randyrossi/vicii-kawari/boards/README.md

# Toolchain Versions

Xilinx Spartan6 boards : ISE 14.7
Efinix Trion boards : Efinity 2021.2.323.1.8
