randyrossi/vicii-kawari/util/raspi/README.md

# flash.py

A utility to flash Mini/Large Trion VIC-II Kawari boards using a Raspberry Pi. (Spartan6 boards require a Xilinx JTAG programmer.)

## Enable the SPI interface on the Raspberry Pi

    sudo raspi-config
    Select "Interfacing Options"
    Select "P4 SPI"
    Answer "Yes" when asked to enable the SPI interface.
    Reboot the Pi for the change to take effect

## Programming pad arrangements (top side of boards)

There is a 2x3 array of pads (+ 7th solder bridge) on the top of the board.

### For the Mini (rev 1.3 or 1.4 - bottom of board)

    MISO  CS    +3V  RST (left pad of solder bridge)
    GND   MOSI  CLK

### For the Large (rev 1.2 - right side of board)

         RST (bottom pad of solder bridge)
    GND  CS
    MISO MOSI
    CLK  +3V

Note: The solder bridges were meant to be temporarily closed and then re-opened for programming.  But if you plan on programming multiple times, better to solder a wire to the left or bottom pad (depending on mini / large).

## Wiring

    MOSI -> PIN 19
    MISO -> PIN 21
    CLK -> PIN 23
    CS -> PIN 24
    GND -> PIN 20
    RST (from solder bridge) -> Pin 25 (or just temp bridge the solder bridge)

## Power

The board must be powered by a +5V source.  You can use the C64's VIC-II socket as the power source or wire your own directly to pin 20 (GND) and pin 40 (+5V) of the bottom socket.

## Usage

   python3 flash.py read|write filename size

The files must be binary (.bit) files. Use the multi_hex_to_bit utility in the flash directory to convert .hex files to .bit.  The .hex files must be created using Efinity tools where the fallback image appears in slot 0 and the active image appears in slot 2.  The .bit files must match the expected file sizes exactly (as in the examples).

The Kawari will NOT BOOT if you have the RST pin still connected to Pin 25 (GND) of the Pi.  It is best to disconnect all wires from the Pi before booting the Kawari.  The connections will likely interfere with the FPGA loading the bitstream from the flash device. (You can leave the wires soldered, just disconnect from the Pi header)

## Examples

#### Flash to PCB

   python3 flash.py write bitstream.bit

#### Read from Mini PCB

   python3 flash.py read read_back.bit 1318912

#### Read from Large PCB

   python3 flash.py read read_back.bit 1359872
