randyrossi/vicii-kawari/boards/rev_4J/README.md

# POV

Change 4H(Mini) BOM as follows:

   Omit both oscillators
   Omit oscillator capacitors
   Omit oscillator resistors
   Omit eeprom
   Change T20 to T8

   DNP PAL1 (OSC)
   DNP NTSC2 (OSC)
   DNP C35
   DNP C36
   DNP R29
   DNP R30
   DNP R67
   DNP R4
   DNP IC1 (EEPROM)
