randyrossi/vicii-kawari/disks/demo/racer80/README.md

# VIC-II Kawari Version of Racer

This is a VIC-II Kawari version of racer adpated to fit 80 columns.
Use '4' to move left and '6' to move right.

Before running this sample, you must load and run the 80col-51200 wedge
AND load the vmem-49152 utility routines from the utility disk.

Initial submission by Jan Bloomvqvist.
Updated to use vmem-49152 utility by Randy Rossi
