randyrossi/vicii-kawari/disks/util/novaterm/README.md

# Novaterm 9.6c 80 Column Driver for VICII-Kawari

To install this, just rename kawari.ml as 80col.kawari and save it to the Novaterm 9.6c disk.  It will then show up as an option for an 80 column driver.

NOTE: MAX size of kawari.ml is 1791 bytes
