randyrossi/vicii-kawari/disks/util/flash/hex/multi/README.md

These files are created using efinity_pgm.sh tool.
This is manual step.

Point slot 00 to single hex file from single dir.
Point slot 10 to single hex file from single dir.

Create multi.hex file.  Use these naming conventions
so build_efinix.sh will find them.

kawari_1.19_1.19_multi_LG_DVI-27MHZ-S.hex
kawari_1.19_1.19_multi_LG_DVI-29MHZ-U.hex
kawari_1.19_1.19_multi_LG_RGB-32MHZ-U.hex
kawari_1.19_1.19_multi_LH-DOTC-1.2.hex
kawari_1.19_1.19_multi_LH-DOTC-1.5.hex
kawari_1.19_1.19_multi_LH.hex
