randyrossi/vicii-kawari/doc/MODELS.md

Back to [README.md](../README.md)

# Feature / PCB Design Matrix

PCB Design             |Kawari-Large<br>Spartan|Kawari-Large<br>Trion|Kawari-Mini<br>Trion|Kawari-POV<br>Trion|
-----------------------|------------|------|------------|----------|
Luma/Chroma            |Yes         |Yes   |Yes         |Yes       |
Extra RAM              |64K         |64K   |64K         |No        |
Flash updates from C64 |Yes         |Yes   |Yes         |Yes       |
New Video Modes        |Yes         |Yes   |Yes         |No        |
Detect Reset           |Yes         |Yes   |No          |No        |
Analog RGB             |Yes         |Yes   |No          |No        |
NTSC/PAL               |Switch      |Switch|Switch      |Fixed     |
Jumper Config MB Clk   |Yes         |Yes   |Yes         |Yes       |
DVI                    |Yes         |Yes   |No          |No        |
NTSC 50                |Yes         |Yes   |Yes         |No        |
Saveable Config        |Yes         |Yes   |Yes         |No        |
Old chips?             |Yes         |Yes   |Yes         |No        |
Current Draw           |~180ma      |~300ma|~180ma      |TBD       |
Variants               |(null),LD   |LG    |LH          |LJ        |

# Jumpers

Jumper configuration depends on the board version.  See [VARIANTS.md](VARIANTS.md)

# Feature Descriptions

## Luma/Chroma 
PCB is capable of Luma/Chroma based video (i.e. Composite or S-Video through the video out jack)

## Flash from C64
PCB firmware can be updated from the C64 using a flash utility disk

## New Video Modes
PCB can enable new video modes (i.e. 80 column mode)

## Analog RGB
Analog RGB header is present and can drive a VGA or RGB monitor.

## NTSC/PAL
JP Fixed : PCB must be configured as NTSC or PAL but cannot switch between standards. Motherboard clock must be working.

Switch : PCB can be told to boot as either 6567 (NTSC) or 6569 (PAL) (either by hardware switch or software selection). Motherboard clock is optional.

## Jumper Config MB Clk
PCB can be configured via jumper to use the mother board clock for either NTSC or PAL. (Used to avoid out of phase issue with some carts that use pin 6.)

## Old Chips
PCB can be configured to act as older NTSC and PAL models 6567R56A or 6569R1.

## DVI
PCB can output DVI over a HDMI connector (no audio).

## NTSC 50
Switch available to use NTSC color encoding with a PAL video signal. Allows color displays on 1702 or 1084 monitors (use VHOLD to get sync).

## Detect Reset
PCB can optionally connect to RESET line of motherboard.  This will restore colors to default values and turn off hires video modes after a soft reset.

## Saveable Config
PCB can remember changes to palette and other video settings between cold boots.
