randyrossi/vicii-kawari/doc/REPORTING.md

# Testing Firmware?

For those testing firmware (Thank you!), here are some some guidelines to avoid false positives:

1. Many games and demos are made for PAL systems only.  They will either not run at all on NTSC or show graphical glitches.  This is normal and happens on genuine VIC-II's as well. Since the Kawari can operate in either mode, you may lose track of which video standard you are running (especially over DVI where they look similar). If you find a glitch, please confirm the issue does not also occur using a genuine VIC-II in the same mode. If the issue happens using only the Kawari, then please report it.

2. GAL PLA replacement modules that use Lattice 25ns GALs are known to lock up the system on some games even with a real VIC-II (i.e. Ghostbusters, Fix it Felix Jr).  If you are using a PLA replacement, please try a genuine PLA if possible in the same machine to confirm it is not the PLA.  If the issue also happens with a genuine PLA, please report it.

3. A quick way to confirm whether a glitch is expected or not is to simply run the same game/demo on VICE emulator using x64sc.  You can start x64sc with -ntsc or -pal command line flags to match the system the game/demo is expecting.  If you see the same glitch, it is likely normal/expected.

4. Different KERNAL revisions clear the screen differently and this can make some games/demos appear to glitch on one system while run fine on another. An example is Higher Level (1992) by Lower Level. Another example is Galencia with a trainer screen that asks you to answer 4 Y/N questions.  On the earliest KERNAL revision, it appears the game has crashed because you get a black screen.  However, the trainer is just waiting for you to answer questions that are not visible. This is why comparing behavior with/without the Kawari on the same machine can be important.

5. Cartridges that use pin 6 (dot clock) of the cartridge port will often not work unless you use the motherboard clock setting. Keep that in mind when testing with specialty cartridges (i.e. REU)

6. If you are using a KungFuFlash cartridge, make sure you are using a recent firmware build.  Older KFF firmwares did not handle NTSC timing very well and caused many glitches.  If you have been using a PAL system for a long time with a KFF and are now running NTSC mode, you should update the firmware to avoid issues. 

7. KFF has trouble with systems whose clocks are too far off from the ideal NTSC or PAL color clock frequencies (with genuine VICs).  If you chose to use either NTSC or PAL motherboard clock as the source, there is a trimmer on the motherboard that can adjust the clock. Use that in combination with KFF's clock trimmer functionality to get better compatibility.  Using a Kawari on-board oscillator will perform better than motherboard clocks because it is generally of a higher quality.

8. If you use the motherboard's clock source for either NTSC or PAL and are getting a B&W picture, try adjusting the trimmer.

9. 250469 motherboards are not supported.  The Kawari is not a replacement for 8562/8565 chips. There are lots of known incompatibility issues.

# Known Issues (Not Kawari)

Issue|Description|Board|Details
-----|-----------|-----|-------
1 | Ghostbusters loaded from disk hangs on title screen | 250407 | Known to be caused by GAL PLA w/ Lattice 25ns GALs. Interesting though that the Ghostbusters cartridge when loaded by Kung Fu Flash does NOT crash this way.
2 | Fix if Felix Jr hangs after title animation         | 250407 | Same as #1
3 | Ghostbusters opening speech and laugh inaudible at startup. Music plays fast. After pressing RUN/STOP + RESTORE, speech + laugh now audible and speed is normal | 250407 | Happens when loading cartridge using Kung Fu Flash. Doesn't appear to happen when loading from disk.
4 | The kernel revision can change how some games/demos show color. | Any | See #4 above , (Higher Level, Quality - Father Time, Galencia Trainer)
5 | Checkerboard pattern using replacement RF modulator from VGP media.  | Any| Solution was to jumper JPLUM1 on the RF modulator for the Long Boards.
6 | Sparkle bug | Any | Caused by original CHAR ROM 901225-01 from the first week of 1983. The ROM timing must be a bit slower. The -02 revisions fix the issue.
