randyrossi/vicii-kawari/disks/demo/krps/jpg2krps/wednesday.jpg

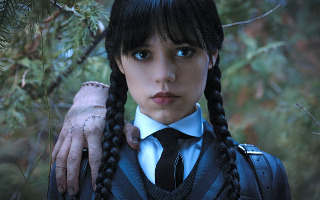
disks/demo/krps/jpg2krps/wednesday.jpg
