randyrossi/vicii-kawari/doc/images/c64-ntsc-full-annotated.png

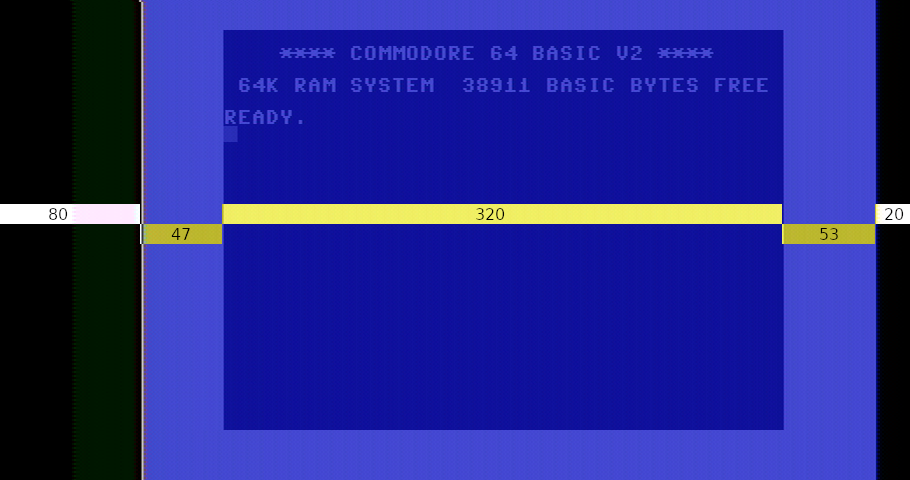
doc/images/c64-ntsc-full-annotated.png
