randyrossi/vicii-kawari/doc/images/c64-pal-full-annotated.png

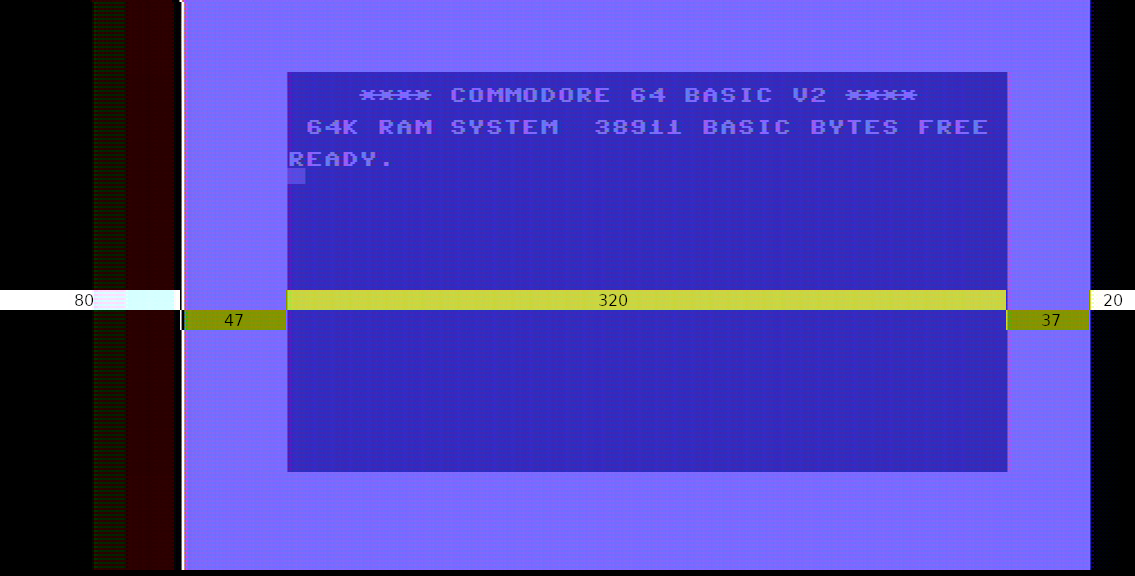
doc/images/c64-pal-full-annotated.png
