randyrossi/vicii-kawari/doc/images/lumacode/IMG_0302.jpg

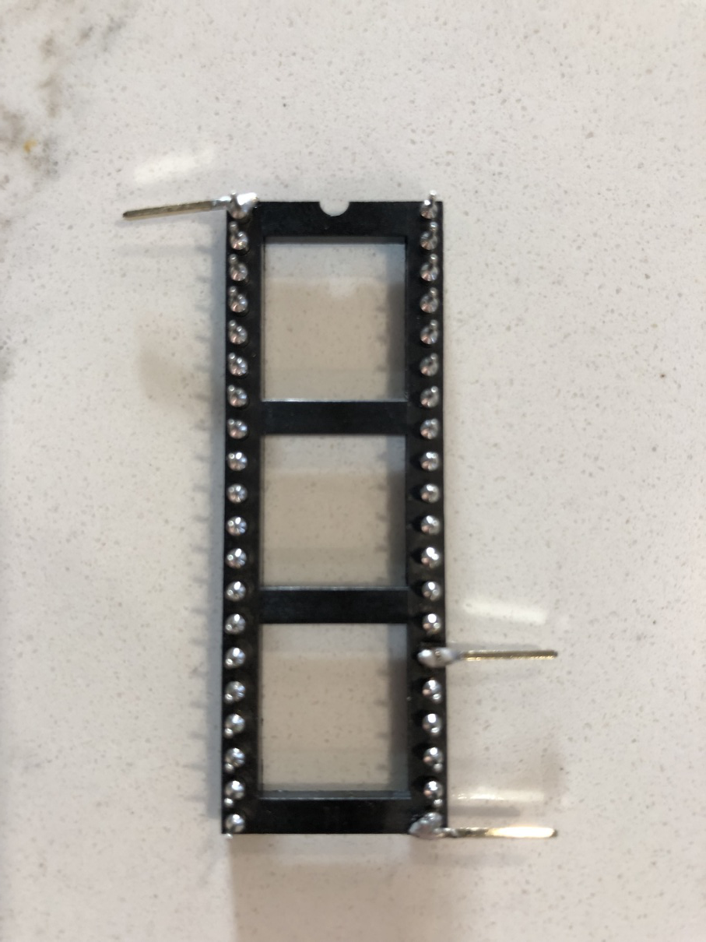
doc/images/lumacode/IMG_0302.jpg
