randyrossi/vicii-kawari/doc/images/lumacode/IMG_0308.jpg

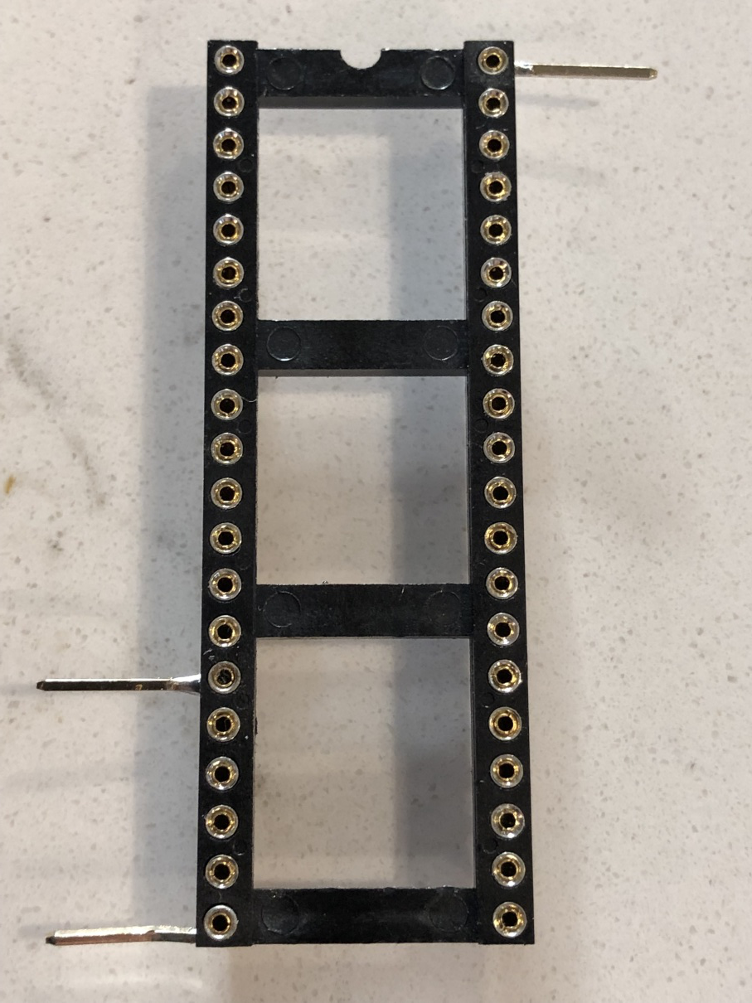
doc/images/lumacode/IMG_0308.jpg
