randyrossi/vicii-kawari/doc/images/lumacode/IMG_0309.jpg

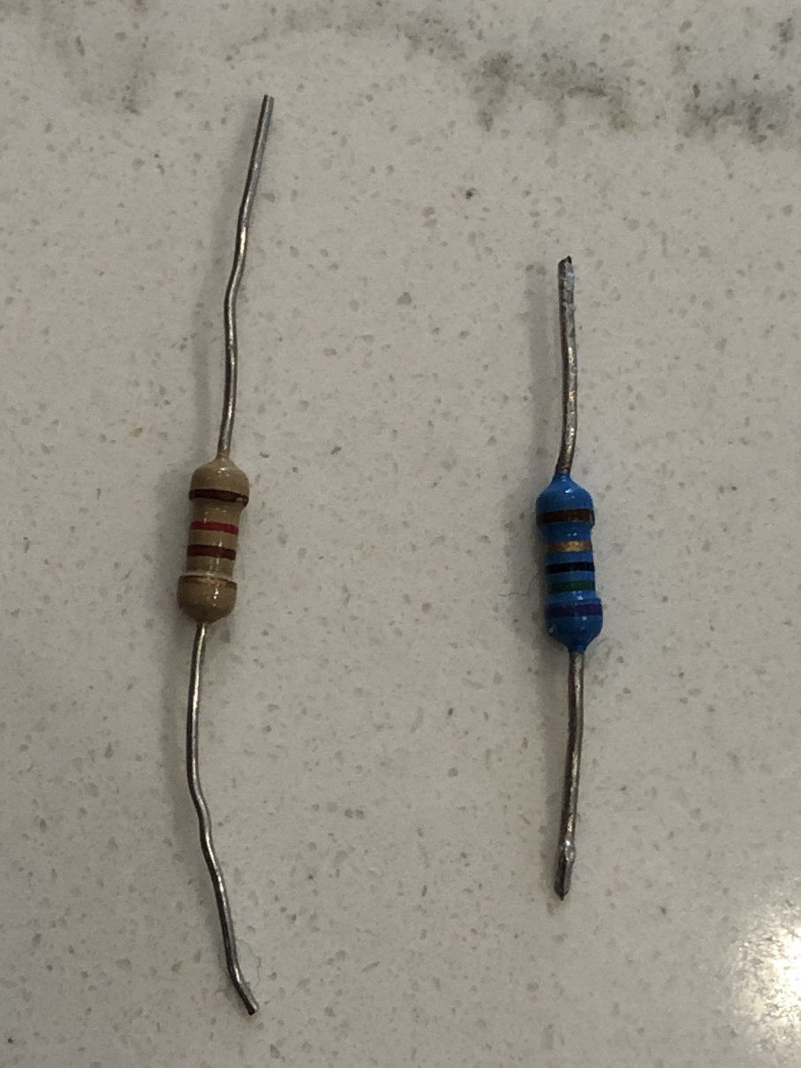
doc/images/lumacode/IMG_0309.jpg
