randyrossi/vicii-kawari/doc/images/lumacode/IMG_0312.jpg

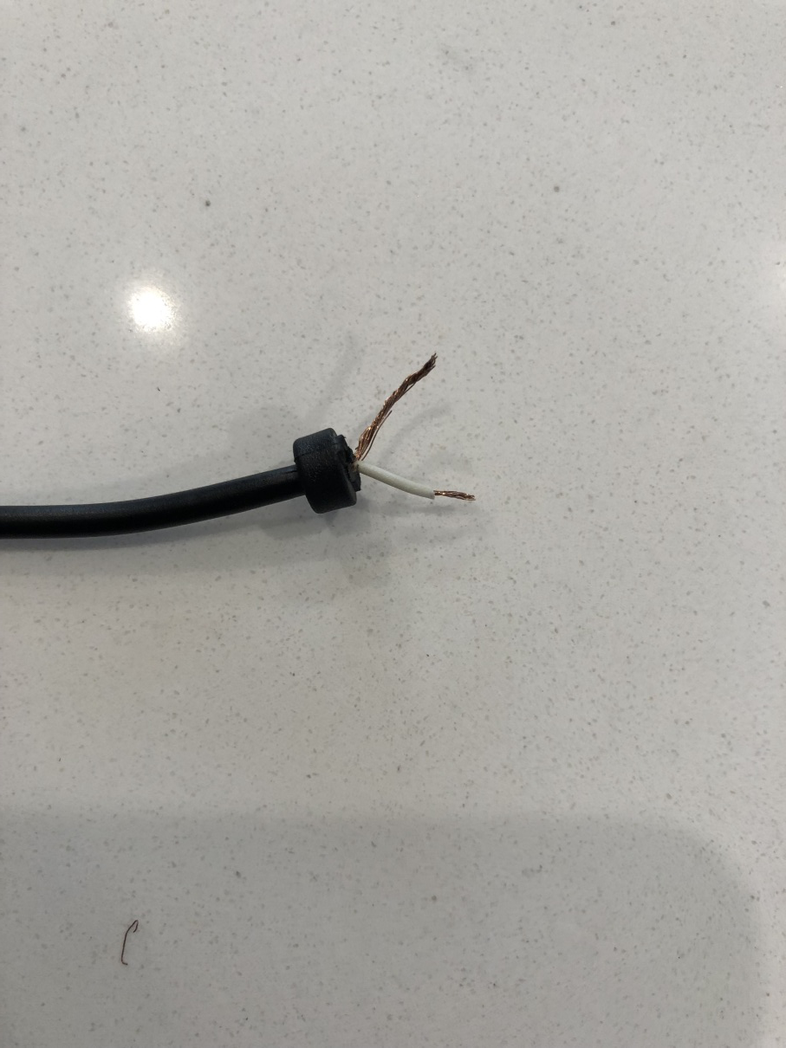
doc/images/lumacode/IMG_0312.jpg
