randyrossi/vicii-kawari/doc/images/lumacode/IMG_0313.jpg

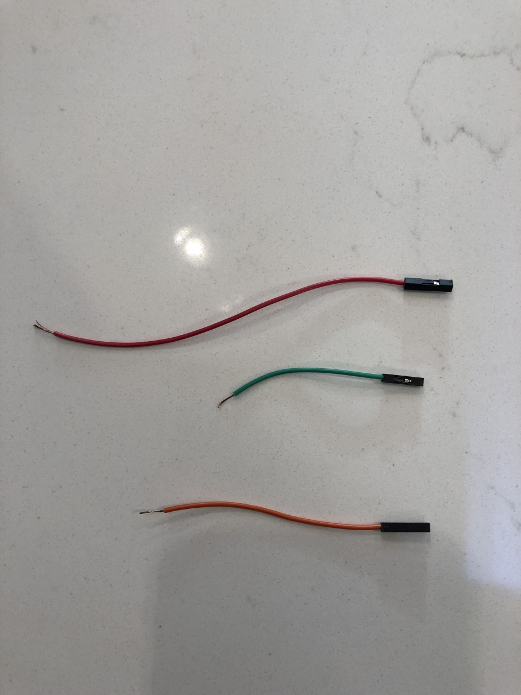
doc/images/lumacode/IMG_0313.jpg
