randyrossi/vicii-kawari/doc/images/lumacode/IMG_0316.jpg

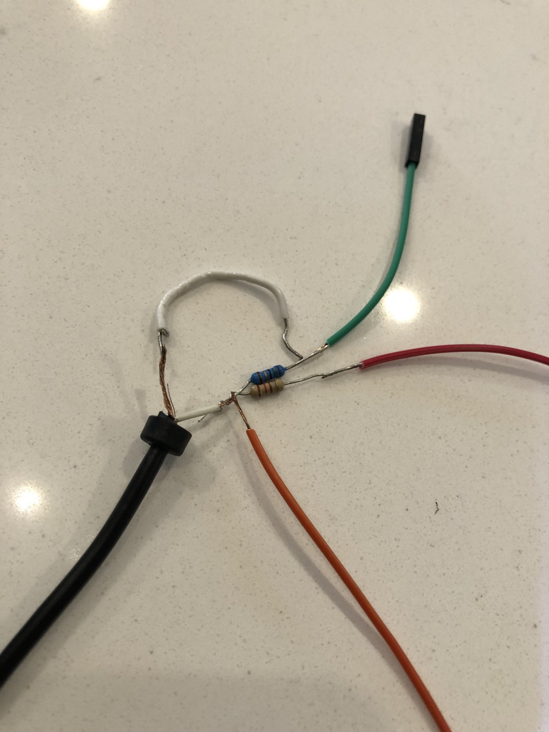
doc/images/lumacode/IMG_0316.jpg
