randyrossi/vicii-kawari/doc/images/lumacode/IMG_0318.jpg

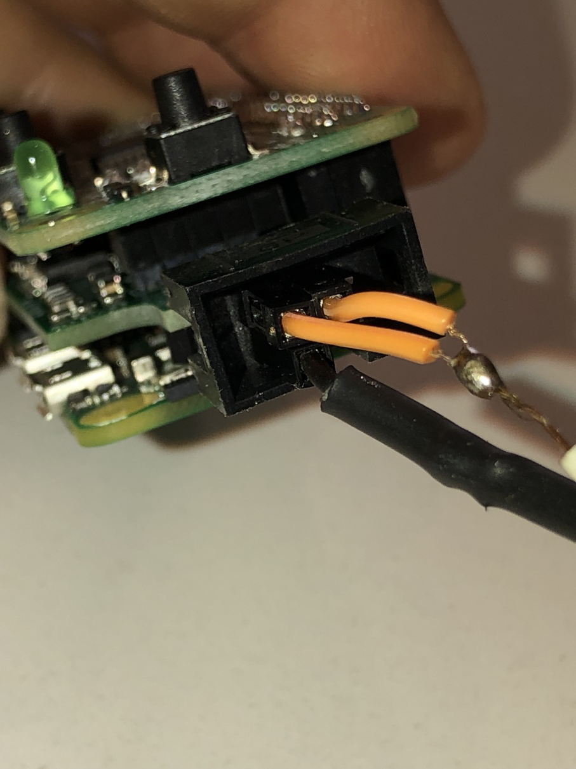
doc/images/lumacode/IMG_0318.jpg
