randyrossi/vicii-kawari/doc/images/lumacode/IMG_0322.jpg

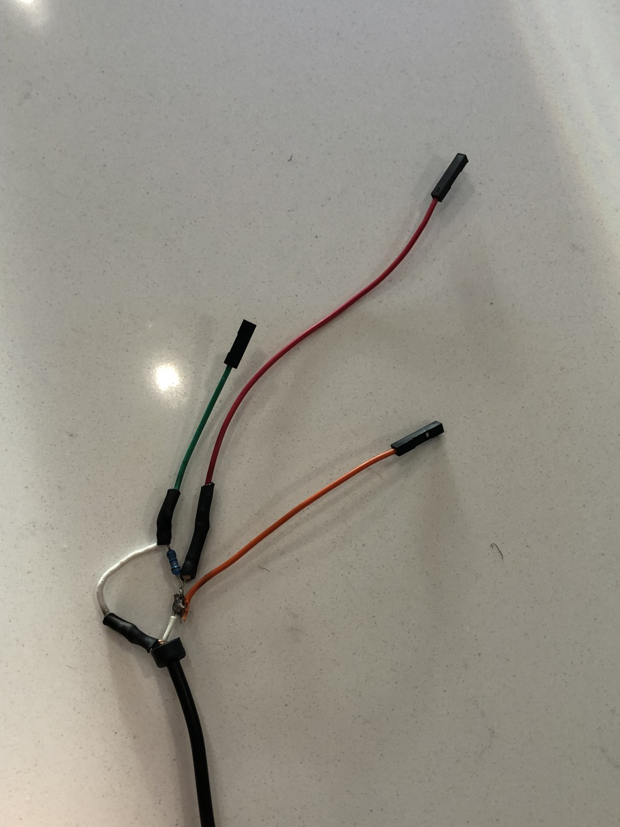
doc/images/lumacode/IMG_0322.jpg
