randyrossi/vicii-kawari/doc/images/lumacode/IMG_0324.jpg

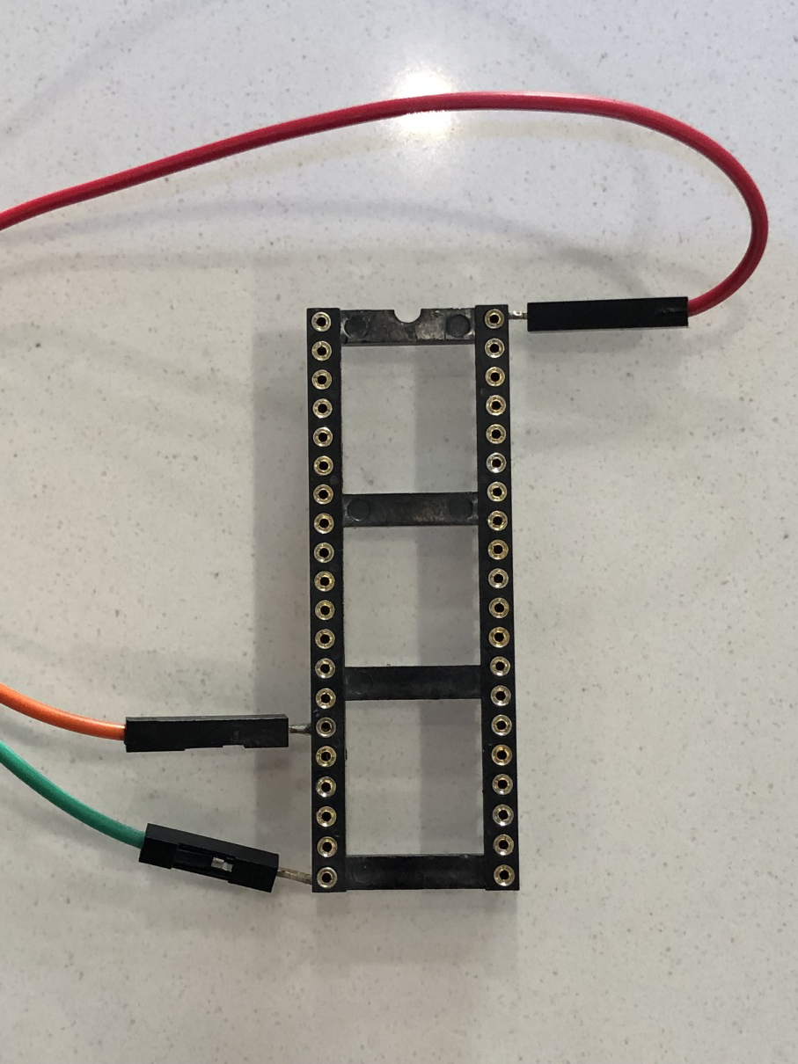
doc/images/lumacode/IMG_0324.jpg
