randyrossi/vicii-kawari/doc/images/lumacode/IMG_0328.jpg

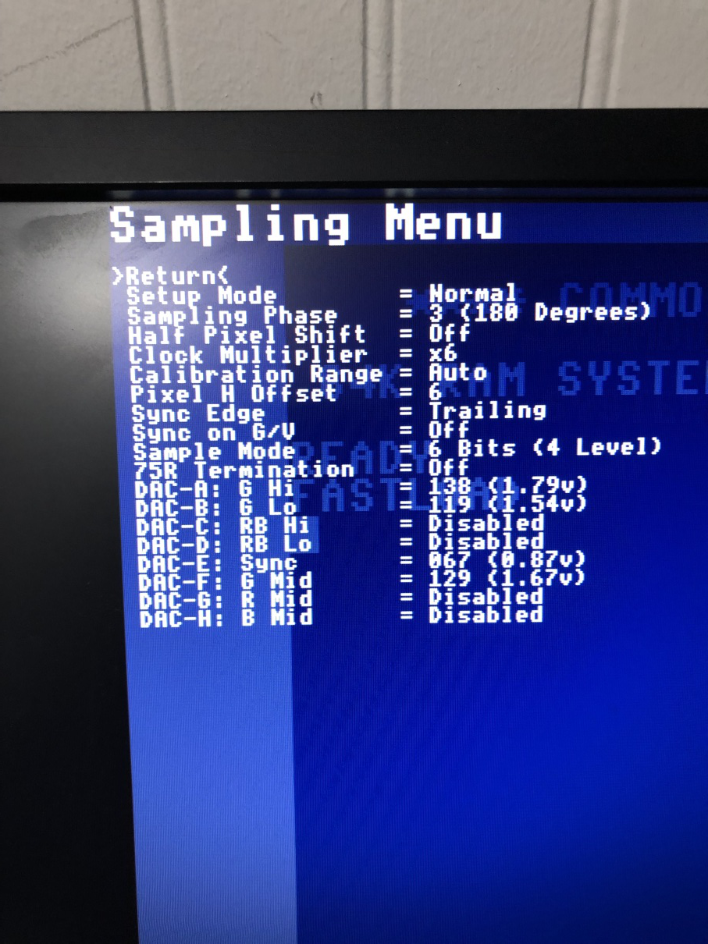
doc/images/lumacode/IMG_0328.jpg
