randyrossi/vicii-kawari/doc/images/lumacode/IMG_0329.jpg

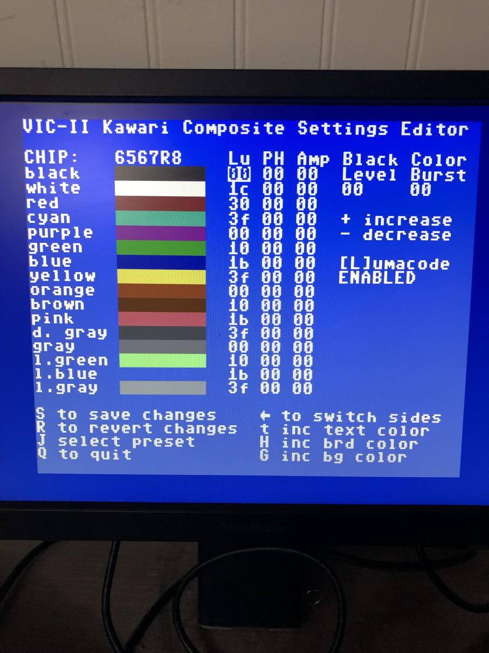
doc/images/lumacode/IMG_0329.jpg
