randyrossi/vicii-kawari/disks/util/tests/lumatest/README.md

Use to test proper resistor values have been
installed on the luma pin.

Set oscilloscope to 1V , 500us horiz timing.
Should see smooth sine wave with occasional break due to black bar
