randyrossi/vicii-kawari/disks/util/tests/rgbtest/README.md

Use to test proper resistor values have been
installed on the analog RGB header.

Set oscilloscope to 1V , 500us horiz timing.
Should see smooth sine wave with occasional break due to black bar

Hold C and V keys to slow it down.

Press SHIFT to move to next color channel.
