randyrossi/vicii-kawari/doc/BOARD_TESTS.md

# Boards

Motherboard Revision | RAM              | PLA      
---------------------|------------------|----------
250407               | DRAM 150ns       | Orig PLA 
250407               | SRAM (DIY Chris) | Orig PLA 
250425               | DRAM 200ns       | Orig PLA 
326298               | DRAM 200ns       | Orig PLA 
250466 (Sixty Clone) | DRAM 100ns       | J-PLA    
250466 (Sixty Clone) | SRAM (Saruman)   | J-PLA    
250469               | DRAM 100ns       | Orig PLA 

# Other (not tested by me)

Motherboard Revision | RAM              | PLA      | Status
---------------------|------------------|----------|-------
EVO                  | SRAM             | EVO PLA  | Reported working
Melius               | SRAM             |          | Reported working
