randyrossi/vicii-kawari/doc/TESTING.md

# Testing Checklists

# Hardware Permutations

Test                   | Complete
-----------------------|---------
Genuine 6510           |
Replacement 6510       |
Genuine DRAM           |
Static DRAM Saruman    |
Static DRAM CBM        |
Genuine PLA            |
Replacement PLA J-PLA  |
Evo64                  |

# VideoStandard Tests

Test               | Complete 
-------------------|---------
PAL Fallback Boot  |
PAL Active Boot    |
NTSC Fallback Boot |
NTSC Active Boot   |

# Hardware Tests

Test                   | LH | LG-DVI-U | LG-DVI-S  | LG RGB
-----------------------|----|----------|-----------|--------
Flash from & boot to   |    |          |           |
15Khz ON/OFF           |    |          |           |
Video Standard Switch  |    |          |           |
Config Reset Detect    |    |          |           |
Flash Lock Detect      |    |          |           |
Extensions Lock Detect |    |          |           |
Save Lock Detect       |    |          |           |

# PAL Software Tests

Test                   | LH | LG-DVI-U | LG-DVI-S  | LG RGB
-----------------------|----|----------|-----------|--------
New Pal                |    |          |           |
DonkeyKongJr           |    |          |           |
Ghostbusters           |    |          |           |
SuperMario             |    |          |           |
Gianna Sis Intro       |    |          |           |
Galancia               |    |          |           |
Edge of Disgrace       |    |          |           |
Errata                 |    |          |           |
Conclusion             |    |          |           |
Lunatico               |    |          |           |
Krestage 2             |    |          |           |
Krestage 3             |    |          |           |
Nine                   |    |          |           |
Next Level             |    |          |           |
Uncensored             |    |          |           |
Comaland               |    |          |           |
Super Zaxxon Crt       |    |          |           |

# NTSC Software Tests

Test                   | LH | LG-DVI-U | LG-DVI-S  | LG RGB
-----------------------|----|----------|-----------|--------
New Ntsc               |    |          |           |
DonkeyKongJr           |    |          |           |
Ghostbusters           |    |          |           |
SuperMario             |    |          |           |
Father Time            |    |          |           |
Pitfall Baloon Jump    |    |          |           |
Super Zaxxon Crt       |    |          |           |
