randyrossi/vicii-kawari/(threads)

Thread 1 (2022-05-23):

Support for external RGBtoHDMI upscaler

c0pperdragon, 2022-05-23:
What do you think about a very reduced variant of the Kawari (nearly POV) that has just one cheap additional output possibility besides the luma/chroma ?
This output signal would be a simple 75 ohm terminated video signal that could encode the 16 C64 colors in the necessary resolution using luma only.  This properitary signal could then be easily interpreted by an external RGBtoHDMI to generate perfect HDMI from it.

Re-purposing the RF out jack, this signal could be brought of the the case without drilling holes and by just cutting a single wire and maybe attaching a clip-lead to the RF jack.

IanSB already modified the RGBtoHDMI software to support such a signal, and I built a proof-of-concept setup and this looks really pretty easy.
Have a look at our discussion here:    https://github.com/hoglet67/RGBtoHDMI/issues/258

randyrossi, 2022-05-23:
Hi.  Yes, that does sound like an interesting (and useful) alternative for
video output.  I like the idea of repurposing the RF jack for a single wire
protocol.  It would only make sense for a POV since the colors are fixed by
the external RGB2HDMI board (my enhanced VIC-IIs can change the colors and
also have hires modes).

Just so I understand things correctly, the RGB2HDMI board needs a .7Vp-p
analog signal operating at 2x the dot clock (4 levels of luma, 2 bits per
pixel resulting in 16 values for each pixel)?  Sync signal would be 0V?

I can reprogram one of the pins on the RGB header on my large board
prototype to do this already.  There is a 6-bit DAC on each pin.  So I
could try this out with my existing hardware I think.  I don't have a
RGB2HDMI board though so I could only look at the signal on an oscilloscope.

On Mon, May 23, 2022 at 7:01 AM c0pperdragon ***@***.***>
wrote:

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

--
Randy Rossi

- "There are only two things that are hard about computer science; Naming
things, Cache Invalidation, and Off-by-one errors."

c0pperdragon, 2022-05-23:
Yes, you got it exactly right. The precise signal levels are not all that important because the RGBtoHDMI can fine-tune all comparator voltages programmatically. It is only imporant that the voltages are consistent so there is no need to recalibrate everything all the time.
In my experiments I just tried to get as close as possible to nominal 300mV sync and 700mV luma levels.  In this way the signal can be directly fed into a composite TV to have a first impresson on what is going on.

Availability of the RGBtoHDMI is a real problem right now. Not only the Raspberry Pi Zero but also the CPLD chip and even the necessary DACs are unavailable. So I could not even build a new device to let you test anything of this. I only have the one I am using myself.

I basically just wanted you to know about this idea to take this into consideration
Also I don't know about your plans to support 80 columns mode. This would be somehow in conflict with how of the luma-code signal now works, as it could not easily go beyond the standard C64 pixel clock speed.

Icelvlan88, 2023-05-01:
@c0pperdragon, did you ever get this going? Would be awesome to have RGB from your board and HDMI swell. Maybe RGB from composite connector areas and then micro hdmi from the small port beside.

randyrossi, 2023-10-11:
I purchased a RGBtoHDMI hat for the pizero and will see if I can get this working with the Kawari.  Looks like the luma signal should go directly from the VIC-II pin to both G and SYNC inputs on the hat.  The Kawari already has a 4x dot clock driving the luma levels so it should be trivial to change the generator to encode the 2 x 4 levels required to encode the 16 index values.  There's probably plenty of room on the Mini to make it software configurable (i.e. enable lumacode flag) in the firmware.  Not sure about the large as there is very little room left in the fabric for more features, but not really essential since it already has direct DVI out anyway.  I'll update this thread on progress once the hat arrives.

randyrossi, 2023-10-28:
@c0pperdragon  Would your RGB board mentioned in Issue #25 be capable of interpreting lumacode?  I just commented on that issue noting that it's not surprising the Kawari does not work with c0pperdragon RGB adapter.  The adapter probably has some expectations on the timing that the Kawari doesn't replicate exactly.  But it seems to me a more straight forward solution would be for the Kawari to encode something like lumacode via the luma pin and perhaps add a feature to this RGB board to be able to interpret it rather than trying to sniff the data/address and control lines to mimic the output.  Any thoughts?

c0pperdragon, 2023-10-28:
Yes. The timing my component video adapter expects is a result of direct measurements of the VIC-II's behaviour as well as some additional tweaks done to increase compatibility with some C64 add-on cartridges that also have their own way of messing with the VIC-II. So it is pretty complicated already and I will surely not touch this fragile construction.

I am not quite sure how you envision the use of the luma pin, but my board has no connection to any of the analog outputs, so it can not interpret this. In any case, the FPGA is so completely full that there is just no space for any new features. It was a nightmare to get all the user-requested features added that arrived over time and I had to restructure the logic serveral times already to squeeze a little bit of additional logic into the part.

Speaking of lumacode: My new and shiny VIC-II-dizer will probably have the same troubles matching your timings. But when the Kawari can produce proper Lumacode on the A/V output port, an external RGBtoHDMI could produce a HDMI signal. I don't know how noisy  such a signal would be, because it would use the original C64's video amplifier. Testing would be necessary.

randyrossi, 2023-10-28:
Yes, I was going to try outputting lumacode directly from the Kawari and
not have the luma signal reach the video amplifier circuit by placing
another socket underneath with a 'tap' to luma.  I should be able to feed
the luma signal directly into the RGBtoHDMI hat green/sync inputs, right?
Or perhaps I need a 75ohm termination to get the 1v p-p?  I am waiting for
a RGB2HDMI hat to arrive to try it out.

On Sat, Oct 28, 2023 at 4:03 PM c0pperdragon ***@***.***>
wrote:

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

--
Randy Rossi

- "There are only two things that are hard about computer science; Naming
things, Cache Invalidation, and Off-by-one errors."

c0pperdragon, 2023-10-29:
Yes, the RGBtoHDMI analog board (6 pin IDC socket) needs the signal on both those pins. It expects 1v p-p when it internally terminates the signal with 75ohm. The exact voltages can be adjusted.

randyrossi, 2023-10-29:
@c0pperdragon  I ordered an RGB2HDMI board from retrohackshack but I didn't realize when I ordered I also need the analog adapter as well.  Or should I have purchased the variant of RGB2HDMI with lumacode built in?  I didn't see that option on their site though.  Would it be possible to get one from you so I can try out my lumacode firmware update to the Kawari?  I see your Tindie site is out of stock though.  Or if you have a Kawari, would you be willing to try it out for me?

c0pperdragon, 2023-10-29:
I need to build more of those RGBtoHDMI with lumacode anyway, so I can reserve one for you. When bypassing Tindie this way, you can have it for $36. Please tell me your shipping details via email:  reinhard.grafl (at) aon.at

randyrossi, 2023-10-30:
Thanks.  I'm not sure I can get the required voltage levels to the analog inputs though.  The resistor values I use for 6 bit DAC on the Kawari are 249, 499, 1k, 2k, 4k, 8k.  I believe the luma line is pulled up to 5V by a 470ohm resistor in the RF modulator circuit.  If you are terminating the input with 75ohm, I don't think I can get the voltage to range between .3v and 1v.  I think it will be more like .45 to .68 which is a more narrow a range.  I don't know what the VICII-dizer does but in my case I'm trying to output lumacode directly from my board's luma pin.  My voltage range to the RF modulator is from approx 1V - 5V with my resistor values (and 0v for sync pulse).   I haven't thought about how to connect the luma signal to the analog input but I figure I would just add a socket with a 'tap' into luma.   I can probably sever the connection into the motherboard and use my own pullup to widen the range of voltages but not sure if it's possible to get between .3 and 1v.  Any thoughts are appreciated.

c0pperdragon, 2023-10-30:
Don't worry about the voltage levels here. The RGBtoHDMI can configure its input threashold freely in a very wide range. You an set the 4 comparators to basically everything between 0 and 3.3V ( or even 5V, I am not sure about the details right now). Of course, your signal is then not a completely standard-conform Lumacode. But as I have invented the standard myself, we have some flexibilty here&nbsp; ;-)

  Reinhard&nbsp;

  ----- Urspr&uuml;ngliche Nachricht -----
  Von: randyrossi ***@***.***>
  Datum: 30.10.2023 14:05
  An: randyrossi/vicii-kawari ***@***.***>
  Kopie: c0pperdragon ***@***.***>, Mention ***@***.***>
  Betreff: Re: [randyrossi/vicii-kawari] [FR] Support for external RGBtoHDMI upscaler (Issue #1)
  &nbsp; >
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

randyrossi, 2023-10-30:
Ok sounds good.  I found an adapter board and since I have a RGB2HDMI board on the way, I'll just wait for those to arrive.  When they do, I might ask for some help in configuring the voltage levels.  Thanks again!

randyrossi, 2023-11-11:
@c0pperdragon
Are the voltage levels configurable for the Commodore 64 Lumacode profile?

I see this in the config file:

sampling=5,5,5,5,5,5,5,1,1,0,6,0,0,0,0,2,0,7,1,0,65,32,256,256,10,48,256,256
geometry=80,33,336,208,416,240,4,5,3,2,16363636,1040,5000,262,4,0,0
palette=C64_Lumacode
palette_control=7
pal_oddlevel=33

Will I be able to modify the levels for the comparator here or will that have to be done in firmware?

c0pperdragon, 2023-11-11:
You can configure everything in the settings menu using the buttons. The threshold voltages specifically in the "Sampling Menu"&nbsp;&nbsp;

  Reinhard

  ----- Urspr&uuml;ngliche Nachricht -----
  Von: randyrossi ***@***.***>
  Datum: 11.11.2023 19:55
  An: randyrossi/vicii-kawari ***@***.***>
  Kopie: c0pperdragon ***@***.***>, Mention ***@***.***>
  Betreff: Re: [randyrossi/vicii-kawari] [FR] Support for external RGBtoHDMI upscaler (Issue #1)
  &nbsp; >
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

randyrossi, 2023-11-16:
@c0pperdragon

My analog board arrived.  I was hoping you could help me figure out how to wire up the luma line from my Kawari.

My 407 board is pulling up the luma line by a 470 ohm resistor (I think) to 5V.  The 6-bit DAC resistors for luma out on the Kawari are 249, 499, 1k, 2k, 4k, 8k.  The line is quite noisy though.  I'm not sure if it's this motherboard but I don't remember the signal being this noisy before.  I'll try switching boards.

I'm also not sure if I should disconnect the line from the motherboard altogether and add my own components rather than letting it reach the RF modulator circuit in the first place.

In any case, I placed a 120ohm resistor to GND on the luma output to get started.

The sync level is around 280mv.   I managed to get a sync lock by setting sync level to .28 in the sampling menu.

Then I wired the same line to green input and managed to fiddle with the levels to get an image but it's quite noisy.  I think the levels are very close together and I have to change both the luma levels for the 4 values and the sampling levels.  I just gave it a quick try this morning but I'll have more time on the weekend to experiment,

Any recommendations on a circuit I should build off the luma line?  I see the comparators can go up to 3.3v but I imagine I don't want large voltage swings between the 4 levels.  Thanks.

randyrossi, 2023-11-17:
I got a noisy image at least.
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

c0pperdragon, 2023-11-17:
So this is at least a proof of concept that it could work in principle. When your Kawari is made of recent parts it should not create much noise at all, so the poblems are very likely introduced by the original amplifier circuit. Maybe it is not even noise but just a low-pass behaviour that prevents the outgoing lumacode signal to switch to the required levels fast enough.
Check with an oscillosope. But do this on the end of the RGBtoHDMI while it is either plugged in, or use an extra 75ohm resistor from the signal to GND as an equivalent  termination.

In case the transitions are indeed looking slow, you could do a small modification to your RF modulator which was shown in one of Adrian Black's videos: https://www.youtube.com/watch?v=vTn36UaUfrk&t=1734s
But of course, I don't know if this is working with your machine

c0pperdragon, 2023-11-17:
The error pixels look a bit like a jailbar effect. I guess this could have the same cause as at the real VIC-II. Which is very likely a ground bounce when the single GND line needs to sink extra large amounds of current. This is first going through a single pin and socket connection and then through a labyrinth of traces to reach some decoupling capactor.
You could try to add some extra grounding here.

randyrossi, 2023-11-18:
I managed to get a stable image by building my own circuit with luma pulled up to 5V via 470ohm, then to GND by 185 ohms and turning off 75 ohm termination on the analog board.  This spread out the max/min voltage levels to .75, .95, 1.11, 1.32 and sync ends up around .3v.

Unfortunately, there is a lot of noise generated by the transceivers on the Kawari each time they switch direction of the address/data buses.  Its noise I was never able to eliminate.  No amount of extra grounding made a difference.  The magnitude is enough to prevent the 4 levels from being too close together.  Even though I get a stable image this way, I see some transitions cause color bleeding.  Maybe the problem is it takes too long for the level to drop/rise and the first half pixel level is registering as the wrong value. But then I don't understand why other colors that are encoded with the highest and lowest voltage level end up rendering properly.  It's only the first pixel in a the transition that does not get the right color.  I checked my encoding and it looks right in the simulator.

For example, WHITE to BLACK shows a green stripe in between.

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

c0pperdragon, 2023-11-19:
When the signal is indeed going through a significant low-pass, this could be explained this way:
A solid color X that toggles both samples between highest and lowes levels will probably just reach the threashold for high and low but not more.
When some color Y comes before that ends with the same level as the start of X, the voltage is drawn further to the extreme and the second sample of the first X pixel may not reach the threashold after that.

In any case, this whole low-pass behaviour can not be solved by any amount of adjustements. I am pretty sure this can be theoretically computed using https://en.wikipedia.org/wiki/Nyquist%E2%80%93Shannon_sampling_theorem, but
I do not have much more then my intuition here.

randyrossi, 2023-11-20:
@c0pperdragon  Yeah, I don't quite understand what causes some transitions to register the wrong color.  Here is the output from a small program I wrote that pairs every color with every other one (except itself).   When I have time I will look at the pixel encoding levels for the ones that work/don't work and see if I can come up with an explanation.

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

c0pperdragon, 2023-11-21:
On this picture nearly all transitions are wrong. This looks too consistent. Maybe the sampling offset in the RGBtoHDMI is set incorrectly so that not the samples belongin to one pixel are paired together, but always the second sample from one pixel and the first of the next.
If for some reason you have also mixed up the sample generation on the Kawari, solid colors would look correct, but it gives one wrong pixel on each transition.

randyrossi, 2023-11-21:
Yep, this was indeed a problem with my encoding.  I have a 4x dot clock and
I am using a 2 bit register to keep track of first / second pixel
transitions.  My initial value was off by 1 so all the transitions were
mis-aligned by 1/4th a pixel.  Once I 'straightened' out the alignment I
started to get clean transitions for most colors now.  There is still some
noise I have to deal with but I think I should be able to get this working
soon.  At least much better than before.  Thanks for your help!

On Tue, Nov 21, 2023 at 8:43 AM c0pperdragon ***@***.***>
wrote:

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

--
Randy Rossi

- "There are only two things that are hard about computer science; Naming
things, Cache Invalidation, and Off-by-one errors."

laubzega, 2023-11-21:
Please make sure to check cache invalidation next. ;)

IanSB, 2023-12-17:
@randyrossi
>There is still some noise I have to deal with but I think I should be able to get this working soon.
>Will I be able to modify the levels for the comparator here or will that have to be done in firmware?

As mentioned above you can customise the voltage thresholds for the different levels to anything up to 3.3v in the sampling menu (the actual video can be up to 5v) so if the signal is too noisy to match the standard lumacode thresholds I could include a custom Kawari profile in future RGBtoHDMI releases with different settings (which would probably be a good idea anyway to indicate Kawari support)

Also don't forget to re-run the auto calibration after changing anything with the analog signal.

If you get this working, some of the additional Kawari features could also be supported using additional signalling.
e.g. to support custom palettes you could dump the palette registers to a video line in blanking (rather like a teletext signal)
This has already been implemented for the BBC micro profile so that the 8 standard colours can be reprogrammed to be any RGB values so it is already known to be technically possible.

>My analog board arrived. I was hoping you could help me figure out how to wire up the luma line from my Kawari.

Which analog board are you using?
i.e. The dedicated lumacode/mono board or a standard CPLD board with the plug-in analog board (if so which issue?)

The later boards have very high bandwidth so can cope with up to about 60Mhz pixel clocks.

dabonetn, 2023-12-17:
I've got a dedicated lumacode board, a analog 4A-T with u7 installed, and 2 4A-T-GS8743 boards here.
Which should I be testing with?

Thread 2 (2022-08-17):

Random no starts in 250466 Motherboard.

dabonetn, 2022-08-17:
I've got a Kawari-Large board, and the first machine I tried was a 250466 board.
The board only boots randomly, but is rock solid with it's original vic II.

NTSC model, 8701 clock chip, using internal or external clock made no difference.
When it does boot, it works fine, failure mode is just a blank screen on power up.

Working fine on a 250407 and 250425 boards.

dabonetn, 2022-08-28:
I tracked the no starts to having both the HDMI and analog video cable connected.

My setup is a ASUS 24" hdmi/dvi/vga monitor, with the analog signal going thru a Extron 75C scaler to the vga input of the monitor.

Removing the analog cable lets the system boot everytime.

randyrossi, 2022-08-28:
When you get a black screen, can you try resetting the 6502 by grounding
the RESET pin temporarily?

If you then get a blue screen of life, try this: At the top-left of the
board there is a hole for a single pin labeled RST.  If possible, can you
try to connect that to the RESET pin of the 6502 and see if the blank
screen persists?  Use a pin grabber for the 6502 (if you have one) and you
can either solder or just hold the end of the wire to the RST hole. This
will hold the 6502 in reset until Kawari is ready.  I'm curious if that
makes a difference.

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

--
Randy Rossi

- "There are only two things that are hard about computer science; Naming
things, Cache Invalidation, and Off-by-one errors."

dabonetn, 2022-08-28:
Resetting the machine after power on makes no difference.

I did also try hooking the reset line up to the kawari, and that made no difference either.

I have a logic probe, a 1054z scope, and a cheap usb 8 channel logic analyzer for tools.

randyrossi, 2022-08-28:
I've asked another user with a 250466 to see if he can reproduce your
problem.  Waiting to hear back.

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

--
Randy Rossi

- "There are only two things that are hard about computer science; Naming
things, Cache Invalidation, and Off-by-one errors."

dabonetn, 2022-08-28:
Ended up being the cable.. See here.

https://github.com/randyrossi/vicii-kawari/issues/5

Closed 2022-08-28.

Thread 3 (2022-08-28):

HDMI noise/glitches when analog cable isn't connected.

dabonetn, 2022-08-28:
Kawari large board, on 250425 MB.

There are random sparkles on the hdmi output, when HDMI is the only output connected.
When both analog and HDMI connected, the HDMI is clean.

To test, power on and set background color to black.
Removing the svideo plug from the switcher brings back the glitches, inserting it makes the glitches go away.

laubzega, 2022-08-28:
Are you able to only connect GND coming from the analog cable?

dabonetn, 2022-08-28:
Ground the video cable, and adding a termination resistor to the composite signal made no difference.

I just put the kawari into a different motherboard, and it's working without glitches. (250466 )

randyrossi, 2022-08-28:
The HDMI is plugged into a switcher?

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

--
Randy Rossi

- "There are only two things that are hard about computer science; Naming
things, Cache Invalidation, and Off-by-one errors."

dabonetn, 2022-08-28:
HDMI is straight to the monitor.

My setup is a ASUS 24" hdmi/dvi/vga monitor, with the analog signal going thru a Extron 75C scaler to the vga input of the monitor.

randyrossi, 2022-08-28:
Can you reproduce the sparkles and touch a jumper wire from the
shielding on the micro hdmi connector to one of the GND holes on the analog
RGB header? Any difference?

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

--
Randy Rossi

- "There are only two things that are hard about computer science; Naming
things, Cache Invalidation, and Off-by-one errors."

dabonetn, 2022-08-28:
I can confirm, adding a gnd between the hdmi shield and gnd on the header eliminates the issue.

dabonetn, 2022-08-29:
Also if the gnd to shield is present on power on, the system doesn't boot. unplugging the hdmi allows boot.

Thread 4 (2022-08-28):

Update compatibility list - REU needs dot clock.

dabonetn, 2022-08-28:
The REU (1750,1764/1700 and clones use the dot clock signal for dram control signals.

https://rr.pokefinder.org/rrwiki/images/9/90/1750_1764_Service_Schematics.pdf

See page 4.

So needs the motherboard derived clock to work.
Good thing to add under the Hardware Compatibility matrix.

dabonetn, 2022-08-28:
Also, looking at the schematics, would it be possible the kawari to output a new correct dot clock for ntsc/pal ? Then you could remove the 8701 from the board to enable pin 22 as an output with the new dot clock.

randyrossi, 2022-08-28:
Thanks.  I'll update the README.

I reserved a pin on the large board that can output a dot clock.  But I
disabled it in the firmware.  I wasn't confident in outputting a clock
signal back into the motherboard via pin 22. I suppose it could work.

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

--
Randy Rossi

- "There are only two things that are hard about computer science; Naming
things, Cache Invalidation, and Off-by-one errors."

Closed 2022-08-28.

Thread 5 (2022-08-28):

HDMI cable causing phantom power back to Kawari (large)

dabonetn, 2022-08-28:
As you can tell by the reports, I finally had a chance to sit down and test some.

I've got 2 micro hdmi to hdmi cables (6' generic) that I bought at different times for pi4 and another project.

One works fine with the kawari, the other does the following.

After the first boot, when I turn off the 64, LED1 on the kawari is faintly lit.
Turn on the 64 after this doesn't boot, until I either unplug and then plug the hdmi cable back in, or power cycle the monitor.

This causes the led to completely go out, and then the 64 boots normally.
The led doesn't light up until after the first boot,  so monitor seems to wait until after it has a valid signal to provide voltage back down the hdmi cable.

randyrossi, 2022-08-29:
It sounds to me like your monitor is sourcing current which is not supposed to be the case for HDMI sinks.  The spec says only display sources are supposed to provide current.  There is a load switch on the board that prevents back-feeding.  This case would have powered the 64 on the previous version of the board which is no something you want.  But even though I added the load switch, it could be the board is not playing nice with your monitor for some reason.

Is your monitor's HDMI port MHL compatible by any chance?  It could be that your monitor does not detect the 5V on pin 18 and starts providing its own current to power the attached device.  Can you share the model # of the monitor?  I'm not sure why swapping out the cable would make a difference though.

dabonetn, 2022-08-29:
Asus VE248H, only lists HDMI 1.3 as the port, no extras. It's a standard computer monitor.

Here's a link to the manual.

https://dlcdnets.asus.com/pub/ASUS/LCD%20Monitors/VE247VE248VE249/VE247-VE249_English_V1.pdf

I've put things away for the night/weekend, but I'll think on if I have a way to pinout the cables later.

dabonetn, 2022-08-29:
I've ordered hdmi breakout boards and will be able to find out the different cabling.

dabonetn, 2022-08-30:
I did a little more testing tonight with a small micro hdmi male to standard hdmi female adapter, along with the 2 full cables.

Link to the adapters.
[https://www.amazon.com/gp/product/B00JDRHQ58/ref=ppx_yo_dt_b_search_asin_title?ie=UTF8&psc=1](url)

All 3 of the following monitors show the phantom power.

Asus VE248H, Westinghouse L2410NM, Samsung LS27E310HSG/ZA.

Voltage across the led when fully powered is 1.8v
When phantom powered it's 1.5v which is also present on the 3.3 regulator output.

Phantom power persists even when the kawari is removed from the motherboard.

So 2 out of 3 cables are showing phantom power. What cables are you using?

dabonetn, 2022-08-30:
Also, is this something that may be involved?

[https://support.xilinx.com/s/question/0D52E00006hphYzSAI/unintentional-backpower-spartan6-through-io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](url)

randyrossi, 2022-08-30:
Yeah, that sounds identical to this issue.  I am using 4 pairs of TMDS
lines to drive my DVI signals directly from the FPGA.  I have an AP2331W
load switch connected to the 5V line which prevents sourcing current into
the board from pin 18 but from this article it sounds like this can still
occur due to the pull ups.   The pullups are on the sink side (monitor) as
per the HDMI spec. I just don't understand why I'm never seeing the issue
myself.  I don't use an adapter.  I have a single cable with micro-HDMI on
one end and HDMI on the other. You said one of your cables works okay?
Which one was that?

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

--
Randy Rossi

- "There are only two things that are hard about computer science; Naming
things, Cache Invalidation, and Off-by-one errors."

dabonetn, 2022-08-30:
The one cable I have that doesn't feed back is a generic one I've had for awhile. Can't remember where I got it.
I work for a computer shop, and we have gotten all kinds of hdmi cables over the years.

randyrossi, 2022-08-30:
Would you be able to check the HDMI connector for solder bridges?  I'm wondering if there might be a solder bridge on the back pins of the connector somewhere.  It's hard to tell sometimes.  But perhaps there is a short on the receptacle end and older cables don't matter because that pin may not be connected.  But newer cables might have a connection to the monitor port which may explain this.  Just a thought.

In the meantime, I will try to reproduce it here.

dabonetn, 2022-08-30:
Just looked under the microscope, and didn't see anything. But it's a very hard thing to see on that connector.
My breakout boards will be in on friday, maybe they will be able to show me a short.

dabonetn, 2022-09-03:
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

First 2 columns provide phantom power, the 3rd does not.

The numbers are what is on the breakout boards, I'm not sure if they actually mean the hdmi pins. (Cheapest breakouts I could find on Amazon.)

randyrossi, 2022-09-03:
Can you describe the setup? You have two breakout boards and are testing
the cable connections between micro end and the full end through the
full-micro adapter?  The numbers don't really make sense to me.  I think
the numbers on the board are supposed to match the pin numbers.

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

--
Randy Rossi

- "There are only two things that are hard about computer science; Naming
things, Cache Invalidation, and Off-by-one errors."

dabonetn, 2022-09-03:
Ok, getting out a needle and figuring out the actual hdmi pinout for the break out boards, the cable that doesn't feed phantom power has the following pins NOT connected.

2, 5, 8, 11, 14, These are the grounds for TMDS 1,2,3 clock, and then HEAC -.

dabonetn, 2022-09-03:
And just for sanity check, using a one to one cable, I see that 2,5,8,11,15 & 19 are connected together on the Kawari board, correct?

dabonetn, 2022-09-03:
Also, if the VGA connector is also connected to the monitor along with the HDMI, the cable that works HDMI only still provides phantom power.

randyrossi, 2022-09-03:
It makes sense that the cable that 'works' doesn't have those pins
connected.  Because without those pins there is no return path.  So if you
provide one (like VGA cable to the monitor for example), then the return
path is present. But it doesn't make sense for those pins to not be
connected (cheap cable?).

So I think the issue is that if the monitor is pulling up the TMDS lines,
it will power the core as mentioned in the Xilinx article.  With my
monitor, I can reproduce the phantom power issue but only before the
monitor gives up on finding a signal.  Once it gives up, the voltage is
gone and I can boot again.  If you wait a while, does the dimmed LED
eventually turn off?

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

--
Randy Rossi

- "There are only two things that are hard about computer science; Naming
things, Cache Invalidation, and Off-by-one errors."

dabonetn, 2022-09-03:
Asus monitor goes into standby mode, but never kills the pull ups.
Westinghouse has no standby (Ancient, but has Composite, Svideo, Component, VGA and HDMI.

dabonetn, 2022-09-04:
I went and grabbed a Acer V227bmix and a Asus VE228 from my stock to try.
The Acer does power off the pull ups after it goes into suspend, but the Asus doesn't just like it's 24" brother.

But for using the monitors, none I have tried allows for scaling the HDMI input, but all allow for the scaling of the VGA input, so vga is looking like the winner for a proper display.

randyrossi, 2022-09-05:
It looks like whether this happens is going to be at the mercy of the monitor.  If the monitor times out and drops the power, you can boot by just waiting a few seconds.  Another work around is to use an HDMI switch.  My switch does not power the core even when it is the display selected by the switch.  So it looks like the work arounds are:

1> Wait for monitor to give up its scan for a signal
2> If 1 is not an option, turn off the monitor before powering the C64
3> If 2 is not an option, use an HDMI switch that does not power the core
4> If 3 is not an option, use an HDMI switch and temporarily switch to a different input

Unfortunately, the proper way to deal with this is to add an HDMI buffer IC which will add more space/cost and potentially trigger license issues.  I"ve read that even if you use an IC that is licensed for HDMI, your device still requires an HDMI license.  (Kawari uses only DVI protocol and no HDMI).  But I wanted to stay clear of even a hint of any HDMI license issues.

Do you think these workaround are acceptable?  If not, I might just drop the HDMI connector entirely from my design as it is proving to be quite a pain.

dabonetn, 2022-09-06:
IMO, I would drop the DVI support, since you don't have a easy way to force 4:3, and maybe just concentrate on RGB/VGA and maybe optional component output instead of the DVI.

Or different firmware to pick between RGB and component.

There are so many devices like the RetroTink, etc, getting the highest quality out of the 64 we can while keeping the correct aspect ratio seems to be the way to go in my book.

The 15K RGB out looks great on my Sony PVM.

randyrossi, 2022-09-07:
I opened a poll on the discord channel.  So far people like the idea of easy HDMI connection even with the boot issue and sometimes lack of perfect 4:3.

BTW:  Did you have any issues closing up the 250466 machine with the kawari installed?  Someone is asking on the discord and I don't have one to try.

dabonetn, 2022-09-08:
I have a few loose boards that I've throw in a breadbin case to test.
I haven't tried any slim cases at all.

Thread 6 (2022-08-30):

Kawari-Large VGA Output - NTSC Colors are way off.

dabonetn, 2022-08-30:
Wired up a RGB header to VGA connector today, and PAL looks great, but NTSC has no blue.

Here's images of color bars, same cable used for both, just changing to either a pal or ntsc vic mode.

https://imgur.com/a/yyPkJ2I

randyrossi, 2022-08-30:
Can you run RGBED for the ntsc mode and post a pic of what that looks
like?  Try the option to reset to defaults and see if you get color.

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

--
Randy Rossi

- "There are only two things that are hard about computer science; Naming
things, Cache Invalidation, and Off-by-one errors."

dabonetn, 2022-08-30:
RGBED picture posted is the same link above.

I have tried just hitting D in the config program with no results, and I tried all the presets in rgbed and none had blue.

randyrossi, 2022-08-30:
Let me try to reproduce on my board.  Will get back to you.

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

--
Randy Rossi

- "There are only two things that are hard about computer science; Naming
things, Cache Invalidation, and Off-by-one errors."

randyrossi, 2022-08-30:
I can see activity on all channels on my oscilloscope.  Can you unplug from
the monitor and attach a scope to the blue channel in NTSC mode?

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

--
Randy Rossi

- "There are only two things that are hard about computer science; Naming
things, Cache Invalidation, and Off-by-one errors."

dabonetn, 2022-08-31:
Pictures are on the link now.
NTSC Blue and Green
PAL Blue and Green
At the boot screen.

dabonetn, 2022-08-31:
VGA and power supply are the only cables attached to the machine currently.
Monitor and c64 are running off the same power strip.

randyrossi, 2022-08-31:
Very odd!  The only real difference between the two modes is the timing/resolution.   Your monitor must not like the values I have set.  But it's very strange for only blue channel to be ignored like that.

I can give you a flash update with registers that let you POKE different timing values while you are using the machine.  Maybe we can adjust them to get a proper image?  In the meantime, can you try a different monitor?  Is the blue channel also missing for the 6567R56A mode?

The values we can change are front porch, sync interval and back porch values for horizontal and vertical.  The resolution is (obviously) fixed.  I've tested these parameters on the only VGA monitor I have as well as an up-scaler.  So not an exhaustive list of devices.  But these timing values are not standard at all and I'm not surprised if they don't work on all monitors.

dabonetn, 2022-08-31:
Tried on the Westinghouse and a Samsung Monitor.
Same results with both.

I don't have a straight VGA crt monitor anymore to test with.

randyrossi, 2022-08-31:
Ah, I didn't realize this was not a CRT.  These are LCD monitors with VGA
inputs?  Let me see if I can reproduce the issue here first and then I can
tweak the timing myself.

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

--
Randy Rossi

- "There are only two things that are hard about computer science; Naming
things, Cache Invalidation, and Off-by-one errors."

dabonetn, 2022-08-31:
I've hooked up a Sony PVM-01351Q for 15k RGB using Csync on the Hsync pin.

Pictures have been added to the imgur post, and the PAL rgb is much brighter than the ntsc on a analog monitor also.
Turning the brightness control to maximum gives a passable, but still very dark ntsc picture.

randyrossi, 2022-08-31:
You should be able to get the same brightness from the NTSC display using
RGBED.  If you find more suitable defaults, I can make them the defaults in
the bitstream.  I think the values chosen come from VICE's color palettes
and they are muted for NTSC.

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

--
Randy Rossi

- "There are only two things that are hard about computer science; Naming
things, Cache Invalidation, and Off-by-one errors."

dabonetn, 2022-08-31:
The camera doesn't really do it justice, on the default output, it's looks black and white on the boot screen.
Instead of manually adjusting every color, is there an overall brightness setting?

Like white is muted, very muted, but it seems to have a max value of 3f, correct?

randyrossi, 2022-08-31:
No, there is no brightness control but it could be added to that editor.
But it feels like something else is going on with NTSC.  I'm looking at
those values in the pic and they should be close to what you are seeing
with PAL in terms of brightness.  Probably related to the B/W issue on the
LCD monitors.   I tried my own LCD monitor's VGA and I got color on both
PAL and NTSC modes.  It was darker in NTSC but still color.   But like I
said, the only difference between those modes is the timing parameters.
I'm going to try increasing the drive strength on the RGB channels to see
if that makes a difference.  I have two other monitors to try so hopefully
I can repro this better here.

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

--
Randy Rossi

- "There are only two things that are hard about computer science; Naming
things, Cache Invalidation, and Off-by-one errors."

randyrossi, 2022-08-31:
I have a monitor that exhibits the 'no/low blue' color information
problem.  What happens when you POKE 53280,0 to make the border black?  Do
the colors for text then show up properly?

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

--
Randy Rossi

- "There are only two things that are hard about computer science; Naming
things, Cache Invalidation, and Off-by-one errors."

dabonetn, 2022-09-01:
Yes it does.

randyrossi, 2022-09-01:
Okay, it looks like color 0 is influencing the other colors.  Probably
because I'm doing something silly during the blanking intervals.  Instead
of actually setting the level to 0 as it should be, I'm probably using the
border color.  So that's probably why it starts working when you set the
border color to black.  I'll look into it.

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

--
Randy Rossi

- "There are only two things that are hard about computer science; Naming
things, Cache Invalidation, and Off-by-one errors."

dabonetn, 2022-09-01:
Sorry to keep opening issues. Any other feed back on the other 6 units?

randyrossi, 2022-09-01:
No problem. Keep 'em coming! Thanks for reporting these issues.

No, I haven't heard from the other 6 owners yet.

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

--
Randy Rossi

- "There are only two things that are hard about computer science; Naming
things, Cache Invalidation, and Off-by-one errors."

randyrossi, 2022-09-01:
I have a fix for this.  The horizonal sync pulse was a bit too short.  Increasing it fixed the dark no/low blue issue.  I will test with more monitors and if they all look good I will have a firmware update for you soon.

randyrossi, 2022-09-01:
Can you try this firmware update and let me know if it fixes your NTSC/VGA
color issues?

This worked for me on two of my monitors.  You will have to remove the
flash jumper to allow flashing the device before powering it on.  Just
LOAD"*",8,1 and follow the instructions.  You can use either the individual
.d64 disks or a single d81 if you have that option (it will still prompt to
swap disks bit just hit enter).  The fast loader will not work on SD2IEC.
So use either a Pi1541 or real 1541.  Otherwise, it will be slower.

https://accentual.com/vicii-kawari/downloads/flash/LD/kawari_flash_1.8_LD_multiboot.zip

It's a good idea to verify but is not necessary.
Your firmware should report 1.8 after this is done.

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

--
Randy Rossi

- "There are only two things that are hard about computer science; Naming
things, Cache Invalidation, and Off-by-one errors."

dabonetn, 2022-09-01:
I'll try in a few, but have you thought about releasing non fast loading software so sd2iec users can use it?

I have a 1541 Ultimate, but I tend to use my sd2iec units much more often. That would also make them available to backbit and kungfu flash people.

randyrossi, 2022-09-01:
I think you can still use SD2IEC but you have to disable (or not choose)
the fastloader when it asks you.

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

--
Randy Rossi

- "There are only two things that are hard about computer science; Naming
things, Cache Invalidation, and Off-by-one errors."

dabonetn, 2022-09-02:
Colors look good!. As for the fastloader, I meant in general, having to use a specific device to run Kawari inside is just a little annoying. Given any more thought for dot clock from the kawaris? Great use case is using a NTSC for pal games like sonic the hedgehog. You can only get full speed on a PAL output. Sam's Journey requires a REU for NTSC users also.

Closed 2022-09-02.

Thread 10 (2022-11-14):

C64 Reloaded MK2

dougwj, 2022-11-14:
Tried the small board with my MK2 and it boots but the screen has text characters jumping all over. Is there a specific jumper setting or some update to the MK2 I need to make? I can include pics of the screen and my MK2 if needed.

Thank you,
Doug.

dougwj, 2022-11-14:
I went back and read your email from Sept 6th 2022 and you mention that you might need someone to test with an MK2. If you do not have anyone yet I volunteer. Not sure what you program them with but I have a TL 866II+, breadbin boards, short boards and MK2 boards. I was thinking you mentioned someplace (youtube maybe?) that you had been able to test with an MK2 that was lent to you for a while.

Thank you,
Doug.

randyrossi, 2022-11-14:
You can try this firmware for the MKII:

https://accentual.com/vicii-kawari/downloads/flash/LH/kawari_flash_1.8_MKIILH_multiboot.zip

You will need to program it from a working C64 though.  You can either use
one .d81 image (and hit return when promted) or swap the .d64 images (when
prompted).  If you use a Pi1541, you need the 1581 ROM image installed.
Otherwise, mount all 5 disks in the queue and swap.  SD2IEC will work but
you won't be able to use the fast loader so it would be slow.  A real 1541
would also be slow but possible.

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

--
Randy Rossi

- "There are only two things that are hard about computer science; Naming
things, Cache Invalidation, and Off-by-one errors."

dougwj, 2022-11-14:
The firmware update works perfectly. I used an ASSY NO 250466 Breadbin MB with a 1541 Ultimate 2+ to update the firmware. I have a a Sony Bravia XBR  with an S-Video cable for use with the MK2 and the 250466 and both have excellent video output quality.

If you ever need short board 64C testing I have 1 PAL and several NTSC motherboards that I can test with.

Thank you so much for providing the firmware update as I prefer to use the MK2 board in hopes that it will help keep these old chips running.
Doug.

slime1982, 2022-11-29:
Hi, I have just received a mini board from VGP and am intending to use it with a Reloaded MK2. Unfortunately I don't have a working long board I can use to update the firmware. I do have a working 'C64E' board with an 8565. Would it be ok to install the mini in this temporarily to do the firmware update?

Failing that, is it possible to re-flash the board directly? If so, what equipment would I need to do it?

Many thanks,

Simon.

randyrossi, 2022-11-29:
Yes, you can use the short board to flash the Kawari.  If the board doesn't
boot the first time in your short board, just power down and try again.
Some short boards don't start right away.   Let me know how it goes.

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

--
Randy Rossi

- "There are only two things that are hard about computer science; Naming
things, Cache Invalidation, and Off-by-one errors."

slime1982, 2022-11-29:
That's great, thank you!

I won't be able to get to it until the weekend, but I'll let you know how it goes :)

Many thanks,

Simon.

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

slime1982, 2022-12-04:
Hi,

today I temporarily installed the mini in my short board to update it to the firmware you linked above, using the .d81 and a Pi1541. The process ran fine and verified ok. It worked pretty well in the short board and physically it was fine, the board is mounted in a Pixelwizard case with keyboard mounts I 3D printed from Thingiverse. I could have easily closed the case as there was a gap between the mini and the keyboard.

Transferring it to the Reloaded board was no issue, though I had to remove the extra socket, otherwise the keyboard rested on the mini.

While the boot screen appears fine, as soon as I load anything the characters start to randomly change colour, and random characters ocassionally appear on the screen. This seems to happen more when the SD2IEC is being accessed.

I get the same effect in PAL or NTSC. I tried switching to the motherboard clock source but this made it worse, with the video signal going out of sync in time with the flickering characters.

I ran the config utility and verified that it was updated to firmware 1.8. (it came with 1.5).

I have an ARM2SID, 2x 6526 CIAs and a 6510 CPU installed in the board.

Happy to be a tester for future firmware updates and I can provide video captures of the issue if you want.

Many thanks,

Simon.

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

randyrossi, 2022-12-05:
This is an MKII board?  I haven't had any reports of that kind of behavior
with the firmware change but I never used SD2IEC when I had an MKII board
here.  Does it happen with Pi1541 or a 1541?  What firmware version is your
reloaded board?

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

--
Randy Rossi

- "There are only two things that are hard about computer science; Naming
things, Cache Invalidation, and Off-by-one errors."

randyrossi, 2022-12-05:
I may have had the wrong image at the download link. Can you try this one instead?

https://accentual.com/vicii-kawari/downloads/flash/LH/kawari_flash_1.6_MKIILH_multiboot.zip

Version should be 1.6 now

slime1982, 2022-12-17:
Hi, sorry for the late reply, was busy with work then managed to catch covid.

Is it ok to update to the v1.6 firmware using the MK2, or should I swap it back into my short board first?

Using my Pi1541 doesn't seem to make a difference, I have the same issue when loading anything from the Pi1541.

Simon.

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

randyrossi, 2022-12-17:
I would put it in the short board first to be safe.  Can you tell me what
firmware your MKII is at currently?

If you still see an issue, this could be a problem not yet seen before.
This firmware is reported to be working with MKII.  So we'll have to do
some digging.

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

--
Randy Rossi

- "There are only two things that are hard about computer science; Naming
things, Cache Invalidation, and Off-by-one errors."

slime1982, 2022-12-23:
Hi, MK2 firmware version is V20180227, which appears to be the latest version. The board detects the kawari as a 6569. I will swap it back into my short board and flash the v1.6 firmware.

Could it potentially be power related? The PSU I used with it initially caused noise on the screen with a real 6569. I swapped to the PSU that came with my Ultimate 64 and that fixed the problem.

Also I note that just sitting at the boot screen the text will ocassionally flicker without any input.

The only MOS ICs in this board now are the CPU and 2x CIAs. I suppose it's possible one could be marginal.

Cheers,

Simon.

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

randyrossi, 2023-01-23:
I've discovered a technical issue that will prevent Kawari from reliably working with the MK-II.   The two projects are fundamentally incompatible with each other.  So I won't be able to support the MK-II board.  Apologies if this represents a problem.  You can contact me via email if you need to return the board.  Thanks.

dougwj, 2023-01-23:
I am happy with using the Kawari  on my MK2. The only thing I have noticed
is if the MK2 is shut off for a few days, on first boot the MK2 blinks with
an error and no video is displayed. Power off/on and it is good to go.

Thank you.
Doug.

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

randyrossi, 2023-01-23:
The MK-II ignores CAS/RAS signals completely and instead expects the
address bus to be valid at specific times in the cycle.  But in order to do
that, it uses its own counter running off the mother board's dot clock
which the Kawari does not use (because it generates its own to be able to
switch video standards).  I might be able to get it to work by using the
motherboard clock jumper setting, then the counter would be in sync.  So it
would be like any other special hardware that requires the dot clock.  But
the 2nd issue is that I don't have one and don't want to keep borrowing one
to troubleshoot issues.

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

--
Randy Rossi

- "There are only two things that are hard about computer science; Naming
things, Cache Invalidation, and Off-by-one errors."

dougwj, 2023-01-23:
I have a second new unused MK2 that you can have permanently if you want or
I can have one purchased and sent to you.(I think that can be done.) Either
way it is up to you.

I would consider it to be just helping with supporting the project.

Doug.

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

slime1982, 2023-01-23:
OK. I am happy to test it on your behalf if you did want to try the motherboard clock option. I have more free time now than I have had recently so am happy to help to try and get it working.

my Mini seems to work fine in my short board so I can use that to do firmware updates.

Cheers,

Simon.

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

Closed 2023-01-23.

Thread 16 (2023-01-10):

Timing issues on 250466 board

Braincell1973, 2023-01-10:
Using a kung fu flash and the oneload 64 v4 collection, the games ghostbustets and fix it felix freeze completely before going in game in pal and ntsc mode on a 250466 board......

The same cartridge and game file work fine when the same kawari mini is inserted into a 250407 stock board.

The freezing efdect can be seen in...... https://youtu.be/RnM1jLROvhc

Lee

randyrossi, 2023-01-14:
I'm pretty sure this is due to the PLA replacement module you are using, not the kawari.  I posted to the trouble shooting section on discord as well but I will repeat the info here:

The crashes seen with Fix it Felix Jr and Ghostbusters (and others) in the "EP20 PAL VS NTSC ON KAWARI" video posted earlier I believe are actually due to the PLA replacement module.  The problem happens with Lattice 25ns GALs (GAL20V8B). I contacted Daniël Mantione last year to report this issue.  He was able to reproduce it with the Lattice 25ns GALs but when he replaced them with Lattice 15ns or National Semiconductor 25ns GALs or Atmel 15ns GALs, it works.  I can reproduce the same hangs with Fix it Felix Jr and Ghostbusters using Lattice 25ns GALs even with a genuine VIC-II chip.  Please try your 250466 board either with a Genuine PLA + Kawari and confirm the issues go away OR use your replacement PLA + Genuine VIC-II and confirm the issues remain.

I've done that here with my own 250407 board and can confirm it's the PLA replacement, not the VIC-2 (real or Kawari).

randyrossi, 2023-01-23:
Closing this as the PLA was the culprit.

Closed 2023-01-23.

Thread 20 (2023-02-23):

Is the PCB project also available in a/the repo?

mwedmark, 2023-02-23:
I can't seem to find it. Would be cool to try and build and install this. I'm in for making some 3d-demo (using the new MUL) and maybe a slideshow with some nice pictures. I already developed a nice route to convert pictures to the virtual platform Chip-16 which would suit perfectly using this new 16 color 320x200 mode. Is there a VICE build that has a Kawari option in it? That would be very useful.

db8fs, 2023-03-31:
Would be interested too in the PCB schematics/board files, at least for the mini.

DFL1973, 2023-07-04:
No schematics at least?

randyrossi, 2023-07-04:
Not yet.  I'm on the fence.  I have a fear of getting inundated with
requests to help make them.  (Like picking alternative parts, layout
changes, fabrication specs, etc).  It's not a trivial task.

On Tue, Jul 4, 2023 at 10:45 AM Dario Felix ***@***.***>
wrote:

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

--
Randy Rossi

- "There are only two things that are hard about computer science; Naming
things, Cache Invalidation, and Off-by-one errors."

DFL1973, 2023-07-04:
> Not yet. I'm on the fence. I have a fear of getting inundated with requests to help make them. (Like picking alternative parts, layout changes, fabrication specs, etc). It's not a trivial task.

Well, my two cents: if someone is smart enough to make a new PCB from the schematics alone, he will be smart enough to figure out the manufacturing process, I guess.

My main interest is to see how the T8 FPGA is connected and configured on the schematic. Yes, I know it´s just a matter to look and study the datasheet, but is a lot easier just follow someone´s path. ;)

Congrats and thanks for this project! It´s really great to see those hard/impossible to find ICs recreated.

db8fs, 2023-07-07:
Agree to DFL1973, it would make things quite easier to adapt the board for the own needs. For instance to modify component/connectors or placement or even add more grounding plane for the more analog-like signal traces - stuff like that.

Nevertheless, also from me congrats to this awesome project! Received my Kawari Large Board today and the DVI output is absolutely stunning - never saw that precise coloring on a C64 before. :) Thx a lot for your efforts to make this possible!

rchyla, 2023-07-16:
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

What about some disclaimer that people build it on their own responsibility and you don't have time to help individuals who didn't bought a unit that was sold as working (maybe give them some forum for brain storming).

Is there a way to obtain gerbers personally (or buy PCBs alone from you) to play around and experience difficulties?

Help to make would rather be mandatory for people you would allow to cooperate in production in early stage if there are any snags like critical propagation of some parts, although your boards doesn't look that hard to assemble (this is my design http://wiki.archi-tech.com.pl/pl/30T_cdtv that have propably the most components on board i ever designed and is hand soldered).

randyrossi, 2023-07-16:
Everything will be put out as open hardware before the end of the year.
Yes, there will be a disclaimer.  I just have one more batch of the large
to take care of pre-orders.  So maybe check back around Sep/Oct time frame?

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

--
Randy Rossi

- "There are only two things that are hard about computer science; Naming
things, Cache Invalidation, and Off-by-one errors."

rchyla, 2023-07-16:
Do you mean a full open source release or PCBs availability? In any case i'll try any form you're going to allow to build own unit. If i'll succeed in building working unit, i'll ask my friend if he would manufacture some for his retro-shop and then eventually share some revenues with you.

Thread 21 (2023-04-30):

Sam's Journey (NTSC) experiencing many graphics issues

macjohnmcc, 2023-04-30:
While I have not played it with the original chip I started playing Sam's Journey on my C64 with the Kawari (1.5 version) and it has enough graphics issues as to be unplayable.

Does anybody else have this experience or is it just me?

randyrossi, 2023-04-30:
NTSC Sam's Journey requires an REU, right?  Are you using an REU?

On Sun, Apr 30, 2023 at 12:00 PM macjohnmcc ***@***.***>
wrote:

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

--
Randy Rossi

- "There are only two things that are hard about computer science; Naming
things, Cache Invalidation, and Off-by-one errors."

macjohnmcc, 2023-04-30:
I have an Ultimate 1541 II+L with REU enabled. 

On 4/30/2023 12:35:50 PM, randyrossi ***@***.***> wrote:
NTSC Sam's Journey requires an REU, right? Are you using an REU?

On Sun, Apr 30, 2023 at 12:00 PM macjohnmcc ***@***.***>
wrote:

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

--
Randy Rossi

- "There are only two things that are hard about computer science; Naming
things, Cache Invalidation, and Off-by-one errors."

—
Reply to this email directly, view it on GitHub [https://github.com/randyrossi/vicii-kawari/issues/21#issuecomment-1529089314], or unsubscribe [https://github.com/notifications/unsubscribe-auth/AEG3HX36M7HHA6MXCSMAWKLXD2PHNANCNFSM6AAAAAAXRAFYJQ].
You are receiving this because you authored the thread.Message ID: ***@***.***>

randyrossi, 2023-04-30:
Is it a native NTSC machine?  I think the REU needs the dot clock signal to
be in phase with the system clock.  So if it is an NTSC machine, try
changing the clock jumper to the mother board setting for NTSC .

https://github.com/randyrossi/vicii-kawari/blob/main/doc/VARIANTS.md#mini-trion-board-rev-13--rev-14

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

--
Randy Rossi

- "There are only two things that are hard about computer science; Naming
things, Cache Invalidation, and Off-by-one errors."

macjohnmcc, 2023-04-30:
The machine is NTSC from birth but I will check that setting.
On 4/30/2023 3:09:19 PM, randyrossi ***@***.***> wrote:
Is it a native NTSC machine? I think the REU needs the dot clock signal to
be in phase with the system clock. So if it is an NTSC machine, try
changing the clock jumper to the mother board setting for NTSC .

https://github.com/randyrossi/vicii-kawari/blob/main/doc/VARIANTS.md#mini-trion-board-rev-13--rev-14

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

--
Randy Rossi

- "There are only two things that are hard about computer science; Naming
things, Cache Invalidation, and Off-by-one errors."

—
Reply to this email directly, view it on GitHub [https://github.com/randyrossi/vicii-kawari/issues/21#issuecomment-1529128921], or unsubscribe [https://github.com/notifications/unsubscribe-auth/AEG3HX5NLJKP4DBMW2X3JOLXD3BG7ANCNFSM6AAAAAAXRAFYJQ].
You are receiving this because you authored the thread.Message ID: ***@***.***>

randyrossi, 2023-04-30:
Also, are you using static RAM or DRAM?

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

--
Randy Rossi

- "There are only two things that are hard about computer science; Naming
things, Cache Invalidation, and Off-by-one errors."

macjohnmcc, 2023-04-30:
I don't know how the Ultimate II+ handles RAM if Dynamic or Static but the 64 itself has original dynamic RAM chips.
On 4/30/2023 3:34:03 PM, randyrossi ***@***.***> wrote:
Also, are you using static RAM or DRAM?

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

--
Randy Rossi

- "There are only two things that are hard about computer science; Naming
things, Cache Invalidation, and Off-by-one errors."

—
Reply to this email directly, view it on GitHub [https://github.com/randyrossi/vicii-kawari/issues/21#issuecomment-1529133371], or unsubscribe [https://github.com/notifications/unsubscribe-auth/AEG3HX2XRGRMHT5CIUS2GTLXD3EDXANCNFSM6AAAAAAXRAFYJQ].
You are receiving this because you authored the thread.Message ID: ***@***.***>

randyrossi, 2023-05-02:
Did you get a chance to try using the motherboard clock?

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

--
Randy Rossi

- "There are only two things that are hard about computer science; Naming
things, Cache Invalidation, and Off-by-one errors."

Thread 22 (2023-09-02):

Trion T20 BGA256 Query

RetroHQ, 2023-09-02:
Hi! I have a query on the Trion BGA if you don’t mind. As you are driving the DVI signals directly, what kind of maximum dot clock have you been able to achieve like this? And are you going through something like the PTN3366 to convert from ac coupled LVDS to CML? And have you also tried using the 5:1 gearing on the LVDS serialiser to give you just 2x dot clock in terms of actual output clocking?

I’m about to try this with the T20 for a small single board computer project and am just curious as to your experience! I’ve driven DVI directly with just ac coupled LVDS successfully before, so the implementation side of things I already have proven, I’m curious more on the specifics of the T20. I’m a big fan of Trion chips, but they are certainly not ideal for trying to drive DVI.

randyrossi, 2023-09-05:
29Mhz is my max.  I'm using SN65CML's to convert LVDS to CML.  I also had to add a load switch to deal with 5V backfeeding from the HDMI connector that can power the FPGA.  I'm not using the LVDS serializer.  The serialization is driven by a 10x dot clock.  I did try but I can't remember the reason the LVDS serializers didn't work for me.  I think with ac coupled LVDS, you might be able to get around 16mhz.  So you can probably do 640x480.   The Tiron chips are definitely not ideal for DVI.  I'm amazed it works, really.

RetroHQ, 2023-09-06:
Fantastic, thank-you for the response! The PTN3366 takes care of the backfeeding of current and also level shifting on the I2C lines for querying modes, too, it looks like quite a useful (and cheap) part. The LVDS side of the T20 can, apparently, be clocked up to 800Mhz, but I guess ac coupling factor is limiting. :(

RetroHQ, 2023-12-19:
Just as a FYI, I've finally built up a test board and I can output 720P via a PTN3366 using 5x serialisation just fine.

Thread 23 (2023-09-06):

Temperature and video signal dropping out

DusteDdk, 2023-09-06:
It's warm these days, and for the first time I had a longer session on my machine (assembled for once), maybe an hour into the session, the TV started dropping the signal, it'd catch the signal for a frame or two, then drop it, it'd repeat like that, like something drifting..
I pulled the case apart and took off the keyboard, and gently pressed on the kawari, it was hot, not VIC2-leaves-permanent-burn-scars hot, but hot, blinking stopped immediately hereafter and didn't return.

What are the acceptable package temperature for the kawari ? I wonder if that's what caused the issue. ? Have you done any thermal testing ?

randyrossi, 2023-09-07:
The FPGA is rated up to 85 C but I did not see temperatures go that high in
my testing.  High temps can definitely cause that kind of issue in FPGAs
though.  The tools only guarantee timing constraints can be met across the
operating temperature range.  You can try throwing on a small thermal pad
on top of the FPGA to see if it helps.

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

--
Randy Rossi

- "There are only two things that are hard about computer science; Naming
things, Cache Invalidation, and Off-by-one errors."

DusteDdk, 2023-09-07:
Thank you for your reply, the FPGA was nowhere near that temp. But the 7805 was pretty toasty, maybe it does thermal cutoff, but I'd not think the kawari needs as much juice as the VIC2, maybe more sensitive? Then again I'd not expect the kawari to come online with a usable picture if it lost power during operation (I'd expect some registers to be messed up or something like that).

If you have any additional remarks, I'm very interested.
In any case, I believe this can be closed as there's nothing in particular pointing to the kawari being at fault (except that the machine continued operation while only the video signal started dropping out).

Thread 25 (2023-10-27):

VIC-II KAWARI on c0pperdragon's RGB Vid Mod: does not work

distantvoices, 2023-10-27:
Hello,

Recently I've managed to get my hands on a few of c0pperdragon's RGB Vid Mods. C0pperdragon's RGB vid mod sniffs the signals off of the VIC-II-Pins, in short, and renders the received data to an image - which is quite snazzy if I may be so bold to say. The one and only caveat is, that VIC-II KAWARI and the RGB Vid Mod aren't compatible enough for the RGB Vid Mod to read workable Data.

So, with an off-the-shelf-VIC-II, the RGB Vid Mod works quite nice and seamless. With a KAWARI, I get the blue border and over large parts of the screen blocky, flickering colors. On the sixtyclone based on assy 250466 as well as the one based on assy 250469 rev B it displayed the boxy, blocky distortion. In addition, it displayed parts of the basic boot up text (and the blinking cursor) in all the wrong colors with flickering and dancing colors.

Test performed with small Kawari as well as large Kawari with the latest DVI Firmware. (1.17 IIRC). On sixtyclone 250466 I've installed the vanilla PLA from 1986 to eliminate possible timing issues probably inherent to modern PLA solutions.

Image below shows the working config with a vanilla VIC-II. Works as expected.
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

This image shows the config resulting in a display weird and flickering.
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

Below please check out the board I've performed this test on. The thing works - buildt it with my own hands and performed both dead test and diagnosis with harness.
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

What - apart from simply not configuring a c64 this way - can we do? I do own both a stash of KAWARIs and a few C64 boards equipped with c0pperdragon's RGB vid mod. I can read VHDL well enough but I'm not experienced enough with it to troubleshoot that problem. Would be quite fine if KAWARI and c0pperdragon's solution could work together so I can build C64 with multiple connectivity options.

Thanks a bunch for even reading this lengthy post.

ikrananka, 2023-10-27:
I would like to add a +1 to this request.  I have a C64 modded with c0pperdragon's RGB Vid Mod but the PAL VIC-II I have in that machine is failing.  So, I bought a VIC-II KAWARI with the intention of installing it in the RGB modded C64 to replace the failing VIC-II.  So, I'm very disappointed to hear that this currently doesn't work and would also love to see a solution be developed if it can.

randyrossi, 2023-10-28:
It doesn't surprise me this doesn't work.  I imagine C0pperdragon's board
was finely tuned to the original VIC's address/data bus timing and other
control signals.  The Kawari doesn't match timing down to that level.  I
think it would be easier for the c0pperdragon board to adjust to Kawari's
timing rather than trying to get Kawari to play with the existing
expectations.  But I would not ask the creator to go through the trouble.
I am working on a luma code encoding that the rgb2hdmi hat supports,
however.  Do you know if that video module supports lumacode?  It seems to
me to be a much easier solution to have video output through that board.
From what I understand, that board is essentially emulating a VIC-II in
sync with what it thinks a real VIC-II chip is doing.  So now you have an
emulated VIC-II trying to match another emulated VIC-II.  It would be much
easier just to have the Kawari output lumacode encoding over the luma pin
and have the board interpret that and then output the new video signal.
Issue #1 was opened by c0pperdragon for lumacode and I am working on it
now.  I will ask if this is a feature that can be added to that board.

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

--
Randy Rossi

- "There are only two things that are hard about computer science; Naming
things, Cache Invalidation, and Off-by-one errors."

Thread 26 (2023-11-16):

Orignal & clone REU fail testing even with NTSC motherboard clock.

gillham, 2023-11-16:
First let me say this is a great project/product and it definitely looks amazing on my (formerly) 6567R56A machine. Thanks!

I have a VICII-KAWARI Trion Mini in a 250407.  It has firmware 1.16.  I set it for motherboard clock on NTSC.  A 1541 Ultimate 2+L acting as an REU seems to work fine. Neither an original REU nor a clone using an original REC work.  They both appear to pass testing for the first bank and then immediately fail on the 2nd bank.

These REU units test good in other C64 / C64C machines.  And I believe I have used them both in this same machine prior to adding the Kawari.  I can certainly confirm that at some point by swapping back.

Anyway, I see the REU is listed as "untested" but thought to work with motherboard clock.  It appears to almost work but isn't.
Is there anything diagnostics wise that I can collect or timing adjustments etc that I can make that might help?

randyrossi, 2023-11-16:
I also thought it was working as some people reported it to work with the
motherboard clock.  But I think the problem with the 407 clock circuit is
that it generates the wrong frequency for dot clock (12mhz instead of ~8)
when a real VIC-II isn't plugged in.  The 466 doesn't appear to have this
problem.  It's something strange with that clock circuit I never figured
out.  There is a way to get the Kawari to output a dot clock which  you can
feed back into the motherboard though.  It's been done by some users and
requires running a line from the kawari into the motherboard + firmware
update.  I will have to dig up the instructions though.  What revision Mini
do you have?

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

--
Randy Rossi

- "There are only two things that are hard about computer science; Naming
things, Cache Invalidation, and Off-by-one errors."

gillham, 2023-11-16:
It says rev1.5 2023.

randyrossi, 2023-11-18:
Okay, that makes things easier.  Before I describe the mod, I should
mention that I don't know for sure if the dot clock is responsible for your
REU issue.  You might want to first reach out to the discord channel to see
if there are others who have an REU working with the Kawari without the
mod.  I don't have one myself and I never tested one.  It does make sense
that it's not entirely stable due to the dot clock though.  In any case, if
you do go through with the mod, you will get a machine that will have a
working dot clock reaching pin 6 of the cartridge port for both NTSC and
PAL.  And it can always be un-done fairly easily.

On the Mini, there is a pad at the top labeled CLK.  You can flash the
special build for the dot clock mod (v1.5 link) available here to activate
it:

https://github.com/randyrossi/vicii-kawari/blob/main/doc/FIRMWARE.md#specialty-builds

Then take a look at this video : https://www.youtube.com/watch?v=ONgFPn0k2sc

This describes where to wire that CLK pad to.  In your case, since you have
a more recent board rev, you don't have to take the signal off the 74LS06D
like in the video.  There is a dedicated pad that already has the 33ohm
resistor so you don't have to add one like the video.  So all you should
have to do is add a wire from the CLK pad down to pin 21 of the kawari like
he does in the video and remove FB17 (or lift one leg up).

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

--
Randy Rossi

- "There are only two things that are hard about computer science; Naming
things, Cache Invalidation, and Off-by-one errors."

gillham, 2023-11-21:
Thanks Randy!  After a little struggling I got this working well. Basically the first time I flashed it, even though it said copy/verify/ok for each, it wouldn't boot. A few metal tools later I had a screwdriver that actually shorted JP2 for the fallback boot. I don't know if it was the SD2IEC or that I had it set for motherboard clock still when I first powered it up after flashing.

Anyway I flashed it again and ran the verify and then it booted. My clone & original REU both appear to work fine. The 1764 demos work and the test passes. C64 OS v1.05 worked great with the Fast App Switching (via the REU) as well. I tested it for 30-45 minutes. I need to test some games that use the REU like Sam's Journey or Sonic and leave it running in demo or similar for a number of hours.

Oh and it is pin 22 per the video and schematic. He says "sorry I kept saying pin 21 in my last video." 😀

Thanks for the help! I'll close this issue for now.

Closed 2023-11-21.

Thread 28 (2024-02-02):

Trion based Kawari mini not working with SaRuMan 64K static DRAM

eightbit0675, 2024-02-02:
I very recently purchased the Kawari mini (latest Trion model) and I have it installed into a SixtyClone board assy 250466. I saw a video posted around a year ago where Jan Beta could not get his SaRuMan 64K static DRAM replacement to work in the board with the Kawari installed. It would just freeze at the BASIC screen with some random characters.

I had asked him if this had been resolved since the video had been posted and he said yes, the latest firmware now supports the SaRuMan. But, unfortunately that is not true at least for the Trion based Kawari Mini.

I received the SaRuMan 64K from Eslapion today and installed it and it does the exact same thing as in Jan Beta's video from a year ago. I am running the latest 1.16 firmware for the mini board.

Is there something I am missing or somethings special needed to get this to work? I reinstalled the ordinary RAM and the machine works perfectly, so it is definitely some sort of compatibility issue with the Kawari and the SaRuMan memory replacement.

I hope this can get resolved!

randyrossi, 2024-02-03:
I just tried my Saruman on my own Sixty clone (466) and it appears to be working correctly for me with the same firmware version.

What revision of Saruman do you have?  I have 2020 V1.4 with these chip markings:
Lyonte LY62W1024RL-55SL 2010 I220111A08W1S
HCT573 6090005 YXD029G

Are there any other non-original chips installed on the board?  Have you been able to verify the SaRuMan works properly with an original VIC?

eightbit0675, 2024-02-03:
The SaRuMan does work properly with the original VIC. I should have mentioned that I had tried that before submitting the issue in order to confirm it was working.

Mine is also 2020 v1.4, but the chips are completely different:

ISSI
IS61C1024AL-12HLI
DSK493X1 2239

HCT573
4890001
YXD136G

And, boy was that difficult to read for an old man ;)

randyrossi, 2024-02-04:
I may have to purchase the same board to investigate here.  Is there a URL link you can share or is this a direct purchase from eslapion off melon64.com?

eightbit0675, 2024-02-04:
I had purchased it from him on Amibay:

https://www.amibay.com/threads/saruman-64k-static-ram-for-dram-replacement-board.109657/page-4

You can see my post for the purchase on the last page of the thread.

Thanks for looking into this Randy!

eightbit0675, 2024-02-04:
I asked François about this and this was his response:

Hi,
I originally ordered the Lyontek SRAM chip to be installed at the fab on my PCBs but some genius replaced it with a 3.3V chip thinking it would "be better and save money". Apparently in his alternate reality 5V doesn't exist anymore.
I was forced to desolder and replace the SRAMs one by one manually with what I could grab at a decent price from Mouser. The Lyontek SRAMs are very difficult to source when you buy them in small quantities and not for assembly.

This being said, people who have problems with Saruman-64 (fast or slow SRAM) usually have replaced the genuine 74LS257 multiplexers with fake Chinese substitutes which are really rebranded 74HC257. These have a slower reaction speed and a slightly higher logic voltage threshold. AFAIK DigiKey still sells TI SN74LS257 chips in DIP package.

This is the only batch which will ever have faster chips but they did pass all tests on my genuine board 250466 with 6567R9.

Hope this helps.
- François

randyrossi, 2024-02-05:
Thanks for the info.  I posted a message to the thread.  I'll have to wait for his response as I don't appear to have PM permissions with a new account.

eightbit0675, 2024-02-05:
Much appreciated Randy for looking into this. I'll be interested to see what you find!

Thank you once again.

eightbit0675, 2024-02-12:
Hi Randy. Just checking in to see if you received that SaRuMan? If so were you able to confirm what I am seeing?

randyrossi, 2024-02-12:
It hasn't arrived yet but it's on its way.  He was kind enough to send me
one for free.  I'll update the issue after I've had a chance to give it a
try.

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

--
Randy Rossi

- "There are only two things that are hard about computer science; Naming
things, Cache Invalidation, and Off-by-one errors."

randyrossi, 2024-02-12:
I spoke too soon.  I just received the SRAM.  I installed it just now and I am getting a garbled screen.  I'll have a look later this week.

randyrossi, 2024-02-17:
FYI: I was able to get the new Saruman working on my SixtyClone with a minor modification to the CAS rise time.  I suspect the Kawari was transitioning CAS from LOW to HI too early and the new SRAM chip was quicker to react and disable the output before  the Kawari could read the data.  That's my guess but I'm not 100% sure.  Adjusting it slightly seems to have cleared up the issue for me.

I need to be careful and do a lot more testing before I make this a final change.   I don't want to break the EVO or other static ram chips.  Although perhaps this is why the Mellius board has issues.  I will do some more testing with the old Saruman + DRAM and update the thread.

eightbit0675, 2024-02-17:
Thanks Randy for the update! Once again I really do appreciate you looking into this. Great to see you got it working!

randyrossi, 2024-02-19:
Would you be able to try this firmware to see if the issue with the new Saruman is fixed?  You will probably have to flash it using DRAM or another working C64.

[Mini 1.18 Flash Disk](https://accentual.com/vicii-kawari/downloads/flash/tmp/kawari_flash_1.18_MAINLH_multiboot.zip)

eightbit0675, 2024-02-19:
Yes, let me try it and I will report back shortly.

eightbit0675, 2024-02-19:
This absolutely worked. You nailed it Randy!

randyrossi, 2024-02-19:
Okay, please continue testing and let me know if you have any issues.  I will do the same here and release this if everything looks okay.  Thanks for letting me know.

eightbit0675, 2024-02-19:
I am testing the heck out of it now. So far so good. I will let you know if I encounter any issue and report back in a few days. Again I really appreciate you looking into this so quickly!

eightbit0675, 2024-02-22:
Hi Randy,

I would just like to follow up that after days of testing I am not finding anything out of place. The machine has been functioning perfectly stable and I have tested various diagnostics, games, demos. Using it has been quite an enjoyable experience :)

Unless you have found something on your end I can say with confidence that this update did not harm anything and everything works great.

Once again I want to thank you for your help with this. If you don't mind I would ask that you reach out to François on Amibay and provide him with an update that this has been resolved if you have not done so already as I know he was waiting to hear the outcome as well.

Thanks Randy for a superb product and excellent support!

-Bruce

randyrossi, 2024-03-11:
@eightbit0675  Hi again.  Would you be able to try this firmware and let me know if your Saruman board still works?  I found a regression in the build that I sent you earlier in this thread.  Super Zaxxon cartridge failed.  However, this new firmware works for me for all static ram I've tested so far and I want to make sure it solves your issue before releasing.

[Mini 1.18b Flash Disk](https://accentual.com/vicii-kawari/downloads/flash/tmp/kawari_flash_1.18b_MAINLH_multiboot.zip)

Thanks

eightbit0675, 2024-03-11:
I am sorry to say that it is broken again. I am experiencing the same problem that I did initially with this new update.

eightbit0675, 2024-03-11:
I only have one cartridge (C64 Ultimate II+L) and that worked with the update, but obviously I couldn't load anything from BASIC. I had to reinstall the original memory and for now reflashed with the previous update you provided and am back up and running. I will mention that Super Zaxxon works fine for me (.crt image running in the UII+) with the previous update as well.

randyrossi, 2024-03-11:
Ah, good to know.  Thanks.  I wonder if my Super Zaxxon cart would also
fail on your machine though.  I've been through a number of permutations on
timing and this one worked across all my SRAM/DRAM combos.  But alas it
still fails for you :(

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

--
Randy Rossi

- "There are only two things that are hard about computer science; Naming
things, Cache Invalidation, and Off-by-one errors."

eightbit0675, 2024-03-11:
Are you using the Kawari in PAL or NTSC mode? I don't know if that makes any difference at in this situation but I am using it in NTSC mode only because I have to. I am on a NTSC only Sony Wega Trinitron with no 50hz mode.

randyrossi, 2024-03-11:
I tried both NTSC and PAL and they both failed (Super Zaxxon) with my first
update for you.  But they both work using this latest one.  THere is some
weird bus contention going on and I can't seem to isolate the cause.

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

--
Randy Rossi

- "There are only two things that are hard about computer science; Naming
things, Cache Invalidation, and Off-by-one errors."

eightbit0675, 2024-03-11:
Thanks Randy. I guess for now I'll just stick with the update you had provided previously. There has been no issues at all with this machine since that update. Of course I'll be willing to test further should you wish to continue to investigate!

eightbit0675, 2024-03-12:
Also, when you said your Super Zaxxon cart "failed" with the prior update, what exactly did it do? Lock up or not launch at all, or something else? I can try to source a Super Zaxxon cartridge and test it with the prior update. I am curious now :)

eightbit0675, 2024-03-12:
I guess I haven't kept up on prices/rarity of C64 cartridges, but looking around an original non-replica of Super Zaxxon is way out of my price range :)

Are you using a real cart or the replica? And, are you testing with a stock PLA or a replacement?

I am testing with a replacement PLA, also from Eslapion. The replacement is the PLAnkton EV (latest).

randyrossi, 2024-03-12:
It's a replica cartridge.  Tried with both stock and replacement PLA.  1.16
appears to work fine in both cases.  But the update broke something.

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

--
Randy Rossi

- "There are only two things that are hard about computer science; Naming
things, Cache Invalidation, and Off-by-one errors."

eightbit0675, 2024-03-14:
Just thinking about this today, maybe there is something wrong with how the replica cart is interacting. Do you have another device (Ultimate II or some other) that has the ability to run .crt images? Can you try the Super Zaxxon cart image instead with the earlier firmware you had provided to me and see if the game failing is consistent?

randyrossi, 2024-03-14:
I have a TeensyROM but I find it is unreliable.  The cartridge doesn't
start sometimes at all (even with a real VIC-II).  I used to have a KungFu
flash but it broke recently.  I'll have to get another one.  I'll try the
TeensyROM to see if it also fails.

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

--
Randy Rossi

- "There are only two things that are hard about computer science; Naming
things, Cache Invalidation, and Off-by-one errors."

randyrossi, 2024-03-14:
@SensoriumEmbedded

I have TeensyROM.0.5.0.hex on the sdcard.

I just tried it in 4 different machines and it just boots to BASIC prompt on all of them.  Previously, it would intermittently work but now it consistently does not go to the menu.  I purchased it from a vendor at the World of Commodore in December.  So it's possible it's just a bad build.  Is there a serial port I can tap into to see what the board is doing at boot?  I can try spraying the sdcard port with a contact cleaner. But it seems it's not even recognized as a cartridge.

SensoriumEmbedded, 2024-03-15:
Thank you much for the response and information Randy, much appreciated.  Yes, there is definitely something wrong with that unit.  Although it wasn't built by me, I would like to make it right by sending you a replacement unit free of charge. If you can send me your address, I'll send out a replacement out tomorrow.  My e-mail is travis@sensoriumembedded.com          It's important to me that you (and others) have a good/unhindered experience with the TeensyROM.   Hoping you can also send the faulty one to me for detailed diagnosis, but that's up to you.

Regarding your question, yes, there is some text output from the USB-B micro port on boot that should be readable with terminal SW.  It's not necessarily diagnostic in nature, but would indicate that the FW is loaded.  However, I assume it is since it was working intermittently.
Normally, nothing needs to be plugged in to SD/USB in to boot correctly. There's a large number of programs/games/utils built in to the FW so it can operate somewhat autonomously.

My guess is that there is a solder issue of some kind that has gotten worse with time.  Guessing it's not a short since the computers do boot, but probably an open on an SMT device.  Hope you'll take me up on my offer.  :)
Thank you again!

eightbit0675, 2024-03-15:
That's nice of you Travis. Thank you for helping Randy...which ultimately will help me to see if the firmware fixed previously is truly affected by the Super Zaxxon incompatibility.

A wise man once said "I love it when a plan comes together" ;)

randyrossi, 2024-03-15:
@SensoriumEmbedded Thanks for the offer.  Very kind of you.  Yes, I can send you the one I have.  I will PM you in discord with my address and maybe we can troubleshoot a bit more first with serial to see if we can get anything useful out of that.  Thanks again.

eightbit0675, 2024-06-23:
HI Randy,

Well fast forward over three months later and still using the firmware v1.18 (not B) that you supplied back on Feb 19th and the machine is rock solid. No issues whatsoever with the new Saruman and no issues at all with any game, demo, anything I have thrown at this. It is actually the most reliable experience I think I have ever had with a C64 :)

That said, I think I am just going to remain on this firmware and call it a day. I would definitely recommend leaving it available to people as I can't be the only one that will run into this issue as long as the Saruman is being sold with the faster SRAM.

Unless you have discovered anything different regarding your Super Zaxxon tests with the replacement TeensyROM?

randyrossi, 2024-07-12:
Thanks for letting me know.  I haven't done much additional testing since
but need to get back to it before I can release this.

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

--
Randy Rossi

- "There are only two things that are hard about computer science; Naming
things, Cache Invalidation, and Off-by-one errors."

eightbit0675, 2024-10-08:
Hi Randy. I ended up having some strange timing issues on the C64 with this Saruman installed along with the Kawari mini. The machine seemed to work mostly fine, but really wigged out when turning off S/LUM burst. I ended up removing the Saruman and putting some good old TMS4464 DRAM and moved back to the 1.16 firmware. Everything is solid now.

I think we are good to close this. I won't be trying to get the newer Saruman functioning with this any longer. Way too much time spent :)

Thanks for the help all the way through though Randy. It is much appreciated.

Thread 32 (2025-05-14):

PSA: Don't use the "fast loader" when updating the Kawari if using an Ultimate II cartridge

eightbit0675, 2025-05-14:
Just a heads up that I ran into an issue that almost gave me a small heart attack upgrading to the latest v1.19 firmware on my Kawari Large today.

I am using an Ultimate II cartridge (not the plus version, the first release) and as this older model cannot read .d81 files I had to use the five disk .d64 version.

I launched disk one, chose "yes" for using the fast loader (it is default to "Y" anyway) and disk 1 started the flash. When prompted for disk 2, I push the middle button on the Ultimate II as usual and mount disk 2.

At this point one would expect to be brought back to the install screen, push any key and the flash would continue. But no! As soon as I had mounted the second disk, it returned to a frozen blue screen with ready prompt!

Thankfully I didn't shut the machine off as I know better. I went back to the Ultimate menu, back to disk 1 and chose "mount and run" which soft reset the C64 and started the first install disk again. I had a sneaking hunch that the fast load caused this, so I started the flash again but this time chose NO for fast loading.

It took forever of course, but I was able to seamlessly move from disk to disk without that crash happening and am now on v1.19.

I figured I would throw this out there for anyone that this will help. If you are using a newer UII+ or a Kung Fu Flash or something that accepts .d81 files you will not have this issue.
