randyrossi/vicii-kawari/hdl/rev_4G/top.v

// This file is part of the vicii-kawari distribution
// (https://github.com/randyrossi/vicii-kawari)
// Copyright (c) 2022 Randy Rossi.
// 
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
`timescale 1ns/1ps

`include "../common.vh"

module top(
       input clk_col4x_ntsc, // from pin
       input clk_col4x_pal, // from pin

       input clk_col16x_ntsc, // from pll
       input clk_dot4x_ntsc, // from pll
`ifdef WITH_DVI
       input clk_dvi_ntsc, // from pll
       input clk_dvi10x_ntsc, // from pll
`endif
       input clk_col16x_pal, // from pll
       input clk_dot4x_pal, // from pll
`ifdef WITH_DVI
       input clk_dvi_pal, // from pll
       input clk_dvi10x_pal, // from pll
`endif

       // If we are generating luma/chroma, add outputs
`ifdef GEN_LUMA_CHROMA
           output luma_sink,     // luma current sink
           output [5:0] luma,    // luma out
           output [5:0] chroma,  // chroma out
`endif

`ifdef WITH_EXTENSIONS
           input cfg1,
           input cfg2,
           input cfg3,
`ifdef HAVE_FLASH
           output flash_s,
`endif
`ifdef WITH_SPI
           output spi_d,
           input  spi_q,
           output spi_c,
`endif
`ifdef HAVE_EEPROM
           input cfg_reset,
           output eeprom_s,
`endif
`endif // WITH_EXTENSIONS

           output cpu_reset,    // for pulling 6510 reset LOW
`ifdef HIRES_RESET
           input cpu_reset_i,   // for listening to 6510 reset
`endif
           input standard_sw,   // video standard toggle switch
           output clk_phi,      // output phi clock for CPU
           output clk_dot_ext,  // pixel clock
`ifdef GEN_RGB
           output hsync,        // hsync signal for VGA/DVI
           output vsync,        // vsync signal for VGA/DVI
           output [5:0] red,    // red out for VGA/DVI or Composite Encoder
           output [5:0] green,  // green out for VGA/DVI or Composite Encoder
           output [5:0] blue,   // blue out for VGA/DVI or Composite Encoder
`endif

           input [5:0] adl_IN, // address (lower 6 bits input)
           output [5:0] adl_OUT, // address (lower 6 bits output)
           output [5:0] adl_OE, // address enable (lower 6 bits)

           output [5:0] adh,     // address (high 6 bits)

           input [7:0] dbl_IN, // data bus lines in (ram/rom)
           output [7:0] dbl_OUT, // data bus ines out (ram/rom)
           output [7:0] dbl_OE,  // data bus enable

           input [3:0] dbh,     // data bus lines (color)

           input ce,            // chip enable (LOW=enable, HIGH=disabled)
           input rw,            // read/write (LOW=write, HIGH=read)
           output rw_ctl,
           output irq,          // irq
           input lp,            // light pen
           output aec,          // aec
           output ba,           // ba
           output cas,          // column address strobe
           output ras,          // row address strobe
           output ls245_addr_dir,  // DIR for addr bus transceivers
           output ls245_data_dir,  // DIR for data bus transceiver
           output ls245_addr_oe,   // OE for addr bus transceivers
           output ls245_data_oe    // OE for data bus transceiver
`ifdef WITH_DVI
           ,
           output tmds_data_r,
           output tmds_data_g,
           output tmds_data_b,
           output tmds_clock
`endif
);


wire rst;
assign cpu_reset = rst;

`ifdef WITH_DVI
reg rst_dvi_1;
reg rst_dvi;
always @ (posedge clk_dvi) rst_dvi_1 <= rst;
always @ (posedge clk_dvi) rst_dvi <= rst_dvi_1;
`endif

`ifdef OUTPUT_DOT_CLOCK
// NOTE: This hack will only work breadbins that use
// 8701 clock ICs and that IC MUST be removed.
// i.e. 250425 250466
// This will NOT currently work on short board motherboards
// The unit with this hack should NEVER be plugged into a
// motherboard without the clock circuit being disabled.
reg[3:0] dot_clock_shift = 4'b1100;
always @(posedge clk_dot4x) dot_clock_shift <= {dot_clock_shift[2:0], dot_clock_shift[3]};
assign clk_dot_ext = dot_clock_shift[3];
`else
assign clk_dot_ext = 1'b0;
`endif

wire clk_dot4x;
EFX_GBUFCE mux1(
    .CE(1'b1),
    .I(chip[0] ? clk_dot4x_pal : clk_dot4x_ntsc),
    .O(clk_dot4x)
    );

wire clk_col16x;
`ifdef GEN_LUMA_CHROMA
wire color_sel = chip[0] ? (~ntsc_50) : 1'b0; // was (pal_60);
`else
wire color_sel = chip[0];
`endif

EFX_GBUFCE mux2(
    .CE(1'b1),
    .I(color_sel ? clk_col16x_pal : clk_col16x_ntsc),
    .O(clk_col16x)
    );

wire clk_col16x_4tm;
EFX_GBUFCE mux2b(
    .CE(1'b1),
    .I(chip[0] ? clk_col16x_pal : clk_col16x_ntsc),
    .O(clk_col16x_4tm)
    );

`ifdef WITH_DVI
wire clk_dvi;
EFX_GBUFCE mux3(
    .CE(1'b1),
    .I(chip[0] ? clk_dvi_pal : clk_dvi_ntsc),
    .O(clk_dvi)
    );

wire clk_dvi_x10;
EFX_GBUFCE mux4(
    .CE(1'b1),
    .I(chip[0] ? clk_dvi10x_pal : clk_dvi10x_ntsc),
    .O(clk_dvi_x10)
    );
`endif

(* syn_preserve = "true" *) reg ntsc_dot_2;// throw away signal for mux hack
(* syn_preserve = "true" *) reg ntsc_dvi_5; // throw away signal for mux hack
(* syn_preserve = "true" *) reg dvi_ntsc_dot; // throw away signal for mux hack
(* syn_preserve = "true" *) reg pal_dot_2; // throw away signal for mux hack
(* syn_preserve = "true" *) reg pal_dvi_5; // throw away signal for mux hack
(* syn_preserve = "true" *) reg dvi_pal_dot; // throw away signal for mux hack
(* syn_preserve = "true" *) reg ntsc_col; // throw away signal for mux hack
(* syn_preserve = "true" *) reg pal_col; // throw away signal for mux hack

// This is a bit of a hack.  The Efinity toolchain does
// not like us using  our generated clocks only in the
// bit of combinatorial logic above (mux). It wants
// to drive at least one flipflop. So, we will burn
// 6 pins, one for each of our generated clocks. Is
// there a better way?
always @(posedge clk_dot4x_ntsc)
begin
    ntsc_dot_2 <= ~ntsc_dot_2;
end

always @(posedge clk_dot4x_pal)
begin
    pal_dot_2 <= ~pal_dot_2;
end

`ifdef WITH_DVI
always @(posedge clk_dvi_ntsc)
begin
    dvi_ntsc_dot <= ~dvi_ntsc_dot;
end

always @(posedge clk_dvi10x_ntsc)
begin
    ntsc_dvi_5 <= ~ntsc_dvi_5;
end

always @(posedge clk_dvi_pal)
begin
    dvi_pal_dot <= ~dvi_pal_dot;
end

always @(posedge clk_dvi10x_pal)
begin
    pal_dvi_5 <= ~pal_dvi_5;
end
`endif

always @(posedge clk_col16x_ntsc)
begin
    ntsc_col <= ~ntsc_col;
end

always @(posedge clk_col16x_pal)
begin
    pal_col <= ~pal_col;
end

wire [7:0] dbo;
wire [11:0] ado;

wire vic_write_ab;
wire vic_write_db;

wire [1:0] chip;
`ifdef GEN_LUMA_CHROMA
wire ntsc_50;
//wire pal_60;
`endif

`ifndef GEN_RGB
wire [5:0] red;
wire [5:0] green;
wire [5:0] blue;
`endif

// Instantiate the vicii with our clocks and pins.
vicii vic_inst(
          .rst(rst),
`ifdef WITH_DVI
          .rst_dvi(rst_dvi),
`endif
          .chip(chip),
          .rw_ctl(rw_ctl),
`ifdef HIRES_RESET
          .cpu_reset_i(cpu_reset_i),
`endif
          .standard_sw(standard_sw),
`ifdef WITH_EXTENSIONS
          .spi_lock(cfg1),
          .extensions_lock(cfg2),
          .persistence_lock(cfg3),
`ifdef HAVE_FLASH
          .flash_s(flash_s),
`endif
`ifdef HAVE_EEPROM
          .cfg_reset(cfg_reset),
          .eeprom_s(eeprom_s),
`endif
`ifdef WITH_SPI
          .spi_d(spi_d),
          .spi_q(spi_q),
          .spi_c(spi_c),
`endif
`endif // WITH_EXTENSIONS
          .clk_dot4x(clk_dot4x),
`ifdef WITH_DVI
          .clk_dvi(clk_dvi),
`endif
          .clk_phi(clk_phi),
`ifdef NEED_RGB
          .active(active),
          .hsync(hsync),
          .vsync(vsync),
          .red(red),
          .green(green),
          .blue(blue),
`endif
          .clk_col16x(clk_col16x),
          .clk_col16x_4tm(clk_col16x_4tm),
`ifdef GEN_LUMA_CHROMA
          .luma_sink(luma_sink),
          .luma(luma),
          .chroma(chroma),
          .ntsc_50(ntsc_50),
          //.pal_60(pal_60),
`endif
          .adi(adl_IN),
          .ado(ado),
          .dbi({dbh,dbl_IN}),
          .dbo(dbo),
          .ce(ce),
          .rw(rw),
          .aec(aec),
          .irq(irq),
          .lp(lp),
          .ba_d2(ba),
          .cas(cas),
          .ras(ras),
          .ls245_data_dir(ls245_data_dir),
          .ls245_addr_dir(ls245_addr_dir),
          //.ls245_data_oe(ls245_data_oe),
          //.ls245_addr_oe(ls245_addr_oe),
          .vic_write_db(vic_write_db),
          .vic_write_ab(vic_write_ab)
      );

// Write to bus condition, else tri state.
assign dbl_OUT[7:0] = dbo; // CPU reading
assign dbl_OE = {vic_write_db,vic_write_db,vic_write_db,vic_write_db,vic_write_db,vic_write_db,vic_write_db,vic_write_db};

assign adl_OUT = ado[5:0]; // vic or stollen cycle
assign adl_OE = {vic_write_ab,vic_write_ab,vic_write_ab,vic_write_ab,vic_write_ab,vic_write_ab};
assign adh = ado[11:6];

// Set LOW unless we need otherwise.
assign ls245_addr_oe = 1'b0;
assign ls245_data_oe = 1'b0;

`ifdef WITH_DVI

dvi dvi_tx0 (
   .clk_pixel    (clk_dvi),
   .clk_pixel_x10(clk_dvi_x10),
   .reset        (rst_dvi),
   .rgb          ({red, 2'b0, green, 2'b0, blue, 2'b0}),
   .hsync        (hsync),
   .vsync        (vsync),
   .de           (active),
   .tmds         ({tmds_data_r, tmds_data_g, tmds_data_b}),
   .tmds_clock   (tmds_clock));

`endif

endmodule
