randyrossi/vicii-kawari/hdl/xilinx_spartan6/dvi/dvi_encoder_top.v

//////////////////////////////////////////////////////////////////////////////
//
//  Xilinx, Inc. 2009                 www.xilinx.com
//
//  XAPP xyz
//
//////////////////////////////////////////////////////////////////////////////
//
//  File name :       dvi_encoder.v
//
//  Description :     dvi_encoder 
//
//  Date - revision : April 2009 - 1.0.0
//
//  Author :          Bob Feng
//
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
//              LIMITATION OF LIABILITY. In no event will Xilinx or its
//              licensors be liable for any loss of data, lost profits,cost
//              or procurement of substitute goods or services, or forany
//              special, incidental, consequential, or indirect damages
//              arising from the use or operation of the designs or
//              accompanying documentation, however caused and on anytheory
//              of liability. This limitation will apply even if Xilinx
//              has been advised of the possibility of such damage. This
//              limitation shall apply not-withstanding the failure ofthe
//              essential purpose of any limited remedies herein.
//
//  Copyright © 2009 Xilinx, Inc.
//  All rights reserved
//
//////////////////////////////////////////////////////////////////////////////
`timescale 1 ns / 1ps

module dvi_encoder_top (
  input  wire       pclk,           // pixel clock
  input  wire       pclkx2,         // pixel clock x2
  input  wire       pclkx10,        // pixel clock x2
  input  wire       serdesstrobe,   // OSERDES2 serdesstrobe
  input  wire       rstin,          // reset
  input  wire [7:0] blue_din,       // Blue data in
  input  wire [7:0] green_din,      // Green data in
  input  wire [7:0] red_din,        // Red data in
  input  wire       hsync,          // hsync data
  input  wire       vsync,          // vsync data
  input  wire       de,             // data enable
  output wire [3:0] TMDS,
  output wire [3:0] TMDSB);
    
  wire 	[9:0]	red ;
  wire 	[9:0]	green ;
  wire 	[9:0]	blue ;

  wire [4:0] tmds_data0, tmds_data1, tmds_data2;
  wire [2:0] tmdsint;

  //
  // Forward TMDS Clock Using OSERDES2 block
  //
  reg [4:0] tmdsclkint = 5'b00000;
  reg toggle = 1'b0;

  always @ (posedge pclkx2 or posedge rstin) begin
    if (rstin)
      toggle <= 1'b0;
    else
      toggle <= ~toggle;
  end

  always @ (posedge pclkx2) begin
    if (toggle)
      tmdsclkint <= 5'b11111;
    else
      tmdsclkint <= 5'b00000;
  end

  wire tmdsclk;

  serdes_n_to_1 #(
    .SF           (5))
  clkout (
    .iob_data_out (tmdsclk),
    .ioclk        (pclkx10),
    .serdesstrobe (serdesstrobe),
    .gclk         (pclkx2),
    .reset        (rstin),
    .datain       (tmdsclkint));

  OBUFDS TMDS3 (.I(tmdsclk), .O(TMDS[3]), .OB(TMDSB[3])) ;// clock

  //
  // Forward TMDS Data: 3 channels
  //
  serdes_n_to_1 #(.SF(5)) oserdes0 (
             .ioclk(pclkx10),
             .serdesstrobe(serdesstrobe),
             .reset(rstin),
             .gclk(pclkx2),
             .datain(tmds_data0),
             .iob_data_out(tmdsint[0])) ;

  serdes_n_to_1 #(.SF(5)) oserdes1 (
             .ioclk(pclkx10),
             .serdesstrobe(serdesstrobe),
             .reset(rstin),
             .gclk(pclkx2),
             .datain(tmds_data1),
             .iob_data_out(tmdsint[1])) ;

  serdes_n_to_1 #(.SF(5)) oserdes2 (
             .ioclk(pclkx10),
             .serdesstrobe(serdesstrobe),
             .reset(rstin),
             .gclk(pclkx2),
             .datain(tmds_data2),
             .iob_data_out(tmdsint[2])) ;

  OBUFDS TMDS0 (.I(tmdsint[0]), .O(TMDS[0]), .OB(TMDSB[0])) ;
  OBUFDS TMDS1 (.I(tmdsint[1]), .O(TMDS[1]), .OB(TMDSB[1])) ;
  OBUFDS TMDS2 (.I(tmdsint[2]), .O(TMDS[2]), .OB(TMDSB[2])) ;

  encode encb (
    .clkin	(pclk),
    .rstin	(rstin),
    .din		(blue_din),
    .c0			(hsync),
    .c1			(vsync),
    .de			(de),
    .dout		(blue)) ;

  encode encg (
    .clkin	(pclk),
    .rstin	(rstin),
    .din		(green_din),
    .c0			(1'b0),
    .c1			(1'b0),
    .de			(de),
    .dout		(green)) ;
    
  encode encr (
    .clkin	(pclk),
    .rstin	(rstin),
    .din		(red_din),
    .c0			(1'b0),
    .c1			(1'b0),
    .de			(de),
    .dout		(red)) ;

  wire [29:0] s_data = {red[9:5], green[9:5], blue[9:5],
                        red[4:0], green[4:0], blue[4:0]};

  convert_30to15_fifo pixel2x (
    .rst     (rstin),
    .clk     (pclk),
    .clkx2   (pclkx2),
    .datain  (s_data),
    .dataout ({tmds_data2, tmds_data1, tmds_data0}));

endmodule
