randyrossi/vicii-kawari/hdl/vicii.v

// This file is part of the vicii-kawari distribution
// (https://github.com/randyrossi/vicii-kawari)
// Copyright (c) 2022 Randy Rossi.
// 
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
`timescale 1ns / 1ps

`include "common.vh"

// We initialize raster_x,raster_y = (0,0) and let the fist tick
// bring us to raster_x=1 because that initial state is common to all
// chip types. So for reset conditions, remember we are starting things
// off with PHI LOW but already 1/4 the way through its phase and with
// DOT high but already on the second pixel. (This really only matters
// for the simulator since things would eventually fall into line anyway).

// Notes on RST : The reset signal has to reach every flip flop we
// end up resetting.  Try to keep this list to essential resets only.
// i.e, those that are necessary for a sane start state. If the toolchain
// complains about placing dbl into IOB that is connected to flip flops
// with multiple set/reset signals, it'slikely a reset signal (or signals)
// causing it.
//
// clk_dot4x;     32.727272 Mhz NTSC, 31.527955 Mhz PAL
// clk_col4x;     14.318181 Mhz NTSC, 17.734475 Mhz PAL
// clk_dot;       8.18181 Mhz NTSC, 7.8819888 Mhz PAL
// clk_col        3.579545 Mhz NTSC, 4.43361875 Mhz PAL
// clk_col16x     57.272720 Mhz NTSC, 70.9379 Mhz PAL
// clk_phi        1.02272 Mhz NTSC, .985248 Mhz PAL

module vicii
           #(
           parameter ram_width = `VIDEO_RAM_WIDTH
           )
           (
`ifdef HIRES_RESET
           input cpu_reset_i,
`endif
`ifdef SIMULATOR_BOARD
           input[1:0] sim_chip,
`endif
           input standard_sw,
           output rst,
           input clk_dot4x,
`ifdef EFINIX
`ifdef WITH_DVI
           input clk_dvi,
           input rst_dvi,
`endif
`endif
           output clk_phi,
           input clk_col16x,
`ifdef EFINIX
           input clk_col16x_4tm,
`endif
`ifdef GEN_LUMA_CHROMA
`ifndef REV_3_BOARD
           output luma_sink,
`endif
           output [5:0] luma,
           output [5:0] chroma,
           output ntsc_50,
           //output pal_60,
`endif

`ifdef NEED_RGB
           output active,
           output hsync,
           output vsync,
           output [5:0] red,
           output [5:0] green,
           output [5:0] blue,
`endif
           output [11:0] ado,
           input [5:0] adi,
           output [7:0] dbo,
           input [11:0] dbi,
           input ce,
           input rw,
           output irq,
           input lp,
           output reg aec,
           output reg ba_d2, // output a delayed ba signal to match genuine
           output ras,
           output cas,
           output ls245_data_dir,
           output ls245_addr_dir,
           output vic_write_db,
           output vic_write_ab,
           //output ls245_addr_oe,
           //output ls245_data_oe,
`ifdef WITH_EXTENSIONS
`ifdef HAVE_FLASH
           output flash_s,
`endif
`ifdef HAVE_EEPROM
           input cfg_reset,
           output eeprom_s,
`endif
           input spi_lock,
           input extensions_lock,
           input persistence_lock,
`ifdef WITH_SPI
           output spi_d,
           input  spi_q,
           output spi_c,
`endif
`endif // WITH_EXTENSIONS
           output rw_ctl,
           output [1:0] chip               // exported from registers
       );

wire [9:0] xpos;
wire [9:0] raster_x;
wire [8:0] raster_line;
reg [3:0] pixel_color3;

// BA must go low 3 cycles before any dma access on a PHI
// HIGH phase.

// AEC is LOW for PHI LOW phase (vic) and HIGH for PHI
// HIGH phase (cpu) but kept LOW in PHI HIGH phase if vic
// 'stole' a cpu cycle.

// Limits for different chips
reg [9:0] raster_x_max;
reg [8:0] raster_y_max;
reg [9:0] max_xpos;
reg [6:0] sprite_dmachk1;
reg [6:0] sprite_dmachk2;
reg [6:0] sprite_yexp_chk;
reg [6:0] sprite_disp_chk;
reg [9:0] chars_ba_start;
reg [9:0] chars_ba_end;

// These xpos's cover the sprite dma period and 3 cycles
// before the first dma access is required. They are used
// in ba low calcs.
wire [9:0] sprite_ba_start [`NUM_SPRITES-1:0];
wire [9:0] sprite_ba_end [`NUM_SPRITES-1:0];

// sprite_raster_x is raster_x but offset such that the BA fall for the
// first sprite is position 0. This is so we can use a simple interval
// comparison for ba high/low and avoid wrap around conditions.
wire [9:0] sprite_raster_x;

// Set limits for chips
`ifdef SIMULATOR_BOARD
// Ugly hack for simulator. Verilator is not letting us
// change chip from driver. So perform this at every
// clock edge.
always @(posedge clk_dot4x)
`else
always @(chip)
`endif
case(chip)
    `CHIP6567R8:
    begin
        raster_x_max = 10'd519;    // 520 pixels
        raster_y_max = 9'd262;     // 263 lines
        max_xpos = 10'h1ff;
        sprite_dmachk1 = 7'd55;    // low phase
        sprite_dmachk2 = 7'd56;    // low phase
        sprite_yexp_chk = 7'd56;   // high phase
        sprite_disp_chk = 7'd58;
        chars_ba_start = 'h1f4;
        chars_ba_end = 'h14c;
    end
    `CHIP6567R56A:
    begin
        raster_x_max = 10'd511;    // 512 pixels
        raster_y_max = 9'd261;     // 262 lines
        max_xpos = 10'h1ff;
        sprite_dmachk1 = 7'd55;    // low phase
        sprite_dmachk2 = 7'd56;    // low phase
        sprite_yexp_chk = 7'd56;   // high phase
        sprite_disp_chk = 7'd57;
        chars_ba_start = 'h1f4;
        chars_ba_end = 'h14c;
    end
    `CHIP6569R1, `CHIP6569R3:
    begin
        raster_x_max = 10'd503;     // 504 pixels
        raster_y_max = 9'd311;      // 312
        max_xpos = 10'h1f7;
        sprite_dmachk1 = 7'd54;     // low phase
        sprite_dmachk2 = 7'd55;     // low phase
        sprite_yexp_chk = 7'd55;    // high phase
        sprite_disp_chk = 7'd57;
        chars_ba_start = 'h1ec;
        chars_ba_end = 'h14c;
    end
endcase

// Used to generate phi and dot clocks
reg [31:0] phi_gen;

// Used to detect rising edge of dot clock inside a dot4x always block
// Sequence goes 1 2 3 0:
//    [1] is first tick inside a single (standard fat 320x200) pixel
//    [0] is last tick inside a single (standard fat 320x200) pixel
reg [3:0] dot_rising;

// Delayed raster line for irq comparison
wire [8:0] raster_line_d;

`ifdef SIMULATOR_BOARD
reg [7:0] reg11_delayed;
`endif

reg bmm_delayed;
reg mcm_delayed;
reg ecm_delayed;

// xpos is the x coordinate relative to raster irq. It is not simply
// raster_x with an offset. It does not increment on certain cycles for
// 6567R8 chips and wraps at the high phase of cycle 12.

// What cycle we are on. Only valid on PPS[2] (or greater) within a
// half-phase.
wire [3:0] cycle_type;

// Current sprite number for dma cycles
wire [2:0] sprite_cnt;

// Video matrix and character banks.
wire [3:0] vm;
wire [2:0] cb;

// cycleNum : Each cycle is 8 pixels.
// 6567R56A : 0-63
// 6567R8   : 0-64
// 6569RX   : 0-62
// NOTE: cycle_num is not valid until PPS[1] within low phase of PHI
wire [6:0] cycle_num;

// ec : border (edge) color
wire [3:0] ec;
// b#c : background color registers
wire [3:0] b0c,b1c,b2c,b3c;

// Lets us detect our progress through a half cycle inside a dot4x block.
// Range is 0-15. PPS[15] == 1 means PHI will transition next tick.
reg [15:0] phi_phase_start;

// Tracks whether the condition for triggering these
// types of interrupts happened, but may not be
// reported via irq unless enabled
reg irst;
wire ilp;
wire immc;
wire imbc;
wire idma;

// Interrupt latches for $d019, these are set HIGH when an interrupt of that
// type occurs. They are not automatically cleared by the VIC.
wire irst_clr;
wire imbc_clr;
wire immc_clr;
wire ilp_clr;
wire idma_clr;

// Interrupt enable registers for $d01a, these determine if these types of
// interrupts will make irq low.
wire erst;
wire embc;
wire emmc;
wire elp;
wire edma;

// If enabled, what raster line do we trigger irq for irst?
wire [8:0] raster_irq_compare;

// Keeps track of whether raster irq was raised on a line
reg raster_irq_triggered;

wire [9:0] vc; // video counter
wire [2:0] rc; // row counter

`ifdef WITH_EXTENSIONS

`ifdef HIRES_MODES
wire [ram_width-1:0] video_ram_addr_b;
wire [7:0] video_ram_data_out_b;
wire [10:0] hires_vc; // hires video counter
wire [14:0] hires_fvc; // hires video counter (for 16k or 32k bitmap modes)
wire [2:0] hires_rc; // hires row counter
wire [2:0] hires_char_pixel_base;
wire [3:0] hires_matrix_base;
wire [3:0] hires_color_base;
wire [2:0] hires_mode;
wire [7:0] hires_pixel_data;
wire [7:0] hires_color_data;
wire [7:0] hires_cursor_hi;
wire [7:0] hires_cursor_lo;
wire hires_enabled;
wire hires_allow_bad;
wire [10:0] hires_raster_x;
reg hires_badline;
`endif
`endif // WITH_EXTENSIONS

wire idle;

wire den; // display enable
wire bmm; // bitmap mode
wire ecm; // extended color mode

wire [2:0] xscroll;
wire [2:0] yscroll;

wire rsel; // border row select
wire csel; // border column select
wire mcm; // multi color mode

wire is_background_pixel0;
`ifdef HIRES_MODES
wire hires_is_background_pixel;
`endif

// mostly used for iterating over sprites
integer n;

// char read off the bus, eventually transfered to char_read
wire [11:0] char_next;

// pixels read off the data bus and char read from the bus (char_next on
// badline) or char_buf (not badline)
wire [11:0] char_read;
wire [7:0] pixels_read;

// badline condition
reg badline;

// determines when ba should drop due to chars and sprites
reg ba_chars;
reg [7:0] ba_sprite;

// NOTE: The sprite_*_o regs/wires are 'flattened' 2D arrays that we
// pack and slice between modules.  Verilog does not support passing
// 2D arrays to modules as params so we have to do this for our
// sprite arrays.  The module that owns the register declares a
// 'flattened' _o output wire that we hook up here.  Any module that
// receives the _o flattened wire via an input will slice it apart
// back into a usable 2D array.
wire [71:0] sprite_x_o; // 9 bits * 8 sprites
wire [63:0] sprite_y_o; // 8 bits * 8 sprites
wire [31:0] sprite_col_o; // 4 bits * 8 sprites
wire [63:0] sprite_ptr_o; // 8 bits * 8 sprites
wire [47:0] sprite_mc_o; // 6 bits * 8 sprites
wire [15:0] sprite_cur_pixel_o; // 2 bits * 8 sprites

// Some sprite stuff
wire [7:0] sprite_pri;
wire [3:0] sprite_mc0;
wire [3:0] sprite_mc1;
wire [7:0] sprite_en;
wire [7:0] sprite_xe;
wire [7:0] sprite_ye;
wire [7:0] sprite_mmc;
wire [`NUM_SPRITES - 1:0] sprite_dma;

// Setup sprite ba start/end ranges.  These are compared against
// sprite_raster_x which is makes sprite #0 drop point = 0
// TODO: Should these end values be +4 to rise back up with
// AEC/PHI? Find out on the scope.
assign sprite_ba_start[0] = 10'd0 + 10'd16 * 0;
assign sprite_ba_end[0] = 10'd40 + 10'd16 * 0;
assign sprite_ba_start[1] = 10'd0 + 10'd16 * 1;
assign sprite_ba_end[1] = 10'd40 + 10'd16 * 1;
assign sprite_ba_start[2] = 10'd0 + 10'd16 * 2;
assign sprite_ba_end[2] = 10'd40 + 10'd16 * 2;
assign sprite_ba_start[3] = 10'd0 + 10'd16 * 3;
assign sprite_ba_end[3] = 10'd40 + 10'd16 * 3;
assign sprite_ba_start[4] = 10'd0 + 10'd16 * 4;
assign sprite_ba_end[4] = 10'd40 + 10'd16 * 4;
assign sprite_ba_start[5] = 10'd0 + 10'd16 * 5;
assign sprite_ba_end[5] = 10'd40 + 10'd16 * 5;
assign sprite_ba_start[6] = 10'd0 + 10'd16 * 6;
assign sprite_ba_end[6] = 10'd40 + 10'd16 * 6;
assign sprite_ba_start[7] = 10'd0 + 10'd16 * 7;
assign sprite_ba_end[7] = 10'd40 + 10'd16 * 7;

// When we pass xpos to the sprite module, we subtract 6 pixels to make
// shifting start at the right time.  The output pixels are shifted another
// 6 before reaching the pixel sequencer.
wire [9:0] xpos_sprite;
assign xpos_sprite = xpos >= 10'd6 ? xpos - 10'd6 : max_xpos - 10'd5 + xpos;

// Shift dot_rising register.
always @(posedge clk_dot4x)
    if (rst)
        dot_rising <= 4'b1000;
    else
        dot_rising <= {dot_rising[2:0], dot_rising[3]};

// This is our PHI clock signal generator. Misaligned at reset
// due to where we start our x pos.
always @(posedge clk_dot4x)
    if (rst) begin
        phi_gen <= 32'b00000000000011111111111111110000;
    end else begin
        phi_gen <= {phi_gen[30:0], phi_gen[31]};
    end

assign clk_phi = phi_gen[0];

// PHI phase start shifter. Misaligned at reset due to where we
// start our x pos.
always @(posedge clk_dot4x)
    if (rst) begin
        phi_phase_start <= 16'b0000000000001000;
    end else
        phi_phase_start <= {phi_phase_start[14:0], phi_phase_start[15]};

// This is simply raster_x divided by 8.
assign cycle_num = raster_x[9:3];

// allow_bad_lines goes high on line 48
// if den is high at any point on line 48
// allow_bad_lines falls on line 248
// den only takes effect on line 48 (including very last cycle)
reg allow_bad_lines;
always @(posedge clk_dot4x)
begin
    //if (rst)
    //    allow_bad_lines = `FALSE;
    //else
    if (~clk_phi && phi_phase_start[1]) begin
        // Use raster_line_d here on [1] before it transitions
        // to the next line in the low cycle so we can catch
        // den on the last cycle of line 48.  den01-49-1.prg
        // sets den on the last cycle of line 48 (PAL cycle 62) so
        // our check has to be made before raster line changes.
        // For cycle 0, use raster_line to catch den at the
        // beginning of 48.
        if (den && ((raster_line == 48 && cycle_num == 0) ||
                    raster_line_d == 48))
            allow_bad_lines = `TRUE;

        if (raster_line == 248)
            allow_bad_lines = `FALSE;

        badline = `FALSE;
        if (raster_line[2:0] == yscroll &&
`ifdef HIRES_MODES
            // Effectively disables badlines when hires is enabled
            (allow_bad_lines == `TRUE && (!hires_enabled | hires_allow_bad))
`else
            allow_bad_lines == `TRUE
`endif
               && raster_line >= 48 && raster_line < 248)
            badline = `TRUE;

`ifdef HIRES_MODES
        hires_badline = `FALSE;
        if (raster_line[2:0] == yscroll && raster_line >= 48 && raster_line < 248)
            hires_badline = `TRUE;
`endif
    end
end

// Raise raster irq once per raster line
reg [8:0] raster_irq_compare_d;
always @(posedge clk_dot4x) begin
    //if (rst) begin
    //    irst <= `FALSE;
    //    raster_irq_triggered <= `FALSE;
    //end else
    begin
        if (clk_phi)
            raster_irq_compare_d <= raster_irq_compare;
        // To pass rasterirq_hold.prg, we have to make sure raster_irq_compare
        // is set along with the time raster_line_d changes.  This test
        // program 'chases' the raster line comparison test so that the VICII
        // comparison always results in a match (after line 18). So
        // raster_irq_triggered remains true and only lines 16,17,18 should
        // trigger irq (for this particular test program).
        if (raster_line_d == raster_irq_compare_d) begin
            if (clk_phi && phi_phase_start[1] && !raster_irq_triggered) begin
                raster_irq_triggered <= `TRUE;
                irst <= `TRUE;
            end
        end else begin
            raster_irq_triggered <= `FALSE;
        end

        if (irst_clr)
            irst <= `FALSE;
    end
end

// NOTE: Things like raster irq conditions happen even if the enable bit is off.
// That means as soon as erst is enabled, for example, if the condition was
// met, it will trigger irq immediately.  This seems consistent with how the
// C64 works.  Even if you set raster_irq_compare to 11, when you first enable
// erst, your ISR will get called immediately on the next line. Then, only afer
// you clear the interrupt will you actually get the ISR on the desired line.
assign irq = (ilp & elp) | (immc & emmc) | (imbc & embc) | (irst & erst)
`ifdef WITH_RAM
   | (idma & edma)
`endif
;

// Handle border
wire main_border;
wire top_bot_border;

// Border values are delayed by 6 pixels before entering the pixel
// sequencer  but we use the non delayed values for VICE comparison.
reg main_border_d1;
reg main_border_d2;
reg main_border_d3;
reg main_border_d4;
reg main_border_d5;
reg top_bot_border_d1;
reg top_bot_border_d2;
reg top_bot_border_d3;
reg top_bot_border_d4;
reg top_bot_border_d5;

border vic_border(
           .clk_dot4x(clk_dot4x),
           .clk_phi(clk_phi),
           .cycle_num(cycle_num),
           .xpos(xpos),
           .raster_line(raster_line),
           .rsel(rsel),
           .csel(csel),
           .den(den),
           .dot_rising(dot_rising[1]),
           .vborder(top_bot_border),
           .main_border(main_border)
       );

always @(posedge clk_dot4x)
begin
    if (dot_rising[0]) begin
        main_border_d1 <= main_border;
        main_border_d2 <= main_border_d1;
        main_border_d3 <= main_border_d2;
        main_border_d4 <= main_border_d3;
        main_border_d5 <= main_border_d4;
        top_bot_border_d1 <= top_bot_border;
        top_bot_border_d2 <= top_bot_border_d1;
        top_bot_border_d3 <= top_bot_border_d2;
        top_bot_border_d4 <= top_bot_border_d3;
        top_bot_border_d5 <= top_bot_border_d4;
    end
end

wire [7:0] lpx;
wire [7:0] lpy;
lightpen vic_lightpen(
             .clk_dot4x(clk_dot4x),
             .clk_phi(clk_phi),
             .phi_phase_start_sof(phi_phase_start[8]),
             .chip(chip),
             .ilp_clr(ilp_clr),
             .raster_line(raster_line),
             .raster_line_d(raster_line_d),
             .raster_y_max(raster_y_max),
             .cycle_num(cycle_num),
             .lp(lp),
             .xpos_div_2(xpos[8:1]),
             .lpx(lpx),
             .lpy(lpy),
             .ilp(ilp)
         );

wire[5:0] blink_ctr;
raster vic_raster(
           .clk_phi(clk_phi),
           .clk_dot4x(clk_dot4x),
           .rst(rst),
           .phi_phase_start_sof(phi_phase_start[0]),
           .dot_rising_0(dot_rising[0]),
           .chip(chip),
           .cycle_num(cycle_num),
           .raster_x_max(raster_x_max),
           .raster_y_max(raster_y_max),
           .xpos(xpos),
           .raster_x(raster_x),
`ifdef HIRES_MODES
           .blink_ctr(blink_ctr),
           .dot_rising_2(dot_rising[2]),
           .hires_raster_x(hires_raster_x),
`endif
           .sprite_raster_x(sprite_raster_x),
           .raster_line(raster_line),
           .raster_line_d(raster_line_d)
       );

matrix vic_matrix(
           .rst(rst),
           .clk_phi(clk_phi),
           .clk_dot4x(clk_dot4x),
           .phi_phase_start_1(phi_phase_start[1]),
           .phi_phase_start_14(phi_phase_start[14]),
           .cycle_num(cycle_num),
           .raster_line(raster_line),
           .badline(badline),
           .idle(idle),
           .vc(vc),
           .rc(rc)
       );

`ifdef HIRES_MODES
hires_matrix vic_hires_matrix(
                 .rst(rst),
                 .clk_phi(clk_phi),
                 .clk_dot4x(clk_dot4x),
                 .phi_phase_start_1(phi_phase_start[1]),
                 .phi_phase_start_14(phi_phase_start[14]),
                 .cycle_num(cycle_num),
                 .raster_line(raster_line),
                 .hires_badline(hires_badline),
                 .hires_vc(hires_vc),
                 .hires_fvc(hires_fvc),
                 .hires_rc(hires_rc)
             );
`endif

// Handle when ba should go low due to c-access. We can use xpos
// here since there are no repeats within this range.
always @(*)
    //if (rst)
    //    ba_chars = 1'b0;
    //else
    begin
        if ((xpos >= chars_ba_start || xpos < chars_ba_end) && badline)
            ba_chars = 1'b0;
        else
            ba_chars = 1'b1;
    end

// Handle when ba should go low due to s-access. These ranges are
// compared against sprite_raster_x which is just raster_x with an
// offset that brings sprite 0 to the start.
always @(*) begin
    for (n = 0; n < `NUM_SPRITES; n = n + 1) begin
        if (sprite_dma[n] && sprite_raster_x >= sprite_ba_start[n] &&
                sprite_raster_x < sprite_ba_end[n])
            ba_sprite[n] = 1;
        else
            ba_sprite[n] = 0;
    end
end

// Used internally. For external ba, use ba_d2.
reg ba;
// Drop BA if either chars or sprites need it.
always @(posedge clk_dot4x)
    ba <= ba_chars & (ba_sprite == 0);

// Produce a delayed version of ba for output. 2 ticks to match genuine.
reg ba_d1;
always @(posedge clk_dot4x)
begin
    ba_d1 <= ba;
    ba_d2 <= ba_d1;
end

// Cascade ba through three cycles, making sure
// aec is lowered 3 cycles after ba went low
reg ba1,ba2,ba3;
always @(posedge clk_dot4x)
    if (clk_phi == `TRUE && phi_phase_start[15]) begin
        ba1 <= ba;
        ba2 <= ba1 | ba;
        ba3 <= ba2 | ba;
    end

// Cycle state machine
cycles vic_cycles(
           .rst(rst),
           .clk_dot4x(clk_dot4x),
           .clk_phi(clk_phi),
           .chip(chip),
           .phi_phase_start_1(phi_phase_start[1]),
           .sprite_dma(sprite_dma),
           .badline(badline),
           .cycle_num(cycle_num),
           .cycle_type(cycle_type),
           .sprite_cnt(sprite_cnt)
       );

// sprite logic
wire handle_sprite_crunch;
wire m2m_clr;
wire m2d_clr;
wire [7:0] sprite_m2m;
wire [7:0] sprite_m2d;

wire [7:0] sprite_mmc_d;
wire [7:0] sprite_pri_d;
wire [3:0] active_sprite_d;

// We use the same last_bus trick VICE uses because
// it's easier to remember dbi or dbo depending on
// whether the VIC was written to or read from. Also
// we can't read the databus when AEC is high because
// the tranceivers are set to output. So we init
// this to 0xff at the start of every cycle and if
// the VIC was read from/written to, we set the value
// to be ready for sprite dma to use in sprites.v
wire [7:0] last_bus;

sprites vic_sprites(
            .rst(rst),
            .clk_dot4x(clk_dot4x),
            .clk_phi(clk_phi),
            .cycle_type(cycle_type),
            .dbi8(dbi[7:0]),
            .last_bus(last_bus),
            .dot_rising_1(dot_rising[1]),
            .dot_rising_2(dot_rising[2]),
            .phi_phase_start_m2clr(phi_phase_start[`M2CLR_CHECK]),
            .phi_phase_start_1(phi_phase_start[1]),
            .phi_phase_start_dav(phi_phase_start[`DATA_DAV]),
            .xpos(xpos_sprite[8:0]), // top bit omitted
            .raster_line(raster_line[7:0]), // top bit omitted
            .cycle_num(cycle_num),
            .cycle_bit(raster_x[2:0]),
            .handle_sprite_crunch(handle_sprite_crunch),
            .sprite_x_o(sprite_x_o),
            .sprite_y_o(sprite_y_o),
            .sprite_xe(sprite_xe),
            .sprite_ye(sprite_ye),
            .sprite_en(sprite_en),
            .sprite_mmc(sprite_mmc),
            .sprite_pri(sprite_pri),
            .sprite_pri_d(sprite_pri_d),
            .sprite_cnt(sprite_cnt),
            .aec(aec),
            .is_background_pixel(is_background_pixel0),
`ifdef HIRES_MODES
            .hires_enabled(hires_enabled),
            .hires_is_background_pixel(hires_is_background_pixel),
`endif
            .imbc_clr(imbc_clr),
            .immc_clr(immc_clr),
            .sprite_dmachk1(sprite_dmachk1),
            .sprite_dmachk2(sprite_dmachk2),
            .sprite_yexp_chk(sprite_yexp_chk),
            .sprite_disp_chk(sprite_disp_chk),
            .immc(immc),
            .imbc(imbc),
            .sprite_cur_pixel_o(sprite_cur_pixel_o),
            .sprite_mc_o(sprite_mc_o),
            .sprite_dma(sprite_dma),
            .m2m_clr(m2m_clr),
            .m2d_clr(m2d_clr),
            .sprite_m2m(sprite_m2m),
            .sprite_m2d(sprite_m2d),
            .sprite_mmc_d(sprite_mmc_d),
            .active_sprite_d(active_sprite_d)
        );


// AEC LOW tells CPU to tri-state its bus lines
// AEC will remain HIGH during PHI phase 2 for one extra cycle
// after which it will remain LOW with ba. This extra cycle
// seems to quell noise at the start of AEC low cycle (source
// remains a mystery)
// Provide a delayed version of aec in aec2
reg aec2;
always @(posedge clk_dot4x)
begin
    aec <= ba ? clk_phi : ba3 & clk_phi;
    aec2 <= aec;
end

// For reference, on LS245's:
//    OE pin low = all channels active
//    OE pin high = all channels disabled
//    DIR pin low = Bx to Ax (vic sets bus)
//    DIR pin high = Ax to Bx (vic reads bus)

// Both data/addr LS245s have OE pin grounded (always enabled)

// We write to the data bus when chip select is low and rw is high
// (cpu reading from us).  We also claim the databus if we are
// performing DMA which is the only time rw_ctl is ever HI. This
// also only ever happens when AEC is LO and if WITH_RAM is defined.
`ifdef WITH_RAM
assign vic_write_db = (rw && ~ce) | rw_ctl;
`else
assign vic_write_db = (rw && ~ce);
`endif


// AEC low means we own the address bus so we can write to it.
// For address bus direction pin, use aec,
// This used to be simply ~aec.  But instead we use
// ~(aec | aec2) so that we switch to output an extra tick after aec
// falls but still switch back to input with rising aec.
assign vic_write_ab = ~(aec | aec2);

// For data bus direction, use inverse of vic_write_db
assign ls245_data_dir = ~vic_write_db;
assign ls245_addr_dir = ~vic_write_ab;

// When AEC is high, engage address/data lines only if CE is low
// When AEC is low, VIC owns bus so we engage address/data lines
//assign ls245_addr_oe = aec ? ce : 1'b0;
//assign ls245_data_oe = aec ? ce : 1'b0;

// Handle cycles that perform data bus accesses
bus_access vic_bus_access(
               .clk_dot4x(clk_dot4x),
               .phi_phase_start_dav(phi_phase_start[`DATA_DAV]),
               .cycle_type(cycle_type),
               .dbi(dbi),
               .idle(idle),
               .sprite_cnt(sprite_cnt),
               .sprite_dma(sprite_dma),
               .sprite_ptr_o(sprite_ptr_o),
               .pixels_read(pixels_read),
               .char_read(char_read),
               .char_next(char_next),
               .aec(aec)
           );

`ifdef WITH_RAM
wire dma_done;
wire [15:0] dma_addr;
`endif

// ras signal driven only by dot4x for registers module
`ifdef EFINIX
wire ras_registers;
`endif

// Address generation
addressgen vic_addressgen(
               .rst(rst),
               .chip(chip),
               .cycle_type(cycle_type),
               .clk_dot4x(clk_dot4x),
`ifdef EFINIX
               .clk_col16x(clk_col16x_4tm),
`endif
               .cb(cb),
`ifdef WITH_RAM
               .dma_done(dma_done),
               .dma_addr(dma_addr),
`endif
               .vc(vc),
               .vm(vm),
               .rc(rc),
               .ras(ras),
`ifdef EFINIX
               .ras_registers(ras_registers),
`endif
               .cas(cas),
               .bmm_old(bmm_delayed),
               .bmm_now(bmm),
               .ecm_old(ecm_delayed),
               .ecm_now(ecm),
               .idle(idle),
               .refc_hold(raster_line == raster_y_max),
               .char_ptr(char_next[7:0]),
               .aec(aec),
               .sprite_cnt(sprite_cnt),
               .sprite_ptr_o(sprite_ptr_o),
               .sprite_mc_o(sprite_mc_o),
               .phi_phase_start(phi_phase_start),
               .ado(ado));

`ifdef HIRES_MODES
hires_addressgen vic_hires_addressgen(
                     .clk_dot4x(clk_dot4x),
                     .clk_phi(clk_phi),
                     .phi_phase_start(phi_phase_start),
                     .cycle_num(cycle_num),
                     .hires_mode(hires_mode),
                     .matrix_base(hires_matrix_base),
                     .char_pixel_base(hires_char_pixel_base),
                     .color_base(hires_color_base),
                     .rc(hires_rc),
                     .vc(hires_vc),
                     .fvc(hires_fvc),
                     .char_case(cb[0]),
                     .video_mem_addr(video_ram_addr_b),
                     .video_mem_data(video_ram_data_out_b),
                     .hires_pixel_data(hires_pixel_data),
                     .hires_color_data(hires_color_data)
                 );
`endif

// Handle set/get registers
//
// Since color registers are owned by registers, we pass in the
// final stage 4 output pixel index to get rgb values
`ifdef NEED_RGB
wire[3:0] pixel_color4_vga;
wire half_bright;
wire is_native_y;
wire is_native_x;
wire show_raster_lines;
wire enable_csync;
wire hpolarity;
wire vpolarity;
`endif

`ifdef GEN_LUMA_CHROMA
wire [5:0] lumareg_o;
wire [7:0] phasereg_o;
wire [3:0] amplitudereg_o;
wire white_line;
`ifdef LUMACODE
wire lumacode;
`endif
`ifdef CONFIGURABLE_LUMAS
wire [5:0] blanking_level;
wire [3:0] burst_amplitude;
`endif
`endif

`ifdef CONFIGURABLE_TIMING
wire timing_change;
wire [7:0] timing_h_blank;
wire [7:0] timing_h_fporch;
wire [7:0] timing_h_sync;
wire [7:0] timing_h_bporch;
wire [7:0] timing_v_blank;
wire [7:0] timing_v_fporch;
wire [7:0] timing_v_sync;
wire [7:0] timing_v_bporch;
`endif

registers vic_registers(
              .rst(rst),
`ifdef HIRES_RESET
              .cpu_reset_i(cpu_reset_i),
`endif
`ifdef SIMULATOR_BOARD
              .sim_chip(sim_chip),
`endif
              .standard_sw(standard_sw),
              .clk_dot4x(clk_dot4x),
`ifdef EFINIX
`ifdef WITH_DVI
              .clk_dvi(clk_dvi),
`else
              .clk_dvi(clk_dot4x),
`endif
`else
              .clk_dvi(clk_dot4x),
`endif
              .clk_phi(clk_phi),
              .phi_phase_start(phi_phase_start),
              .ce(ce),
              .rw(rw),
              .aec(aec),
`ifdef EFINIX
              .ras(ras_registers),
`else
              .ras(ras),
`endif
              .adi(adi),
              .dbi(dbi[7:0]),
              .raster_line(raster_line_d), // advertise the delayed version
              .irq(irq),
              .ilp(ilp),
              .immc(immc),
              .imbc(imbc),
              .irst(irst),
`ifdef WITH_RAM
              .idma(idma),
`endif
              .sprite_m2m(sprite_m2m),
              .sprite_m2d(sprite_m2d),
              .lpx(lpx),
              .lpy(lpy),
              .ec(ec),
              .b0c(b0c),
              .b1c(b1c),
              .b2c(b2c),
              .b3c(b3c),
              .xscroll(xscroll),
              .yscroll(yscroll),
              .csel(csel),
              .rsel(rsel),
              .den(den),
              .bmm(bmm),
              .ecm(ecm),
              .mcm(mcm),
              .irst_clr(irst_clr),
              .imbc_clr(imbc_clr),
              .immc_clr(immc_clr),
              .ilp_clr(ilp_clr),
`ifdef WITH_RAM
              .idma_clr(idma_clr),
`endif
              .raster_irq_compare(raster_irq_compare),
              .sprite_en(sprite_en),
              .sprite_xe(sprite_xe),
              .sprite_ye(sprite_ye),
              .sprite_pri(sprite_pri),
              .sprite_mmc(sprite_mmc),
              .sprite_mc0(sprite_mc0),
              .sprite_mc1(sprite_mc1),
              .sprite_x_o(sprite_x_o),
              .sprite_y_o(sprite_y_o),
              .sprite_col_o(sprite_col_o),
              .m2m_clr(m2m_clr),
              .m2d_clr(m2d_clr),
              .handle_sprite_crunch(handle_sprite_crunch),
              .dbo(dbo),
              .last_bus(last_bus),
              .cb(cb),
              .vm(vm),
              .elp(elp),
              .emmc(emmc),
              .embc(embc),
              .erst(erst),
`ifdef WITH_RAM
              .edma(edma),
`endif
              // 'active' is not active for a pin, it is used to set RGB to 0
              // during blanking intervals and we need it to line up with
              // the active period for whatever video standard we are
              // producing
              .pixel_color3(pixel_color3), // always native
`ifdef LUMACODE
              .lumacode_p1(lumacode_p1),
              .lumacode_p2(lumacode_p2),
`endif
`ifdef NEED_RGB
              .pixel_color4(pixel_color4_vga), // from scan doubler
              .active(active),
              .half_bright(is_native_y ? 1'b0 :
                           (show_raster_lines & half_bright)),
              .red(red), // out
              .green(green), // out
              .blue(blue), // out
              .last_is_native_y(is_native_y), // current setting out
              .last_is_native_x(is_native_x), // current setting out
              .last_raster_lines(show_raster_lines), // current setting out
              .last_enable_csync(enable_csync), // current setting out
              .last_hpolarity(hpolarity),
              .last_vpolarity(vpolarity),
`endif

`ifdef GEN_LUMA_CHROMA
              .white_line(white_line),
`ifdef LUMACODE
              .lumacode(lumacode),
`endif
              .ntsc_50(ntsc_50),
              //.pal_60(pal_60),
              .lumareg_o(lumareg_o),
              .phasereg_o(phasereg_o),
              .amplitudereg_o(amplitudereg_o),
`endif

`ifdef WITH_EXTENSIONS
`ifdef HAVE_FLASH
              .flash_s(flash_s),
`endif
`ifdef HAVE_EEPROM
              .cfg_reset(cfg_reset),
`endif
              .spi_lock(spi_lock),
              .extensions_lock(extensions_lock),
              .persistence_lock(persistence_lock),
`ifdef GEN_LUMA_CHROMA
`ifdef CONFIGURABLE_LUMAS
              .blanking_level(blanking_level),
              .burst_amplitude(burst_amplitude),
`endif
`endif
`ifdef CONFIGURABLE_TIMING
              .timing_change(timing_change),
              .timing_h_blank(timing_h_blank),
              .timing_h_fporch(timing_h_fporch),
              .timing_h_sync(timing_h_sync),
              .timing_h_bporch(timing_h_bporch),
              .timing_v_blank(timing_v_blank),
              .timing_v_fporch(timing_v_fporch),
              .timing_v_sync(timing_v_sync),
              .timing_v_bporch(timing_v_bporch),
`endif
`ifdef HIRES_MODES
              .video_ram_addr_b(video_ram_addr_b),
              .video_ram_data_out_b(video_ram_data_out_b),
              .hires_char_pixel_base(hires_char_pixel_base),
              .hires_matrix_base(hires_matrix_base),
              .hires_color_base(hires_color_base),
              .hires_enabled(hires_enabled),
              .hires_allow_bad(hires_allow_bad),
              .hires_mode(hires_mode),
              .hires_cursor_hi(hires_cursor_hi),
              .hires_cursor_lo(hires_cursor_lo),
`endif
`ifdef WITH_SPI
              .spi_d(spi_d),
              .spi_q(spi_q),
              .spi_c(spi_c),
`endif
`ifdef HAVE_EEPROM
              .eeprom_s(eeprom_s),
`endif
`ifdef WITH_RAM
              .cycle_type(cycle_type),
              .idle(idle),
              .dma_addr(dma_addr),
              .dma_done(dma_done),
`endif
`endif // WITH_EXTENSIONS
              .rw_ctl(rw_ctl),
              .chip(chip) // config out
          );

// at the start of every high phase, store current reg11 for delayed fetch
// and badline calcs
always @(posedge clk_dot4x)
begin
    // must be before badline idle reset in vic_matrix
    if (clk_phi && phi_phase_start[0]) begin
`ifdef SIMULATOR_BOARD
        reg11_delayed <= { raster_line[8], ecm, bmm, den, rsel, yscroll };
`endif
        bmm_delayed <= bmm;
        ecm_delayed <= ecm;
        mcm_delayed <= mcm;
    end
end

`ifdef TEST_PATTERN
reg [13:0] test_pattern_addr;
wire [3:0] test_pattern_pixel;
TEST_PATTERN vic_testpattern(.clk(clk_dot4x),
                             .addr(test_pattern_addr),
                             .dout(test_pattern_pixel));
`endif

// Select between hires and lores
wire [3:0] pixel_color1;
`ifdef HIRES_MODES
wire [3:0] hires_pixel_color1;
`endif

// According to https://github.com/c0pperdragon/LumaCode/wiki/VIC-II-dizer-(for-the-C64-computer)
`ifdef LUMACODE
reg[1:0] lumacode_p1;
reg[1:0] lumacode_p2;
`endif

always @(posedge clk_dot4x)
begin
`ifdef TEST_PATTERN
    test_pattern_addr =
        (({5'b0, raster_line} - {14'd51})*14'd320) +({4'b0,raster_x} - 14'd136);
    if (raster_line >=51 && raster_line < 251 &&
            raster_x >= 136 && raster_x < 456)
        pixel_color3 <= test_pattern_pixel; //raster_x[7:4] + 4'd8;
    else
        pixel_color3 <= pixel_color1;
`else

`ifdef HIRES_MODES
    if (hires_enabled && !hires_sprite_active && (dot_rising[3] | dot_rising[1]))
        pixel_color3 <= hires_pixel_color1;
    else
`endif
        if (dot_rising[3]) begin
            pixel_color3 <= pixel_color1;

`ifdef LUMACODE
            case (pixel_color1)
               4'd0: lumacode_p1 <= 2'd0;
               4'd1: lumacode_p1 <= 2'd3;
               4'd2: lumacode_p1 <= 2'd0;
               4'd3: lumacode_p1 <= 2'd1;
               4'd4: lumacode_p1 <= 2'd0;
               4'd5: lumacode_p1 <= 2'd3;
               4'd6: lumacode_p1 <= 2'd0;
               4'd7: lumacode_p1 <= 2'd2;
               4'd8: lumacode_p1 <= 2'd2;
               4'd9: lumacode_p1 <= 2'd1;
               4'd10: lumacode_p1 <= 2'd3;
               4'd11: lumacode_p1 <= 2'd1;
               4'd12: lumacode_p1 <= 2'd1;
               4'd13: lumacode_p1 <= 2'd3;
               4'd14: lumacode_p1 <= 2'd2;
               4'd15: lumacode_p1 <= 2'd2;
            endcase

            case (pixel_color1)
               4'd0: lumacode_p2 <= 2'd0;
               4'd1: lumacode_p2 <= 2'd3;
               4'd2: lumacode_p2 <= 2'd2;
               4'd3: lumacode_p2 <= 2'd3;
               4'd4: lumacode_p2 <= 2'd3;
               4'd5: lumacode_p2 <= 2'd0;
               4'd6: lumacode_p2 <= 2'd1;
               4'd7: lumacode_p2 <= 2'd3;
               4'd8: lumacode_p2 <= 2'd0;
               4'd9: lumacode_p2 <= 2'd0;
               4'd10: lumacode_p2 <= 2'd1;
               4'd11: lumacode_p2 <= 2'd1;
               4'd12: lumacode_p2 <= 2'd2;
               4'd13: lumacode_p2 <= 2'd2;
               4'd14: lumacode_p2 <= 2'd1;
               4'd15: lumacode_p2 <= 2'd2;
            endcase
`endif // LUMACODE
        end
`endif
end

`ifdef HIRES_MODES
wire hires_sprite_active;
`endif

// Pixel sequencer - outputs stage 3 pixel_color3
pixel_sequencer vic_pixel_sequencer(
                    .clk_dot4x(clk_dot4x),
                    .clk_phi(clk_phi),
                    .dot_rising(dot_rising),
                    .phi_phase_start_pl(phi_phase_start[`PIXEL_LATCH]),
                    .phi_phase_start_dav(phi_phase_start[`DATA_DAV]),
                    .mcm(mcm_delayed), // delayed
                    .bmm(bmm_delayed), // delayed
                    .ecm(ecm_delayed), // delayed
                    .idle(idle),
                    .cycle_bit(raster_x[2:0]),
                    .cycle_num(cycle_num),
`ifdef PIXEL_LOG
                    .raster_line(raster_line),
`endif
                    .xscroll(xscroll),
                    .pixels_read(pixels_read),
                    .char_read(char_read),
                    .b0c(b0c),
                    .b1c(b1c),
                    .b2c(b2c),
                    .b3c(b3c),
                    .ec(ec),
                    .main_border(main_border_d5), // in
                    .vborder(top_bot_border_d5), // in
                    .sprite_cur_pixel_o(sprite_cur_pixel_o),
                    .sprite_pri_d(sprite_pri_d),  // delayed
                    .sprite_mmc_d(sprite_mmc_d),  // delayed
                    .sprite_col_o(sprite_col_o),
                    .sprite_mc0(sprite_mc0),
                    .sprite_mc1(sprite_mc1),
                    .is_background_pixel0(is_background_pixel0),
                    .pixel_color1(pixel_color1),
`ifdef HIRES_MODES
                    .hires_sprite_active(hires_sprite_active),
`endif
                    .active_sprite_d(active_sprite_d)
                );

`ifdef HIRES_MODES
wire hires_cursor;
assign hires_cursor = ({hires_matrix_base, hires_vc} == {hires_cursor_hi[6:0] , hires_cursor_lo});

hires_pixel_sequencer vic_hires_pixel_sequencer(
                          .rst(rst),
                          .clk_dot4x(clk_dot4x),
                          .clk_phi(clk_phi),
                          .dot_rising(dot_rising),
                          .phi_phase_start_pl(phi_phase_start[`PIXEL_LATCH]),
                          .phi_phase_start_4(phi_phase_start[4]),
                          .cycle_bit(raster_x[2:0]),
                          .hires_cycle_bit(hires_raster_x[2:0]),
                          .cycle_num(cycle_num),
                          .xscroll(xscroll),
                          .blink_ctr(blink_ctr),
                          .b0c(b0c),
                          .ec(ec),
                          .main_border(main_border_d5),
                          .vborder(top_bot_border_d5),
                          .color_base(hires_color_base),
                          .hires_pixel_color1(hires_pixel_color1),
                          .hires_enabled(hires_enabled),
                          .hires_mode(hires_mode),
                          .hires_pixel_data(hires_pixel_data),
                          .hires_color_data(hires_color_data),
                          .hires_rc(hires_rc),
                          .hires_cursor(hires_cursor),
                          .hires_is_background_pixel(hires_is_background_pixel)
                      );
`endif

// -------------------------------------------------------------
// Luma/Chroma output
// -------------------------------------------------------------
comp_sync vic_comp_sync(
              .clk_dot4x(clk_dot4x),
              .clk_col16x(clk_col16x),
              .raster_x(raster_x),
              .raster_y(raster_line),
`ifdef GEN_LUMA_CHROMA
              .white_line(white_line),
              .ntsc_50(ntsc_50),
              //.pal_60(pal_60),
`ifndef REV_3_BOARD
              .luma_sink(luma_sink),
`endif
              .luma_out(luma),
              .chroma_out(chroma),
              .lumareg_o(lumareg_o),
              .phasereg_o(phasereg_o),
              .amplitudereg_o(amplitudereg_o),
`ifdef CONFIGURABLE_LUMAS
              .blanking_level(blanking_level),
              .burst_amplitude(burst_amplitude),
`endif  // CONFIGURABLE_LUMAS
`endif // GEN_LUMA_CHROMA
              .chip(chip)
          );

// -------------------------------------------------------------
// VGA/HDMI output - hsync/vsync/active/half_bright/pixel_color4
// When X resolution is doubled, this can show hi-res modes.
// -------------------------------------------------------------
`ifdef NEED_RGB

// For Efinix boards, the timing for analog RGB and DVI are different
// so we use a different sync/pixel generator.  NOTE:  ANALOG_RGB_TIMING
// must NOT be enabled for EFINIX, otherwise the ntsc timing will be
// unusable.
`ifdef EFINIX
`ifdef WITH_DVI
`define HAVE_SYNC_MODULE 1
hires_dvi_sync vic_dvi_sync(
                   .rst(rst),
                   .rst_dvi(rst_dvi),
                   .clk_dot4x(clk_dot4x),
                   .clk_dvi(clk_dvi),
                   .dot_rising(dot_rising),
                   .enable_csync(enable_csync),
                   .hpolarity(hpolarity),
                   .vpolarity(vpolarity),
`ifdef CONFIGURABLE_TIMING
                   .timing_change_in(timing_change),
                   .timing_h_blank(timing_h_blank),
                   .timing_h_fporch(timing_h_fporch),
                   .timing_h_sync(timing_h_sync),
                   .timing_h_bporch(timing_h_bporch),
                   .timing_v_blank(timing_v_blank),
                   .timing_v_fporch(timing_v_fporch),
                   .timing_v_sync(timing_v_sync),
                   .timing_v_bporch(timing_v_bporch),
`endif // CONFIGURABLE_TIMING
                   .raster_x(raster_x),
                   .raster_y(raster_line),
                   .xpos(xpos),
`ifdef HIRES_MODES
                   .hires_raster_x(hires_raster_x),
`endif
                   .chip(chip),
                   .pixel_color3(pixel_color3),
                   .hsync(hsync),
                   .vsync(vsync),
                   .active(active),
                   .pixel_color4(pixel_color4_vga),
                   .half_bright(half_bright)
               );
`endif // WITH_DVI
`endif // EFINIX

// For Spartan6, we can share the same sync/pixel generator and
// both analog RGB and DVI can be active at the same time.
// ANALOG_RGB_TIMING should be enabled to avoid bad ntsc output
// on some monitors. If we get here for EFINIX builds, then
// we do not have DVI enabled.
`ifndef HAVE_SYNC_MODULE
hires_vga_sync vic_vga_sync(
                   .rst(rst),
                   .clk_dot4x(clk_dot4x),
                   .dot_rising(dot_rising),
                   .is_native_y_in(is_native_y),
                   .is_native_x_in(is_native_x),
                   .enable_csync(enable_csync),
                   .hpolarity(hpolarity),
                   .vpolarity(vpolarity),
`ifdef CONFIGURABLE_TIMING
                   .timing_change_in(timing_change),
                   .timing_h_blank(timing_h_blank),
                   .timing_h_fporch(timing_h_fporch),
                   .timing_h_sync(timing_h_sync),
                   .timing_h_bporch(timing_h_bporch),
                   .timing_v_blank(timing_v_blank),
                   .timing_v_fporch(timing_v_fporch),
                   .timing_v_sync(timing_v_sync),
                   .timing_v_bporch(timing_v_bporch),
`endif // CONFIGURABLE_TIMING
                   .raster_x(raster_x),
                   .raster_y(raster_line),
                   .xpos(xpos),
`ifdef HIRES_MODES
                   .hires_raster_x(hires_raster_x),
`endif
                   .chip(chip),
                   .pixel_color3(pixel_color3),
                   .hsync(hsync),
                   .vsync(vsync),
                   .active(active),
                   .pixel_color4(pixel_color4_vga),
                   .half_bright(half_bright)
               );
`endif // HAVE_SYNC_MODULE

`endif // NEED_RGB

endmodule
