randyrossi/vicii-kawari/hdl/efinix_trion/dvi/tmds_channel.v

// This file is part of the vicii-kawari distribution
// (https://github.com/randyrossi/vicii-kawari)
// Copyright (c) 2022 Randy Rossi.
// 
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
module tmds_channel
#(
    // TMDS Channel number.
    parameter integer CN = 0
)
(
    input clk_pixel,
    input [7:0] video_data,
    input [1:0] control_data,
    input mode,  // Mode select (0 = control, 1 = video)
    output reg [9:0] tmds = 10'b1101010100
);

reg signed [4:0] acc = 5'sd0;

/* verilator lint_off UNOPTFLAT */
reg [8:0] q_m;
reg [9:0] q_out;
wire [9:0] video_coding;
assign video_coding = q_out;

/* verilator lint_off WIDTH */
reg [3:0] N1D;
reg signed [4:0] N1q_m07;
reg signed [4:0] N0q_m07;
always @(*)
begin
    N1D = video_data[0] + video_data[1] + video_data[2] + video_data[3] + video_data[4] + video_data[5] + video_data[6] + video_data[7];
    case(q_m[0] + q_m[1] + q_m[2] + q_m[3] + q_m[4] + q_m[5] + q_m[6] + q_m[7])
        4'b0000: N1q_m07 = 5'sd0;
        4'b0001: N1q_m07 = 5'sd1;
        4'b0010: N1q_m07 = 5'sd2;
        4'b0011: N1q_m07 = 5'sd3;
        4'b0100: N1q_m07 = 5'sd4;
        4'b0101: N1q_m07 = 5'sd5;
        4'b0110: N1q_m07 = 5'sd6;
        4'b0111: N1q_m07 = 5'sd7;
        4'b1000: N1q_m07 = 5'sd8;
        default: N1q_m07 = 5'sd0;
    endcase
    N0q_m07 = 5'sd8 - N1q_m07;
end
/* verilator lint_on WIDTH */

reg signed [4:0] acc_add;

integer i;

/* verilator lint_off ALWCOMBORDER */
always @(*)
begin
    if (N1D > 4'd4 || (N1D == 4'd4 && video_data[0] == 1'd0))
    begin
        q_m[0] = video_data[0];
        for(i = 0; i < 7; i=i+1)
            q_m[i + 1] = q_m[i] ~^ video_data[i + 1];
        q_m[8] = 1'b0;
    end
    else
    begin
        q_m[0] = video_data[0];
        for(i = 0; i < 7; i=i+1)
            q_m[i + 1] = q_m[i] ^ video_data[i + 1];
        q_m[8] = 1'b1;
    end
    if (acc == 5'sd0 || (N1q_m07 == N0q_m07))
    begin
        if (q_m[8])
        begin
            acc_add = N1q_m07 - N0q_m07;
            q_out = {~q_m[8], q_m[8], q_m[7:0]};
        end
        else
        begin
            acc_add = N0q_m07 - N1q_m07;
            q_out = {~q_m[8], q_m[8], ~q_m[7:0]};
        end
    end
    else
    begin
        if ((acc > 5'sd0 && N1q_m07 > N0q_m07) || (acc < 5'sd0 && N1q_m07 < N0q_m07))
        begin
            q_out = {1'b1, q_m[8], ~q_m[7:0]};
            acc_add = (N0q_m07 - N1q_m07) + (q_m[8] ? 5'sd2 : 5'sd0);
        end
        else
        begin
            q_out = {1'b0, q_m[8], q_m[7:0]};
            acc_add = (N1q_m07 - N0q_m07) - (~q_m[8] ? 5'sd2 : 5'sd0);
        end
    end
end
/* verilator lint_on ALWCOMBORDER */

/* verilator lint_off WIDTH */
always @(posedge clk_pixel) acc <= mode != 3'd1 ? 5'sd0 : acc + acc_add;
/* verilator lint_on WIDTH */

// See Section 5.4.2
reg [9:0] control_coding;
always @(*)
begin
    case(control_data)
        2'b00: control_coding = 10'b1101010100;
        2'b01: control_coding = 10'b0010101011;
        2'b10: control_coding = 10'b0101010100;
        2'b11: control_coding = 10'b1010101011;
    endcase
end

// Apply selected mode.
always @(posedge clk_pixel)
begin
    tmds <= mode ? video_coding : control_coding;
end

endmodule
