randyrossi/vicii-kawari/disks/util/include/data.h

#ifndef DATA_H
#define DATA_H

#define DEFAULT_DISPLAY_FLAGS 128
#define DEFAULT_DISPLAY_FLAGS2 0

extern int colors[];
extern int luma_rev3[4][16];
extern int luma_rev4[4][16];
extern int phase[4][16];
extern int amplitude[4][16];
extern int black_levels[4];
extern int burst_levels[4];

#endif
