randyrossi/vicii-kawari/disks/util/flash/menu.c

#include <stdio.h>
#include <6502.h>
#include <peekpoke.h>
#include <conio.h>
#include <string.h>
#include <stdlib.h>

#include "util.h"
#include "kawari.h"
#include "menu.h"
#include "flash.h"

// This is the version of eeprom data we know of. If we
// encounter a version higher than this, move downward and
// apply all initializations to newly added locations until
// we reach the currently saved version.  This value needs
// to change downward whenever we add new fields we want
// to save to the eeprom (so they only get initizlied once).
// NOTE: This memory location was initialied for 0xff before
// we started verioning config schemes. That's why we count
// down instead of up.
#define MY_CFG_VERSION 0xfe

// Memory layout is
// 0x0801 : main code then heap
// 0x6000-0x7003 : 4k flash load space + checksum
// 0xa004 : fast loader (1334 bytes) 
// 0xc000 : teensy wedge (2816 bytes)
// 0xcfff : stack end (1k)
//
// The program should not exceed ~20k to leave at least 2k heap space,
// otherwise heap may get corrupted by flash tmp writes since it
// wants to grow upwards starting from the end of the code.
// Stack starts at 0xcfff and grows down. If Teensy wedge is not
// present, that leaves 10k of stack.  But if Teensy wedge is
// installed, only 1k stack is available.
//
// TODO: Use a different c64.cfg to change memory to this:
//
// 0x0801 : main code then heap
// 0xa000-0xb003 : 4k flash load space + checksum
// 0xb004 : fast loader (1334 bytes)
// 0xbfff : stack end (almost 2k)
// 0xc000 : teensy wedge
//
// This would allow for 36k code and 2k heap and would guarantee
// no collisions even with the teensy wedge (or other code at
// $c000) installed. This would require a custom c64.cfg file.

#define FLASH_VERSION_MAJOR 1
#define FLASH_VERSION_MINOR 4
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
