randyrossi/vicii-kawari/(commit log)

2020-04-19 Switch simulation to 1ns timescale
    1ps was crashing pulseview and is too high a resolution anyway
    This resolution lets us look at at least one complete frame.
2020-04-20 Add a sync signal that will be fed into the composite encoder IC
2020-04-24 Successfull video signal generated
    Using CX1645P hooked up to RGB, got a successful
    border and gfx image with correct (more or less) colors.
    [vicii.v]
2020-05-03 Ongoing dev
    verified register set/fetch for bg and border colors are working
    pixel perfect rendering for 6569, ntsc is working but only
    every other frame, got rid of colorref clock ,was confusing
    things, made sure xpos is set properly from simulator and
    vice ipc bridge, added -o for vcd output capture, added
    logging messages and some asserts, etc
2020-05-03 capture one frame option
2020-05-04 Better way of calculating xpos
    added assertions in sim to check it's correct
    [cycles.v, vicii.v]
2020-05-08 Fix ras/cas/addr mux timing
    [vicii.v]
2020-05-10 Fix a lot of clock stuff
    [vicii.v]
2020-05-12 Better logging, fix some comments
    [vicii.v]
2020-05-12 More notes about difference between VICE and actual hardware behavior
    VICE seems to think the CPU can change a register and have it
    take effect on the 2nd dot of its own phase which is unlikely
    in real hardware. It's most likely the case that actual
    hardware sees the register change after the falling edge of phi.
    Keeping like this for now.
2020-05-13 Finish viccycle
    all cycles
    add refc
    add test drivers
2020-05-14 Get reset working properly
    Fix issue with muxr not shifting
    Begin working on vicaddr
    [constants.h, vicii.v]
2020-05-15 Switch to gtkwave
    add verilog tracing option
    fix ras/cas and other signal timing
    [vicii.v]
2020-05-16 Fix lots of wrong stuff
    Make golden masters for test 1 and 2
    [constants.h, vicii.v]
2020-05-17 Fix vicCycle reset for sprite counter
    some docs
    [vicii.v]
2020-05-23 Add ability to disable fpga sync from monitor
    Some programs were poking that reg so need a way to
    disable until ready.
    Fixed issue with sync, still one pixel off from vice...
    [vicii.v]
2020-05-23 Fix sync issues again
    [vicii.v]
2020-05-23 Fix bitstream gen error in top and constraints
    [top.v]
2020-05-23 Switch to fusesoc build.
    * vicii.core declares project, no more vivado project checked in
    * separate rtl files from simulator sources
    * no more clock wizard, verilog source for clock gen
    to build project:
    Install fusesoc from https://github.com/olofk/fusesoc
    And run:
    fusesoc --cores-root=/home/ryan/vicii run --target=synth vicii
    Generated project is under "build" and can be opened with vivado
2020-05-24 Fix missing core file, move cmod specific pieces to cmod dir
    Instructions to synthesize:
    usesoc --cores-root=/home/$USER/vicii run --target=synth_cmod_a35t vicii
    [top.v]
2020-05-24 Fix typo Remove tmp file Restore missing bin/ utils Restore vivado project file Fix some warnings
    [vicii.v]
2020-05-24 Fix more warnings
    split ad into adl (inout tri) and adh (always output)
    vic never reads upper 6 bits of address
    [top.v, vicii.v]
2020-05-24 Fix warning about raster_enable
    Add test8 to make sure raster_enable rises and falls as expected
    [constants.h, vicii.v]
2020-05-24 Fix raster_enable
    raster_enable can go high anytime on line 48 if
    den goes high
    [vicii.v]
2020-05-25 setup reset line for 6510cpu
    counter will hold internel reset high for approx 150ms
    then locked on color clock will drop reset line to vic
    when program is loaded off flash, this will reset the cpu
    once the vic is ready
    [top.v]
2020-05-26 Fix broken BA signal
    [vicii.v]
2020-05-30 Fix a bunch of stuff
    Close to working on real machine. If databus (lower 8 bits) are
    disconnected, machine and seems to keep memory okay. If data
    is connected, machine will run but as soon as memory access
    is required it seems to crash. Jumpman jr intro runs on
    cartridge. Registers get set (fairly) consistently. No
    picture. Black screen on jumpman jr, garbage on boot screen.
    [top.v, vicii.v]
2020-05-31 Fix more broken stuff on real hardware
    muxing row/col was backwards
    vic write to databus condition has timing constraints too, using bit_cycle==5
    for now which seems to have dealt with contention, but no idea where that
    contention is coming from
    have to use different times for pixel/char and register read from databus
    BASIC prompt working, some cartridge games will run with glitches
    [vicii.v]
2020-06-01 Mostly working
    irq and cpu reset tested
    most programs load and run
    databus timing issue resolved
    [constants.h, vicii.v]
2020-06-01 Remove intiialization section from verilog
    This is not necessary since we hold the system under
    reset until about 100 ms after the clock is locked and
    all values should be initialized correctly in those
    blocks.
    [vicii.v]
2020-06-04 switch to R8, R56A hfreq is not okay with some monitors raster increment seems to be delayed until end of cycle 0 (match vice) add regs out from sim to vice so regs can be verified (linecrunch now re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
    sync simulator to xpos instead of xpos+8 now
2020-06-07 Fix timing of idle reset
    To avoid warning from vice sync, we need to delay the badline check inside
    the VC/RC/VCBASE counter block due to the delayed assignment of
    raster line. This eliminates the idle warning in vice sync.
    [vicii.v]
2020-06-07 Don't allow badlines outside dma start/end range
    This prevents the fpga from getting out of sync with
    vc/rc/vcbase due to going out of idle state at line
    248.
    [vicii.v]
2020-06-07 Add reg11_delayed
    use delayed reg11 for badline and address gen like vice does
    line crunch shows no sync warnings/errors anymore
    [constants.h, vicii.v]
2020-06-09 Fix xscroll issue
    Need pixel sequencer to trigger off falling edge of dot clock
    to be able to delay pixels by up to 8. Using rising
    edge caused xscroll=7 to have pixels come out 1 early.
    poke 53270,207 ( all char pixels started at 26 which is incorrect)
    [vicii.v]
2020-06-11 Adjust pixel delay and make configurable
    Making pixel delay configurable. 8 will match VICE output pixels exactly
    If this is not the case on a real C64, it can be adjusted.
2020-06-13 Add sprite collision regs
    [vicii.v]
2020-06-14 Add VIC sync for sprites
    Add VICE sync for sprite regs
    Do DMA for sprites but no use of pixel data yet
    Do proper ba low for sprites
    edge of disgrace still has right hand side glitch due to wrong fetch address (not sprite related)
    fix some cases where cycle_num was being accessed on first tick of low phase (can't do this)
    [constants.h, vicii.v]
2020-06-14 badline was changing on the wrong phase
    swap return for n key to move to next 10 lines for cycleByCycle
    [vicii.v]
2020-06-15 Lots of fixes
    - removed next_raster_line (ever need this?)
    - eliminated vicPreCycle ,this was a bad idea since
    you don't know what cycle to enter until badline
    is valid which is only valid after raster line is
    valid which is tick 1 into the phase (making badline
    valid after 2 and hence cycle change must be pushed
    to 3)
    - since we got rid of vicPreCycle, had to rework
    cas/ras/mux so that they still fall at the expected
    times (starting high at the beginning of the phase)
    but are reset 3 ticks in once we know what the cycle
    is
    - the rc reset at cycle 57 was missing the case where
    rc == 7 and badline happened which should cause
    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
    [vicii.v]
2020-06-18 Implement sprites fixed a bunch of timing issues with ba for both sprites and chars x/y expansion working no collision did not try sprite crunch
    [constants.h, vicii.v]
2020-06-18 Fix synthesis problem
    Have to move s-access to within same block as where shift happens
    [vicii.v]
2020-06-18 Fix 6567R8 cycle state machine
    Turns out VICE cycles are different than Christian's doc. Taking
    VICE as gospel. The extra idle cycle comes before the first refresh
    on the R8 unlike what Christian's doc where it is grouped with the
    idle cycles after the last g access.
    [vicii.v]
2020-06-19 Switch to cycle num for sprite ba schedule
    Switching to use cycle nums for comparison when deciding ba low/high
    Made refresh counter reset at same time vice does to eliminate address warnings
    high phase of all sprite accesses not working on real bus, need to investigate
    [constants.h, vicii.v]
2020-06-20 Fix issue with sprite pixel reads
    Previous change (to use cycles) ended up vausing Vivado
    to infer latches for ba_sprite which appears to have caused
    timing issues. Taking a different approach where we have
    a separate sprite_raster_x register that is offset so that
    it resets to 0 when the first sprite BA low should happen.
    Then everything is relative to 0 and we can use a simple
    comparison interval like we did with xpos but don't have
    to worry about wrap around conditions or repeats (R8).
    This seems to have cleaned up sprite accesses. Although
    there are still some glitches at the top of MsPacMan.
    [constants.h, vicii.v]
2020-06-20 Get rid of start_of_* flags
    This was causing grief for irq handling. It was done to
    match VICE raster_line increments but I don't think the real
    device works this way. raster_line increment in VICE is delayed
    by 1/2 cycle on cycle 0 after each line starts and then delayed again
    on frame start. But this is likely just a VICE thing and doesn't
    make sense for the fpga. It was causing irq to get raised again
    at cycle 0 because raster line was not yet incremented.
    [vicii.v]
2020-06-21 Sync border properly from VICE
    This fixes edge of disgrace missing stars. Just a sync issue.
    [constants.h, vicii.v]
2020-06-21 FIx a bunch of sprite issues
    Add sprite crunch d017 glitch handling
    Fix issue with flip flip not flipping or flopping when it should have
    Add a bunch of sprite and more reg synchronization
    This almost gets Edge of Disgrace big hand sprite working.
    [vicii.v]
2020-06-21 Fix sprite priority issue
    Renamed pixel color out pipeline regs
    [vicii.v]
2020-06-22 Fix multiple driver issue with sprite crunch
    [vicii.v]
2020-06-23 Add sprite collision logic
    fixed issue with sprite pixel registers being
    removed due to no usage along one path
    move border logic earlier
    [constants.h, vicii.v]
2020-06-23 Renaming vars to be consistent
    Using lowercase + underscores. Removing all camel case.
2020-06-23 Sprite crunch was on wrong cycle
    [vicii.v]
2020-06-24 Fix sprite crunch
    Fix a bunch of stuff with sprite crunch.
    Had sprite crunch on wrong cycle (should be 14)
    Was resetting mcbase when should have left it up to the next cycle
    Delayed is background pixel so it can be compared to delayed sprite pixels
    at right times
    This gets massively interleaved sprite crunch working (mostly)
    [vicii.v]
2020-06-24 Fix a few things wrong with RC/IDLE
    Changed idle to be blocking assignments
    VC/RC has to be done on [1] because badline isn't valid until then
    This fixes many warnings on yscroll.prg and some on lunatico
    [constants.h, vicii.v]
2020-06-24 Fix bad sprite index
    [vicii.v]
2020-06-25 Fix char/color buf on first sync and sprite collision
    We were not syncing char/color buf properly on sync so
    any frame we tried to sync to that suppressed badlines
    would never read in char/colors and we'd just get black
    for all pixels. This syncs the internal buffer from
    VICE's buffer so we can sync mid-frame without issue.
    Moved timing of sprite-sprite and sprite-data so that
    sprite5 and sprite6 tests are consistent in their
    warnings. Documented the warning but may not be a problem.
    This gets lunatico massively interleaved sprite crunch
    working (on sim) with no major warnings except 0x1f reg
    on border area. Need to investigate.
    [vicii.v]
2020-06-26 Removing previous fix that cause other issues
    sprite enable should not influence whether pixels get
    into the shifter
    edge of disgrace shows bottom thumb line again, need
    to fix in another way
    fixed some issues with imbc/immc register sync
    [constants.h, vicii.v]
2020-06-26 Fix EOD flying fist sprite crunch bottom line issue
    Don't override foreground pixels if sprite is disabled
    [vicii.v]
2020-06-28 Fix some collision stuff
    Making vice checks happy by only allowing collisions
    to take effect on low phi.
    [constants.h, vicii.v]
2020-07-01 Make PAL NTSC switch easier
    Some comments and general cleanup of code
2020-07-02 Fix sprite gitches
    Finally found the fix for flying fist EOD issue and
    fixed properly. Sprites do not have to be enabled
    to cause badlines. Also, had interval comparison on
    raster line for badlines that should not have been
    there. Changed some sprite assignments to blocking
    so logic that was split between [1] and [2] could
    be merged into one [1] check. Now EOD and Lunatico
    show sprites properly pretty much everywhere.
    [vicii.v]
2020-07-02 Mistakenly removed line interval compare for badlines
    [vicii.v]
2020-07-03 Should use DEN not allow_bad_lines in border calc
    This fixes lunatico where the moon disappears for several
    frames.
    Remaining known glitches
    1) lunatico : sprite pointer disappears briefly in top left corner
    2) eod : extra black pixel, missing black pixel on flying fist spr crunch screen
    3) eod : dance floor approx 8 pixels miscolored or missing on mid-right
    [vicii.v]
2020-07-05 Different clock configs
    Make clock gens for either external clocks or on board clock on digilent
    Prep for moving some of the top logic out of digilent specific dir
2020-07-05 Adjust ntsc timings after light pen test also fix constants mismatch after prev cl
    [constants.h, top.v, vicii.v]
2020-07-07 Resets everywhere remove ibuf warning
    [dot4x_12_ntsc_clockgen.v, dot4x_12_pal_clockgen.v, dot4x_14_ntsc_clockgen.v, dot4x_17_pal_clockgen.v, vicii.v]
2020-07-07 Put sync and color back to xpos rather than xpos_d Using the delayed xpos here caused a lot of noise Probably was outputting colors during hsync
    [vicii.v]
2020-07-07 Fix typo and bad reset values
    [vicii.v]
2020-07-08 Fix fusesoc build.
2020-07-08 Fix raster line issue
    Raster line increment for raster irq compare is weird
    Increment is done on high cycle 1 for raster line 0 and
    high cycle 1 for every other raster line. This matches
    vice and fixes the thanos intro to comaland. Also
    can remove some exceptions from the simulator checks.
    [constants.h, vicii.v]
2020-07-09 Split db into dbl/dbh, reset reduction, reset notes
    No need to ever assert upper 4 pins of db, so splitting
    db into dbl and dbh like we did with ad
    Reducing resets to only essentials. Otherwise, causes lots
    of routing to reset flip flops everywhere that isn't really
    necessary.
    Need to reset anything that loads into dbi, otherwise
    placement warnings about IOB and connections to flip flops
    with different reset/set signals come up.
    Break out address gen
    [addressgen.v, dot4x_12_ntsc_clockgen.v, dot4x_12_pal_clockgen.v, dot4x_14_ntsc_clockgen.v, dot4x_17_pal_clockgen.v, pixel_sequencer.v, registers.v]
2020-07-10 Fix some visual glitches
    We need to delay xscroll along with pixels/chars
    Added xscroll2 (hyper xscroll test) for visual
    comparison between sim and vice. This fixes the
    gaps that were appearing.
    Delaying ecm also fixes the visual glitch in
    Edge of Disgrace 'dancefloor' where ecm was
    being changed at the end of a line (186 cycle 51 low)
    but was taking effect too early causing wrong
    pixels to show up.
    [pixel_sequencer.v, vicii.v]
2020-07-11 Fix wrap around condition for xpos_d
    Was causing sprite and other x comparisons to fail at
    wrap around points. Oops.
    Fixes amiga pointer disappearance on lunatico
    Fixes sprite wall closing after storm troopers on stat wars.
    [constants.h, top.v, vicii.v]
2020-07-11 Update fusesoc core file for newly broken out modules.
2020-07-14 Fix broken simulator build
    [vicii.v]
2020-07-16 Fix compilation issue with simulator
    [vicii.v]
2020-07-19 Fix lhs glitches due to aec high on matrix fetch
    When ba goes low later than usual and the 3 high aec cycles
    have not yet passed, video matrix fetches can only
    fetch the color lines, the data lines get 0xff. This
    fixes lhs garbage on krestage, edge of disgrace and star wars.
    [bus_access.v, top.v, vicii.v]
2020-07-21 Fix two issues with Uncensored ski hill
    It appears that a higher priority sprite's desire to not
    overwrite pixels takes precedence over a lower priority
    sprite's desire to overwrite a fg pixel. Need more
    testing but this appears to have been the problem with
    Uncensored skil hill color mismatches on the sides.
    Also stole VICE's magic delayed bmm for use in address
    generation. Seems we are supposed to delay bmm falling
    but not rising? Weird.
    [pixel_sequencer.v, vicii.v]
2020-07-24 Fix xscroll glitch
    xscroll delay was off causing glitch on EOD squares disk 1a intro
    switched to VICE logic for border so we can compare
    state at every half cycle and catch any timing issues
    in simulation
    [border.v, constants.h, pixel_sequencer.v, vicii.v]
2020-07-24 Fix mistake with ntsc 14mhz clock gen
    [dot4x_14_ntsc_clockgen.v]
2020-07-25 Add is_pal input pin
    Some prep to make chip type selectable by an input pin.
    Even after this change, the clock still has to be selected
    with the USE_* defines. Later, a clock muxer will be used
    to select a clock based on is_pal.
2020-07-27 Get rid of is_pal
    Need this pin for active HDMI signal. Also need
    to figure out dynamic clock params for is_pal to
    work. Holding off for now.
2020-08-02 Undo extra regs
    Undo vic_write_db change too
    Change white to 666 from 777 due to hdmi issues
    [registers.v, top.v, vicii.v]
2020-08-06 Fix xscroll issue
    Should only catch xscroll on visible cycles.
    This fixes rhs glitch on comaland disk 3 skull img
    [constants.h, pixel_sequencer.v, vicii.v]
2020-08-06 Fix rogue pixel glitch at bottom of Uncensored infinite mirrors
    Code was assuming pixel_color1 was the original stage 1 color
    but it could have been changed to black due to invalid mode.
    [pixel_sequencer.v]
2020-08-13 Use counter to populate char buf instead of shifting
    Makes comparison to VICE much simpler
    Also sprite dma can't enable too late or ba drops much too late
    for sprite 0.
    Also fixed minor timing issue with allow badlines
    [addressgen.v, bus_access.v, sprites.v, vicii.v]
2020-08-18 Fix missing irq state transfer for vice compare
    [constants.h, sprites.v]
2020-08-30 Allow badlines one tick too late
    Caused entering wrong cycle type on badline
    Putting white back to pure white to investigate loss of
    HDMI sync
    Renamed ls245_dir to ls245_data_dir added ls245_data_oe
    but commented
    [top.v, vicii.v]
2020-09-03 Fix sprite to sprite collision issue and border
    Added halt and active bits like vice to the sprite
    shifter. This fixed several rendering issues
    outside the border when sprites got close or over
    their dma cycles.
    Also noborder irq program was not working due
    to using wrong condition for border mask. Should
    have been main_border alone.
    Had to change xpos delays for gfx vs sprites to
    align with vice comparisons. Delayed gfx by
    7 but sprites by 4. Further delayed
    sprites by 3 pixels to align with gfx.
    Still needs testing.
    [constants.h, pixel_sequencer.v, sprites.v, top.v, vicii.v]
2020-09-05 Fix sprite m2d collision bug from previous commit
    Should have used delayed cur sprite pixel for
    m2d collision detection. Last change broke
    lunatico massively interleaved sprite crunch. This
    fixes it.
    [sprites.v]
2020-09-08 Switch some sprite logic to non blocking
2020-09-12 Some clean up to CAS/RAS/MUX
    Real VIC seems to always pulse RAS/CAS even
    on idle cycles. Also, using MUX directly
    in continuous assignment so mux schedule
    changes slightly. The timing between
    CAS RAS and MUX is not right and is still
    causing glitches/crashes probably due to
    setup/hold constraints being violated.
    Latest test with RAS going through bus
    tranceiver but CAS not (to bring timing
    closer to real VIC) helped stability but
    it's still possible we get a crash/hang.
    [addressgen.v, vicii.v]
2020-09-16 Don't reset char buf
    [bus_access.v]
2020-09-18 Use high speed clock for RAS/CAS timing control
    In case RAS/CAS timing is critical around the mux
    drop, going to introduce this higher speed clock
    to get up to 5ns step resolution by using pos/neg
    edge if needed. If timing ends up not being
    so critical, can move this back to using dot4x.
    Also adding the qmtech board.
2020-09-19 More qmtech board stuff
2020-09-26 Undoing the rascas high frequency clock
    Don't need the rascas ~95mhz clock since
    current resolution using 4x dot is good enough.
    Found an issue with address bus switching near
    the start of the phi cycle causing a lot of
    noise on the breadboard prototype. Addressed
    this by making sure there is only one
    transition upon entering the low phase, then
    one more transition at the mux point. (Prior
    to this CL, there was one more unnecessary
    transition esp. during rdram refresh). Had
    to move things like allow_badlines , badlines
    and refc to become valid one cycle earlier.
    This along with making sure mux transitined
    at the same time the address gen changed
    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
    [addressgen.v, clockgen.v, constants.h, cycles.v, dot4x_12_ntsc_clockgen.v, dot4x_12_pal_clockgen.v, dot4x_14_ntsc_clockgen.v, dot4x_17_pal_clockgen.v]
2020-10-01 Clock stuff
    Using one MMCM for two clocks for on-board
    clocks for both cmod and qmtech. Not worth
    extra complexity for more accurate clocks
    for something that will never be used. On
    board clocking gets close enough to required
    color clocks for an image but colors will
    shimmer. Just use as a fallback if no
    external clock is available.
2020-10-01 Flatten/slice two dimensional arrays
    Verilog doesn't support passing two dimensional
    arrays to modules. So we have to flatten
    and then slice the sprite 2d arrays.
    [addressgen.v, bus_access.v, clockgen.v, constants.h, pixel_sequencer.v, registers.v, sprites.v]
2020-10-02 Fix bug with multi color spite to data collisions
    Loos like this was either introduced by accident
    or was always there. Repro with jumpman at
    first level while sitting on ladder.
    [sprites.v]
2020-10-02 Prepping for mojo v3 board
2020-10-05 Remove color clock for mojov3
    Mojo v3 top won't ever need composite. Simplifying
    clock gen by removing color clock.
    [clockgen.v, dot4x_50_ntsc_clockgen.v, dot4x_50_pal_clockgen.v, top.v]
2020-10-06 Fix simulator and put back vborder
    Need vborder for vice comparison in simulator
    Needed to split color.v into color3 and color4
    [border.v, constants.h, pixel_sequencer.v, top.v, vicii.v]
2020-10-06 Wiring update for mojo_v3
2020-10-07 Bringing back separate color clocks for ntsc/pal
    When using the system clock, using a single mmcm
    doesn't work because the clock frequency is not
    accurate enough for composite out. Bringing these
    back. Not really proper since it generates
    synthesis warnings. If composite is going to be
    a thing, it means having accurate external
    color clocks.
    [clockgen.v, dot4x_12_pal_clockgen.v]
2020-10-18 Remove qmtech board
    Not worth maintaining. Same family as cmod.
2020-10-30 More mojo_v3 wiring fixes
2020-10-31 Work to improve stability on mojo_v3 board with PCB
    - since a6/a7 on ROW address doesn't matter, no longer
    setting to 11 to avoid switching noise
    - increase character buffer to 64 to avoid index warning
    - increase vga/hdmi line buffers to 1024 to avoid index warning
    - reduce pure white to reduce loss of sync over HDMI
    - delaying ras/cas/mux by one 4x tick and moved out data/sprite pickup time
    this made things much more stable on demos
    - try using QUIETIO for lines that output to VIC bus
    - make register set edge triggered like reads, this never
    seemed to work before
    - undoing badline and allow bad lines change from earlier CL
    this broke some things and was an effort to avoid an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
    [addressgen.v, bus_access.v, cycles.v, registers.v, vicii.v]
2020-10-31 Update mojo wiring
2020-10-31 Move s-access into sprite.v
    Don't need these extra 8 24 bit registers that were
    only around to keep all bus accesses in one
    module. Not worth it for slightly cleaner code.
    Also fixed issue with rogue pixels not cleared
    from the shifter leaving rogue pixels around.
    [bus_access.v, sprites.v, vicii.v]
2020-11-02 Slightly better wiring for mojo_v3
2020-11-03 Some experimentation to help reduce SSN
    Moved pixel clock to different pin away from data bus bank
    Force red0,green0 and blue0 to LOW with high drive and
    tie those pins to GND. Can help with SSN.
2020-11-06 Timing adjustments
    - back out 2'b11 change to mux for now, just in case
    it causes issues, can put back when core is stable
    - clear pixels_read at cycle 55 just after the point
    where the pixel sequencer grabs the data
    - change all register reads, c,g,s-accesses to happen
    at phi clock edge, this matches the data sheet
    - change ras/cas timing to match more closely to
    datasheet constraints
    - pick up char/pixels so that the first time load_pixels
    goes high it happens when xpos_mod8 == 0
    - latch addr for register reads/writes when RAS falls
    as datasheet says should happen
    [addressgen.v, bus_access.v, pixel_sequencer.v, vicii.v]
2020-11-12 Lots of timing changes
    Lots of changes to transition to picking up data at the
    phi clock edges rather than earlier. This breaks simulation
    checks so that needs to be fixed.
    Simplifying some things. Got rid of some unnecessary
    registers used for delaying pixels.
    Had to make sure gfx pixel data is valid at the same time
    xscroll == 0 (load_pixels rise). Otherwise, xscroll does
    not work properly. Also added xscroll latch and pixel
    latch constants to (sort of) control this.
    This version appears to behave the best on the prototype
    PCB 'hat' using the mojo_v3 board.
    [border.v, bus_access.v, pixel_sequencer.v, registers.v, sprites.v, vicii.v]
2020-11-14 Rework how pixel sequencer works
    Made pixel seuqencer a bit easier to debug
    This restores simulator sync/checks.
    This breaks real hardware build but can now chose
    DAV and other params to make it work for phi edge
    data bus reads.
    Fixed a bug whereby multi colored sprites were
    triggering sprite collisions when they should
    not have been.
    halt bits appear to taking effect a couple pixels
    too early, need to investigate
    [pixel_sequencer.v, registers.v, sprites.v, vicii.v]
2020-11-15 Get simulator + non simulator workin on same schedule
    This gets most simulator checks working again except
    for some 0x1f register mismatches due to the last
    pixel of a cycle bleeding into the start of the high
    phase. That causes the m2d rise to be delayed to
    the next high cycle. Might consider subtracting
    1 from xpos just for simulator to bring it into line.
    It probably won't make a difference for real hardware
    since it happens very early in the high phase and
    any register reads would likely get the correct value
    regardless.
    Also fixed sprite5 to be one pixel for m2m collision
    test.
    This passes xscroll2, eod terminator, eod sprite crunch,
    lunatico misc, and m2m collision tests. As menti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
    [border.v, bus_access.v, pixel_sequencer.v, sprites.v, vicii.v]
2020-11-15 Fix multiple driver issue with last checkin
    [pixel_sequencer.v]
2020-11-15 Fix glitch on RHS during lunatico city pan pic
    No need for border phi checks since xpos is
    enough. Also , change clear pixel logic to land
    exactly where pixels would have been picked
    up on cycle 55 to ensure 0 in non visible region.
    [border.v, bus_access.v, vicii.v]
2020-11-15 Fix sprite collisions on RHS border pixel
    It appears that even though a pixel is rendered as a border
    pixel on the RHS, sprite to data collisions still take
    place there. Lunatico MISC will fail without the
    extra condition placed in this CL to consider a low to high
    transition as capable of triggering sprite collisions while
    still being rendered as a border pixel.
    [sprites.v]
2020-11-17 Fix synthesis error from last commit
    [vicii.v]
2020-11-17 Fix Krestage3 9th sprite issue
    Looks like trying to delay sprite pixels entirely
    within the sprite.v module broke Krestage 9th sprite.
    Going back to xpos shift followed by fewer pixel
    shifts in the module (total is same delay but
    shifting starts at the right time again)
    [sprites.v, vicii.v]
2020-11-18 Need mmc and flip flop update after mmc change
    When sprite mmc changes during expaned sprite rendering,
    there is a quirk to how mmc and mmc flip flops are
    updated. This comes from vice vicii-draw-cycle.x.
    [sprites.v, vicii.v]
2020-11-20 vborder, idle and visible checks were missing
    Need vborder, idle and visible cycle checks in the pixel
    sequencer to match vice logic. This gets all the border
    test programs working.
    [pixel_sequencer.v, vicii.v]
2020-11-21 Add scripts for automated testing
    Use -x arg to auto capture frame from vice prg or snapshots
2020-11-22 Fix border-bm-ysh.prg and border-bm-yhs2.prg
    Fix glitch in lower left corner where border color was
    being overwritten by 0 by char_shifting getting set
    too early after an xscroll change.
    [pixel_sequencer.v]
2020-11-22 Fix spriteenabled* prgs
    Was missing sprite_display_bits logic from VICE
    Sprites were displayed when they shoudl not have
    been. Also, when AEC is still HIGH during a sprite
    fetch cycle, we load 0xff into sprite shifting reg
    [sprites.v]
2020-11-23 Fix allow bad lines not rising when it should
    den01-49-1 was failing because even though the den
    change happened on the last cycle of 48, it wasn't
    triggering allow bad lines because by the time we checked
    line and cycle moved to 49/0. (That's why this test is
    called 49-1 but VICE's indexing starts at 1)
    [vicii.v]
2020-11-29 Fix halt bits
    Since we pushed sprite bis out by 2, we need to
    use a delayed cycle type for the comparisons in
    the stop bits code. This gets sprits rendering
    the same as VICE does when sprite 0 hits location
    (256+)74. Halt can be seen starting at (256+)75.
    Also switch to VICII from VICII_Old tests.
    [sprites.v]
2020-12-05 Rewrite pixel sequencer
    Rewriting the pixel sequencer to be pixel
    perfect match to VICE. Added logging to
    match logging in VICE so we can investigate
    differences in output more easily. Use the same
    pixel value scheme as VICE and add logging that
    matches VICE hooks so we can perform diffs that
    will point to issues.
    [bus_access.v, comp_sync.v, pixel_sequencer.v, vicii.v]
2020-12-16 Fix bug with xscroll and char_shifting
    xscroll was not being delayed properly so changes
    were not landing on the right pixel, smb.vsf showed
    differences in xscroll transitions
    also, pv values were sometimes wrong because
    we had a delayed assignment for char_shifting
    so some values were being incorrectly calculated
    due to wrong condition
    [pixel_sequencer.v]
2020-12-20 Fix stable raster issue
    Fix raster_hold.prg
    Raster interrups should happen on low cycle, not high like vice
    Badlines and allow badlined should be in same block
    Other early dav stuff
    [constants.h, cycles.v, matrix.v, raster.v, registers.v, sprites.v, vicii.v]
2020-12-21 Fix border issue
    Borders were not flipping at the right time
    Instead of changing xpos on the comparison, making this
    equal to VICE but then delaying the outputs before they
    get into the pixel sequencer.
    Also, can get rid of the right border hack in sprites. This
    was the cause.
    Fixes test4.prg and vborder2-36.prg
    [border.v, sprites.v, vicii.v]
2020-12-22 Fix mistake with last border changes
    For some reason, we have to delay on [0]
    for the border values, otherwise, the border
    is shifted one pixel to the left. ???
    [vicii.v]
2020-12-29 Fix internal reset/locked to rst logic
    Was not resetting things as expected.
    [clockgen.v]
2021-01-02 Delay ls245 addr dir change
    CAS doesn't need to go low on a refresh cycle
    Make BA a registered output
    Get rid of some reset logic
    Switch transceiver to output on a delayed aec fall, but still
    switch back to input with aec rise
    Document ras/cas/mux timing
    These changes make things look better on the scope.
    [addressgen.v, vicii.v]
2021-01-10 Remove driving color bit 0 to gnd
    Going back to full 12 bit color after
    noise issue solved. Waiting to see if
    blanking problem is fixed. Also switched
    BA to pin 83.
2021-01-17 Fix lightpen latency
    The latency in the real universe produces the right
    xpos so no need to adjust. Only do it for the simulator.
    [lightpen.v]
2021-01-19 Increase vga output to 1008x624 @ 8x dot clock
    Need to do this to be able to output 80 column mode.
    cmod no longer functional since clock gen was not updated for 8x
    Added test program to enable 80 columns
    [clockgen.v, constants.h, hires_vga_sync.v, top.v, vicii.v]
2021-01-20 Add index to mem registers
    This will make simulating indirect indexing easier.
    Something like
    LDA($fc),y
    can be replaced with
    STY VIDMEM_1_IDX
    LDA VIDMEM_1_VAL
    Provided mem ptrs are set properly
    [registers.v]
2021-01-21 Update to hires80.asm
    This works for the most part but trying to use
    vmem registers in basic still has holes.
2021-01-23 Fix messed up ntsc dot clock gen
    [dot4x_50_ntsc_clockgen.v]
2021-01-24 Going back to dot4x from sysclock
    Back to one clock output from CMT
    But using another one to generate the dot8x
    This would not be necessary on real hardware
    with a proper color clock. But we have a 50mhz
    clock with too little accuracy and the difference
    in dot4x causes crashes. Generating dot8x
    from dot4x requires a special constriant flag
    to allow this as it is considered bad design
    practice.
    [clockgen.v, dot4x_50_ntsc_clockgen.v, dot4x_50_pal_clockgen.v, hires_addressgen.v, hires_vga_sync.v, raster.v, vicii.v]
2021-01-24 Final delay of main border to last stage was incorrect
    The main border was used in the third stage
    but it was using the one from the 1st. Should have
    been using a delayed version from the 2nd. This
    was causing half a pixel misalignment of the border
    after we switched to a high res output.
    [pixel_sequencer.v]
2021-01-24 Fix CSEL=FALSE misalignment
    Timing of border when CSEL=FALSE was not
    correct. Was shifted right by a whole pixel.
    This fixes the RHS glitches on krestage and
    uncensored rotating color bars sequence.
    [border.v]
2021-01-24 Really fix half pixel border issue
    After moving to dot8x and double the native
    resolution in the X direction, it no longer
    made sense to split the work to produce a pixel
    into 3 stages. This consolidates 2 and 3 into
    a final 2nd stage. This solves the half pixel
    border issue (for real this time).
    TEST: At boot screen, LHS Full cursor should be
    flush with LHS border. One full native pixel
    buffer on left of chars. On RHS, Z char should
    have 1 full native pizel on right. Full cursor
    should be flush with RHS border too.
    TEST2:
    POKE 53270,PEEK(53270)ANDNOT8
    LHS cursor should show ONE pixel peeking through from
    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
    [pixel_sequencer.v]
2021-01-24 Fix sprite to data collision issue
    The border should not influence whether
    sprite to data collisions happen. If CSEL is
    off, sprite to data collisions should still happen
    underneath the extended border. This was breaking
    lunatico. There should be no need to check border
    because it should be impossible for pixels to be
    set outside the visible range.
    [pixel_sequencer.v, sprites.v, vicii.v]
2021-01-25 Remove unnecessary BUFG's
    Also removing
    PIN "mojo_clockgen/dot4x_50_clockgen/clkout1_buf.O" CLOCK_DEDICATED_ROUTE = FALSE;
    from top.ucf
    Keeping an eye on glitches due to what I think is dot8x dot4x domain
    crossing issue.
    [dot4x_50_ntsc_clockgen.v, dot4x_50_pal_clockgen.v, pixel_sequencer.v]
2021-01-28 Switch to new prototype board wiring
    New wiring for 2nd version of prototype board.
    No addr oe pin any more.
2021-01-28 Update to sumualtor version of top after wiring switch
2021-01-29 Add grogu sample 320x200 pic
2021-01-30 Use BUFGMUX to switch ntsc/pal
    Use the lower bit of chip input to select either ntsc
    or pal. Routability of this moving forward is suspect but
    this seems to work.
    Also fixed a mistake in the loader. Cases were wrong for
    the chip types and case 0: was missing entirely.
    [clockgen.v, comp_sync.v, constants.h, registers.v, top.v, vicii.v]
2021-02-01 Add grogu sample 320x200 hires 16 color mode
2021-02-01 Move deactivate extra regs bit
    Moving this to bit 8 because having it at bit 5
    was preventing code that wanted to enable extra
    regs from being re-entrant. It would end up
    deactivating extra regs on the 2nd attempt. Since
    all activation chars are < 128, it should not
    conflict now.
    [registers.v]
2021-02-03 PAL / NTSC clocks were backwards, use one PLL
    Turns out I had PAL and NTSC clocks backwards in
    the BUFGMUX (oops). Didn't notice all this time
    until I tried to run Uncensored. This CL brings
    both clock gens under 1 PLL and also generates
    a 25Mhz clock to be used for serial clock (since
    there was a warning about sys clock driving multiple
    loads). 25Mhz was chosen because the clock divider
    was set to 2. The clocks here are close and seem
    to be good enough for both pal and ntsc. Can
    use external oscillators later if needed.
    [clockgen.v, dot4x_50_pal_clockgen.v, registers.v, top.v]
2021-02-07 Set rw output to low
    Forgot to configure this pin. Experimental setting
    rw line to low from VIC (not possible from real VIC)
    Might experiment with using idle cycles to do
    something useful.
2021-02-10 Be a little more verbose with chip switches on serial out
2021-02-11 Use dynamically configured PLL
    This change brings in a dynamically configured PLL
    that will switch divide/multiply values depending
    on whether the chip is ntsc or pal.
    This seems to have introduced a routing problem.
    The DCLK input of the PLL_ADV is fed from the
    BUFG_CLKIN in the dot4x_50_clockgen.v module
    but it seems it is not optimally placed. This
    might be okay for the prototype board but
    the clock pin may have to move to avoid this
    issue.
    [clockgen.v, pll_drp.v, pll_drp_func.h, top.v]
2021-02-16 Add blink, reverse, underline and alt char bits for 80 column mode
    These bits match C128's VDC
    [hires_addressgen.v, hires_matrix.v, hires_pixel_sequencer.v, hires_vga_sync.v, raster.v, top.v, vicii.v]
2021-02-17 Cut blink rate in half
    Was too slow
    [hires_pixel_sequencer.v, raster.v, vicii.v]
2021-03-03 Add DVI support
    Guarded with WITH_DVI define
    Also changed mult/divide for NTSC clock to get a slightly
    more accurate clock.
    Added top_dvi.ucf only for testing DVI output using MojoV3
    Removing old vga_sync since we don't need it any more. The
    new hires version can do everything it used to do.
    Changed gen constraints tool to allow io standard too.
    Verified DVI output worked (noisy but worked) using the clock
    and blue channels from the MojoV3.
    Also added timing exceptions to not warn about domain crossing
    issuei for the serial data coming off dot4x but transmitted over
    sys_clock. It should not be an issue with the double flip flops
    grabbing the data.
    Also removed another CDC issue by no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
    [clockgen.v, convert_30to15_fifo.v, dvi_encoder_top.v, encode.v, registers.v, serdes_n_to_1.v, top.v]
2021-03-03 Scale 4 bit RGB to 8-bit RGB for DVI output
    Otherwise, image looks dark. For final board,
    this will be 6-bit to 8-bit scale.
2021-03-04 Bump colors from 12-bit to 18-bit
    This CL increases the color space to
    6 bits per RGB channel. This will
    make any software that sets the palette
    look dark since prior to this cl only
    the lowest 4 bits were considered.
    Changes are still necessary to update
    the simulator. Smoke test of
    uncensored passed and ntsc/pal switch
    was okay.
    The 'new' upper bits have been routed
    to unused pins on the mojov3/hat combo
    and are not accessible unless the pins
    are either bent or some wires soldered
    on the top somehow. But HDMI and
    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
    [colorreg.v, registers.v, top.v, vicii.v]
2021-03-07 First crack at using color clocks
    This change makes it possible to use external
    4x color clock oscillators instead of relying on the
    50mhz clock to generate dot4x clocks. This is not
    only more accurate but also seems to fix some
    routing/placement issues caused by the dynamically
    configured pll. Instead of reconfiguring the PLL,
    we can select one of the clocks using a BUGFMUX,
    then use a single PLL to mult/div for both ntsc/pal,
    then select which one of the output clocks should be
    used with another BUFGMUX. Seems to be a cleaner solution
    and also makes composite output possible now. Needs testing.
    Also trying to keep 'non color clock' boards
    working.
    [clockgen.v, top.v, vicii.v]
2021-03-26 First attempt at luma/chroma generation
    This adds luma/chroma generation to the core. Only NTSC
    works for now. Colors are a little off. Need to adjust
    phases and amplitudes. Luma voltages are a bit higher
    than targets too. This needs two 6 bit DACs to work.
    3.3v for chroma seems to be okay but we need 5V level
    shifter for luma to reach target values.
2021-03-27 Improve chroma signal generation
    Fixed a problem whereby we were using chroma9 value
    out of ROM two cycles out of sync with the amplitude
    that was used to determine it. This was generating
    0 output levels between burst/active regions.
    [comp_sync.v, testpattern.v, vicii.v]
2021-03-28 Fix test pattern
    Grey color was wrong in palette causing mismatch in color
    index in test pattern data.
    Also swapping color wheel diagram for correct one for NTSC
    Burst phase should be 180 degrees (which means all our angles
    are wrong and have to be redone)
    [top.v]
2021-03-28 Fix NTSC burst phase and implement PAL
    NTSC burst phase should have been 180 degrees
    Adding PAL support by alternating burst phase
    between 135 and -135 degrees between lines. Also
    Fixing NTSC phase also brought phase angles
    back to what they should be.
    [comp_sync.v]
2021-03-29 Just doc and typo fixes
    [comp_sync.v, testpattern.v, top.v]
2021-03-30 Optionally average luma over 4 ticks
    Smooth transitions between luma levels
    by averaging over 4 ticks of one pixel.
    Blanking level was not set correctly.
    [comp_sync.v]
2021-03-30 Make luma,phase,amp,blankinglevel,burstamp configurable
    This adds optional code to make luma, phase, amplitude,
    blanking level and burst amplitude configurable via
    registers. Going to use this to match voltage levels
    seen on the scope in a convenient way. Probably will
    remove once values are set correctly.
    [comp_sync.v, registers.v, vicii.v]
2021-03-30 Fix error with blanking level width
    Should have been 6 bits, not 8
    [comp_sync.v, registers.v, vicii.v]
2021-04-02 Fix setup timing violation in comp_sync
    Need to handle clock domain crossing for signals
    used in the clk_col16 process block. This fixes
    the setup timing problems reported in ISE when
    configurable lumas is not enabled. There are still
    problems with configurable lumas enabled but this
    likely won't be in the final release and is only
    for fine tuning so not going to fix it just yet.
    Also one of the amplitude registers had a range
    off by 1.
    [comp_sync.v]
2021-04-05 Fix setup timing issue when configurable lumas enabled
    Some regs needed clock domain crossing strategy to deal
    with timing warnings.
    [comp_sync.v]
2021-04-07 Get rid of is15khz and raster lines
    Stop using MCU pins for settings and use
    serial link. Goes with updated MCU loader
    that will restore settings over serial.
    Also fixed configurable lumas clock domain
    crossing issue and added register reads.
    [registers.v, top.v, vicii.v]
2021-04-12 Add rev1 top.v and wiring
    Pin assignments for rev1 board.
    Added flags to turn conditionally remove or add
    pins that are different from mojo.
2021-04-15 Cleanup novaterm driver src
2021-04-15 Switch over to new sine tables
    Also remove top.ucf since it is
    generated.
2021-04-16 Fix simulator build
    Replacing IS_SIMULATOR with SIMULATOR_BOARD and treating it
    as another board type.
    Cleaned up cmod_a36t/top.v to be the simulator top. Need to
    rename the dir.
    Other cleanup in files now that there is a dedicated sim top,
    the other top files don't have to check.
    Some verilator lint on/off comments too.
    [colorreg.v, comp_sync.v, lightpen.v, registers.v, top.v, vicii.v, videoram.v]
2021-04-16 Fix typo causing build error in ISE
    Check in common.vh settings for mojo board.
    [top.v]
2021-04-16 Fail on simulator build if no simulator board defined
    [top.v]
2021-04-21 Fix bugs with config programs
    [menu.c]
2021-04-24 Add persist flag and make serial conditional
    Bit 7 of video mem flags will indicate whether
    pokes to overlay regs should be persisted back
    to MCU via serial. Also made serial link conditional
    compile since revB board will not have it.
2021-04-24 Restore luma/phase/amplitude/black/burst
    Restore this after load, but only if we have
    the magic bytes at 0x100 stored. If 're' cmd
    comes in, then we store magic bytes. This
    makes sure a fresh loader doesn't write
    garbage to a device that has not been
    initialized.
2021-04-25 Replace 15khz with native_y
    Also add native_x register.
    Discovered we need an additional read cycle for color
    and luma regs (where we pack values into a wide bit
    block ram register). Otherwise, we got garbage when
    we put back bits we thought we read previously.
    Also added persistence bit for CPU to tell fpga when
    it should save back registers to the MCU EEPROM.
    Next CL to update loader is required to go with these
    changes.
    Still have an issue with config programs where they
    POKE changes to any register too fast. The serial tx
    line must be going high too early before busy goes
    back low. So need to wire busy through so CPU can
    see it and poll for a safe way to change registers
    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
    [hires_vga_sync.v, lumareg.v, registers.v, vicii.v]
2021-04-25 Get rid of VIDEO_FREQ register
    Move native_x and native_y (previously 15khz) into
    display regs. Also add 'load', 'dx', 'nx' commands.
    Also some cleanup to restore settings cleanly. Added
    magic bytes so we don't pump garbage into a fresh
    load before a reset happened. Is there a way to
    pre-fill EEPROM?
2021-04-25 Fixing various issues after last round of changes
    Simulator compile was busted
    Wrong size data for luma (got rid of palette select bit)
    [registers.v, top.v]
2021-04-27 Add configurable timing registers for hdmi/vga
    Guarded by compile flag CONFIGURABLE_TIMING. Not meant
    for final product. Only as tool to find good timing
    params.
    Also fixed bug with pal not detected properly in cycles.v
    Also fixed bug with composite pal where 180 degree phase was not alternating
    on the right lines. Turns out the odd line must get the 180 degree shift
    otherwise the whole color wheel is flipped vertically.
    [comp_sync.v, cycles.v, hires_vga_sync.v, kawari.h, menu.c, registers.v, vicii.v]
2021-04-27 Add NEED_RGB and GEN_RGB config
    Also fixed a bunch of issues with other defines
    not in the right spots or missing signals with
    some combinations. Added separate config.vh to
    control config more easily from simulator build
    script that will go through permuations to make
    sure things still work.
    [comp_sync.v, hires_vga_sync.v, registers.v, top.v, vicii.v]
2021-04-28 Fix issue with wrong size on register assignment
    Add hires config to gen_config and make sure it is
    tested.
    [registers.v]
2021-04-29 Swap src/dst registers for copy
    Makes more sense to keep A port for dst always.
    [registers.v]
2021-04-29 Update 80 column driver with acceleration routines
    Using the block copy/fill hardware routines to perform
    clear and scroll functions. Speeds up clear and scroll
    considerably in 80 column mode.
2021-04-29 Add CSYNC flag
    When enabled, use HSYNC pin as CSYNC and keep
    VSYNC low.
2021-04-29 Fix backwards csync
    Need AND not or.
    [hires_vga_sync.v]
2021-04-30 Upgrade novaterm driver to use hw accelerated block copy/fill
2021-05-01 Fix timing editor after last round of refactoring for timing
    [menu.c]
2021-05-02 Mistake on vpolarity init
    Should be initialized to 0 not 1
    [registers.v]
2021-05-02 Fix vsync range check
    Need to have special cases for first and last v active and v sync
    lines, otherwise we signal sync or active too early on the first
    line and too late on the last line.
    [hires_vga_sync.v]
2021-05-02 Add native resolution support to sim and fix v/h sync
    When no rgb is available, use the pixel_color3 value
    to lookup colors. This is the case when composite only is
    available.
    Also switching composite sync module to use raster_x rather
    than xpos and fixing the hsync/vsync ranges like we did in
    the vga sync module. The durations after hsync start are
    fixed but its location can be adjusted with the very first
    offset after hvisible start. (Need to make it configurable)
    [comp_sync.v, vicii.v]
2021-05-03 Add video standard switch to wiring and rev1 top.v
    Adding P67 as a physical switch to toggle the video
    standard. Optional.
    Also fixed an issue with common not setting a define
    properly for the rev1 board.
    [top.v]
2021-05-21 Fix TMDS wiring for DVI out on rev_1
2021-05-23 Switch between two persistence methods
    Brought init sequence code down into registers_mcu_eeprom,
    register_eeprom and register_no_eeprom to support different ways of
    persisting and restoring settings (or not at all)
    These includes are responsible for bringing the system out of reset
    after restoring all registers that can be saved (colors, chip, raster
    lines, etc)
    Also, sys_clock is no longer required if there is no MCU+SERIAL
    So the board can operate on just two color clocks with eeprom now.
    chip_ext now represents lines from MCU indicating chip selected
    This is not passed directly to vicii anymore, but instead will get
    picked up by the init code and exported as chip. This is to be
    consi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
    [clockgen.v, constants.h, registers.v, top.v, vicii.v]
2021-05-23 Switch to rev_1 board
    Mojo_v3 is dead
2021-05-23 Reset detection should be ~rst
    [registers.v]
2021-06-07 Some refactoring for how reset works
    Need to make a reset handler task because it
    must be called inside and outside the reset block
    of the large registers process block. This is
    because it has to not only take us out of reset,
    but also set registers from restored settings
    after we're out of reset.
    [registers.v]
2021-06-09 rev2 bringup
    Establish wiring for rev2 board. Add some notes on
    how to program flash.
    Got rid of REV1 or SIMULATOR define.
2021-06-10 Make config utils init eeprom
    Config utils should be able to detect when
    the eeprom is not initialize and give the
    option to init before entering the main
    menu. Will init with good known defaults
    before proceeding.
    Also changed MCU loader to use slower
    but compatible flash method of byte by byte.
    The replacement chip is not compatible with
    the faster method.
    Untested
    [init.c, init.h, main.c, menu.c, util.c, util.h]
2021-06-11 Fix issues with EEPROM read/write
    Need a warm up cycle for READ otherwise we
    fail to read the very first register. So
    we cycle through all 256 without any operations
    to make sure EEPROM is ready before we start
    talking to it.
    Also fixed some other issues. CS_FLASH
    needs to be HIGH. Also, some issues with WRITE
    state.
    [top.v]
2021-06-11 Fix issues with config saving regs
    [init.c, main.c, menu.c, util.c, util.h]
2021-06-11 Do video standard switch smarter
2021-06-11 Set magic bytes from arduino loader
2021-06-12 Fix clock domain crossing issues
    These were causing timing constraint violations
    [comp_sync.v, top.v]
2021-06-12 Fix mistake with crc for burst_start16
    Caused black and white pic
    [comp_sync.v]
2021-06-13 Handle hires reset and cfg_reset
    When CPU reset is detected, reset the VIC so
    hires registers will get reset too.
    When cfg_reset is detected, write a 0 to 0xfc
    so device has no magic anymore. Next reboot
    will restore defaults.
    [registers.v, top.v, vicii.v]
2021-06-13 Fix simulator breakage
    Need to use HAVE_EEPROM for cfg_reset
    [registers.v, top.v, vicii.v]
2021-06-19 Allow std switch before eeprom init
    You ought to be able to use the external switch to
    determine what video standard you want even before
    the eeprom is initialized. So init chip to be
    {1'b0,~sw_standard}.
2021-06-19 Fix synthesis error on last commit
    [registers.v]
2021-06-21 Fix bad black luma level
    [registers.v]
2021-06-24 Switch ISE project to rev_2
2021-06-24 Fix mistake with flash_cs being passed to vicii module
    Premature. Have not checked in flash_cs handling yet.
    [top.v]
2021-06-28 Add rev_3 top and wiring
    For X16 version. Hopefully last one.
2021-06-29 Expose switch state in a register
    So config program can tell user what the current state
    is whether the next boot will invert it.
2021-06-30 Detect external switch in config prg
    Show user state of switch.
2021-07-05 Handle failure cases for flash program
    [menu.c]
2021-07-08 Fix swith monitoring from config
    [menu.c, util.c, util.h]
2021-07-08 Fix wrong flash_begin name causing build error
    [registers.v]
2021-07-08 Add lock bits
    Add lock bits to control access to flash/eeprom/persistence and
    extension registers. This will by default prevent a mallicious
    program from bricking the device and requires the user to
    intentionally short the spi lock pins in order to update the
    device. Also, they can physically prevent programs from
    overwriting their preferences. Also, they can turn kawari into
    a normal 6567/6569 by disabling extensions all together.
    Document SPI_REG
    [registers.v, top.v, vicii.v]
2021-07-08 Update flash program after spi regs changed
2021-07-09 Fix build issue with rev2/rev3 top.v Also adjust some config docs
    [top.v]
2021-07-09 Invert lock pins
    Invert the lock pins so we can have jumpers in place in
    all 3 slots and that will be the default config.
    [registers.v]
2021-07-10 Prevent user from changing stuff that is locked
    [kawari.h, menu.c, util.c, util.h]
2021-07-10 Fix build issue with rev2/rev3 top
    [top.v]
2021-07-11 Makefile to create multiboot image
    Makes an mcs file for spi programming that has
    a golden and multiboot image. Golden has the
    multiboot header and programs at SPIx4
2021-07-11 Fix flash bug
    Was not copy full 16k to vmem ram
    [menu.c]
2021-07-14 Impl 6569r1 lightpen bug
    [lightpen.v, raster.v, vicii.v]
2021-07-15 Implement the 6569r1 bug properly
    Previous change did not do it right. boxcheck now
    detects 6569r1 or 6569 properly. Also tested light
    pen with GEOS and it works on all four chips.
    [lightpen.v]
2021-07-15 Get sprites to shine through to hires modes
    Hacky way to get sprites to show up on hires modes.
    Sprite x position will be 1/2 pixel shifted due to
    the way hires works but this at least gets them
    visible. The sprites will show according to lowres
    mode rules. Background collisions happen according
    to lowres data. Sprite to sprite collisions and
    transparency should work.
    [hires_pixel_sequencer.v, pixel_sequencer.v, vicii.v]
2021-07-17 Remove HAVE_COLOR_CLOCKS, HAVE_SYS_CLOCK, HAVE_MCU_EEPROM
    Rev_1 and mojo_v3 are dead. We work exclusively off color
    clocks now and have no MCU for the final board. So there
    is no need for these as they are just clutter. The
    dynamic PLL config code is also removed. This simplifies
    the code a bit.
2021-07-23 Fix eeprom behavior
    Use full 1024 bytes of EEPROM to save 4 sets of register values
    for each of the chips we emulate. EEPROM read and write
    changed to use an eeprom_bank register which selects the
    bank. The bank will be set to the chip at startup. Bank
    0 is always read first until chip is read. Then the bank
    switches to that chip. So all registers below chip will
    be cross-chip registers while everything above is per-chip.
    Had to move colors to 0x40. Also moved magic bytes to 0x00
    to avoid the weird offset at the start.
    [init.c, kawari.h, menu.c, registers.v, util.c]
2021-07-29 Add quick switch program
2021-07-29 Some minor fixes for config
    [menu.c]
2021-07-31 Add test case
2021-08-01 Restore previous colors in novaterm driver
    Save colors coming into driver and restore them
    on exit.
2021-08-01 Fix PAL luma on white
    Needs to be < 64, was showing up as black
    [init.c]
2021-08-06 Switch to community colors as default RGB palette
2021-08-12 Fix demo switch and lock bit RT feedback
    [menu.c, util.c, util.h]
2021-08-21 Add HIRES_RESET config option
    If the reset line goes haywire, this will be needed to keep
    the board working in hires modes.
    [registers.v]
2021-08-22 Better way to get sprites to show up on hires modes
    This also gets background collisions working.
    But some sprite modes will likely not work as expected.
    However, this is good enough.
    [hires_pixel_sequencer.v, pixel_sequencer.v, sprites.v, vicii.v]
2021-08-25 Better scanlines logic
    Prev logic would show a band on NTSC modes at line 0. This
    uses active region to invert the ff on each line so we
    never get a band.
    [hires_vga_sync.v]
2021-08-27 Better hires reset logic
    When hires mode active, soft reset was not always resetting
    properly. This fixes it.
    [registers.v]
2021-08-29 Fix errata by emulamers demo part 3
    This fixes part 3 of errata by emulamers. The VIC
    apparently shifts data off the bus into the sprite
    registers even when there is no dma enabled.
    [sprites.v]
2021-08-31 Cleanup simulator cycle by cycle stepping print outs
2021-09-03 Handle high aec sprite dma differently
    Remember last bus like VICE does.
2021-09-05 Implement 6569 post CAS bbm transition glitch
    See addressgen.v for a full description.
    Simulator also fixed to match VICE but I
    think VICE gets the address wrong.
    [addressgen.v, constants.h, vicii.v]
2021-09-07 Fix bmm fetch glitch
    Turns out that the address glitch that affects ROM
    can't happen too soon after CAS because that signal
    is delayed to RAM. So that moved out a couple ticks.
    Also, making the first address match VICE instead of
    doing what I 'think' the chip should do. Assuming
    VICE is always right. So removing the vicaddr_sim
    hack.
    [addressgen.v, constants.h, vicii.v]
2021-09-08 Use QS for quick switch program name
    Also fix menu items not mathing actual chips.
2021-09-17 Fix bug with eeprom verify check
    Also remove old OVERFLOW and UNDERFLOW flag refs
    causing math test build to fail.
    [menu.c]
2021-09-17 Reset extra regs only if extra regs are enabled
    We should reset things even in lo res so the
    condition was wrong.
    [registers.v]
2021-09-17 Also check eeprom busy before resetting extra regs
    [registers.v]
2021-09-22 Add eeprom commands to set / get serial
    Use ID page to lock serial number on eeprom.
    Also fix config to show switch change
    [menu.c]
2021-09-23 Add verify to flash util
    Needed to move flash tmp space to x5000 so it
    didn't corrupt the heap.
    [menu.c]
2021-09-24 Place another activation sequence in front of spi reg
2021-09-28 Fix output formatting on eepromed
    [menu.c]
2021-10-03 Fix major flash bug
    Can't erase on 64k page boundary with the multiboot start
    address we chose (512000). Fortunately, this is divisible
    by 4k so we can just switch to 4k page erase. Before this
    fix, flash was clobbering a significant chunk of the
    golden boot image. So the device was being bricked.
    [menu.c]
2021-10-11 Adjust CAS falltime and slew/drive strength
    Some boards were displaying Out of Memory. This CL
    delays CAS by approx 15ns and changes the slew/drive
    strength of CAS,RAS,AEC,PHI and BA to SLOW/4 from
    QUIETIO/2 for a slightly better defined signal.
    Also, CAS should always pulse low even during
    refresh cycles. It could confuse other hardware.
2021-10-17 Add luma_sink feature
    S/LUM signal was not done correctly on rev_3 board.
    rev_4 will use a 74LS06D to sink current. luma_sink
    pin also added to sink all current. Still have 6 bits
    for luma levels this way and there was a free pin
    on the 74LS06D already on the board.
    Get rid of AVERAGE_LUMAS
    [comp_sync.v, top.v, vicii.v]
2021-10-18 Wrong luma sink pin
2021-10-18 Fix bad wiring line
2021-10-29 Remove one time guards for non-extension regs
    This refactors registers.v a bit to no longer
    have a one-time-only read/write guard on all
    the registers. This was incompatible with
    beamracer. Also, reorged the way we check for
    extended reg activated to save some space on
    the fpga.
    Tested uncensored, errata and test programs.
    [registers.v]
2021-11-27 Back out CAS timing change
    This timing adjustment was causing some
    wierdness to show up on the oscilloscope.
    The address lines were showing some
    noise after AEC fell. No idea why. Moving
    this back to how it was before.
    [addressgen.v, vicii.v]
2021-12-03 Wiring for REV_4S board
    No mux on REV_4S so needed some work to GenConstraints
    to account for this.
    Also flash_d1 and flash_d2 are not necessary unless WITH_SPI
    is enabled.
2021-12-03 Fix broken auto inc block
    Was always executing this logic when it
    should not have been.w
    [registers.v]
2021-12-04 Exclude flash_d1/flash_d2 if no spi
    Must match vicii.v expectations
2021-12-04 Fix CAS fall time issues
    This puts CAS fall back to where it was before
    we backed out the previous attempt to move CAS
    out by ~15ns. This keeps CAS rise on the positive
    edge and fall on the negative edge. See
    addressgen.v for more info.
    [addressgen.v, vicii.v]
2021-12-09 Fix black and white boot issue and math s_div
    Split the x2 clock gen module into two DCMs
    each x2. This seems to have fixed the b/w issue
    (however, it may have been a clock domain crossing
    issue all along that was also addressed). Also
    fixed wrong register used in math coprocessor
    signed division result.
    [comp_sync.v, dvi_clockgen.v, registers.v, top.v]
2021-12-10 Fix EEPROM / FLASH bug?
    This *may* fix the eeprom/flash bug. I suspect
    the setup time for the spi_d line was not being
    met. This delays the clock so that we prep the
    data line about 30ns before the clock edge of
    either the flash chip clock or eeprom chip clock
    signals.
    Also fixed versioning problem with Makefile.inc
    Was copying over version we set with perl.
    [registers.v]
2021-12-11 Indicate config reset with white screen
    [registers.v]
2021-12-12 Fix issue brought in by commit #7e8a6abb61bdae4
    Lunatico Disk Side 2 Rain Sequence was failing
    Bisected to this commit
    [registers.v]
2021-12-13 Formatting fix
    Util version bump to 1.1
    [menu.c, util.h]
2021-12-17 Add enable/disable fast loader
    Also add reset. No point in returning to BASIC if
    you can't run again.
    Added some missing constants to kawari.h
    [kawari.h, menu.c]
2021-12-21 Add flash and eeprom pins to wiring
2021-12-21 Fix bad wiring job on last CL
2021-12-21 Fix packed pixel misalignment issue
    hires_ff was flipping and flopping before reset was
    lifted and depending on the lift point, it was not
    aligned correctly which caused hires packed pixel
    format to not get interpreted correctly. Noticed this
    after a build with no eeprom which happened to change
    the reset lift point.
    [hires_pixel_sequencer.v, vicii.v]
2021-12-23 Should not try to set chip from eeprom if no mux available
    If there is no clock mux on the board, we should not
    try to restore the chip model from eeprom data. The switch
    should be used only to set NTSC or PAL operation.
2021-12-24 Check variant before flash
    If variant doesn't match, give a warning.
    This will prevent people from flashing the wrong
    image to their board if they download the wrong
    file.
    [init.c, kawari.h, menu.c, util.c, util.h]
2021-12-24 Add variants and do new lumas for new boards
2021-12-24 Init with new lumas for new boards
2021-12-26 Support optional oscillators on 4S board
    [top.v]
2021-12-27 Lots of build changes
    Handle clock mux vs no clock mux variants
    Fix a bunch of build issues
    [top.v]
2021-12-27 Fix wiring for 4L board
2021-12-28 cfg_reset pin was missing from wiring for SB
2022-01-21 Add DMA feature
    Allows high speed copy from VMEM to DRAM or DRAM to VMEM
    Uses idle gfx fetches or idle cycles to perform the work.
2022-01-21 Document DMA functions
2022-01-21 Add DMA test case
2022-01-25 Prep for alternate fpga
    Removed endmodule tag name since it is only system verilog that supports it.
    Renamed some files from .v to .vi
    Also fixed wrong video standard switch setting in
    registers_no_eeprom.vi
    [bus_access.v, clockgen.v, comp_sync.v, convert_30to15_fifo.v, cycles.v, dvi_encoder_top.v, encode.v, hires_matrix.v]
2022-01-26 Workaround for Efinix EFX_DPRAM_5K issue
    See top of file for issue and solution
    [videoram_efinix.v]
2022-01-26 A few fixes to Efinix video ram
    [videoram_efinix.v]
2022-01-31 Updates for Efinix Trion
    Add DVI encoder/serializer modules
2022-02-01 Fix Efinity output enable issue
    There is one output enable signal for each
    pin of the bus. Not one for all like I had
    before.
    [top.v]
2022-02-01 Fix std switch toggle issue on uninitialized dev
    If the device (with eeprom) was not initizlied, the
    std switch was not flipping the video standard.
    Added a check to make sure if there was no magic
    found, we still set the chip.
    Also fixed wrong eeprom bank init error.
2022-02-01 Fix sim build issue and add DVI encoder
    [top.v]
2022-02-07 Fix flash for W25Q32 devices
    [kawari.h, menu.c]
2022-02-07 Fix external RGB clock not dividing properly
    We we always emitting the dot4x clock even when
    native x and/or y were set. This CL makes sure
    the clock gets divided to the right frequency
    depending on native x/y settings.
    [hires_vga_sync.v, top.v, vicii.v]
2022-02-07 Omit analog rgb clock signal unless requested
    The analog rgb clock signal is not really needed
    for either VGA or other analog RGB monitors. Turn
    this off unless it is enabled via WITH_RGB_CLOCK
    feature flag. This will save on some unnecessary
    switching noise.
    [hires_vga_sync.v, top.v, vicii.v]
2022-02-15 Eeprom bank was not set for no_eeprom case
    Also was wrong value in case board was not initialized.
2022-02-18 Give warning on EEPROMED if SPI lock enabled
2022-02-21 Need guard around cpu_reset_i
    Not all boards will use this so it must
    be guarded with conditional. Also fixed
    typo with MUX hack in 4G.
    [registers.v, top.v, vicii.v]
2022-03-01 Prep 4H
    Get wiring correct
    Use 4k for EEPROM flash mem
    Reduce to just a vic, no extras except ability to flash
    [top.v, videoram_efinix_4k.v]
2022-04-10 First iteration of demo disk
    [c64.cfg]
2022-04-21 Wrong pin for luma sink on 4H
    Also get rid of unnecessary DVI related stuff (clock, etc)
    for 4H
    [top.v, videoram_efinix_4k.v]
2022-04-23 Fix chip mux for efinix
    [top.v]
2022-04-25 Fix sprite issues on Efinix Trion
    It looks like having a blocking assignment in
    one process block and having another process block
    'pick up' that value is not well defined in verilog.
    On Xilinx, the delay pipeline we had would
    consistently work as expected (and in verilator too)
    but on Efinix it would sometimes 'see' the result
    of the blocking assignment a whole pixel early,
    resulting in 'missing' pixels in the pixel sequencer.
    Moving the delay pipeline into the same process block
    that makes the blocking assignments (i.e.
    sprite_cur_pixel1 and active_sprite) fixed the issue.
    [sprites.v]
2022-04-25 Fix ram register size mismatch for 4k ram
    Fix config test issue with configurable lumas
    Also add another config test for 4k
    Fixed mistake with with_ram triggering with_math instead of with_ram define
    [comp_sync.v, registers.v]
2022-04-25 Hack to fix Efinix vs Xilinx difference
    See notes about Efinix/Xilinx behavior
    re: blocking assignments.
    [sprites.v]
2022-04-25 Final version of sprites for both Xilinx and Efinix
    Fixed dumb mistake
    [sprites.v]
2022-04-26 Fix expert compile Fix unrecognized board error (had 4 in the variant but was removed) Add color utils
    [color.c, color.h, init.c, init.h, util.c, util.h]
2022-04-28 Repo cleanup
    Add missing files
    [data.c, data.h, multi_hex_to_bit.c]
2022-05-09 Switch feature demo music
    Demo music was being overwriten by cc65 segments
    Not sure why or how but made demo music smaller
    to avoid the collision
2022-05-26 Simplify blitter a bit and fix a bug
    Fixed bug with last byte not necessarily being filled
    before having written all width pixels. Also simplified
    the state machine and reduced number of ticks to blit
    a single pixel for slightly higher bandwidth. Also
    byte index counters should be at least 9 bits because
    2 pixels per byte = 2 * 512 = 1024 which is our max
    width.
    [registers.v]
2022-06-01 Change raster op and flags into one register
    Also fixed possible issue with background pixels
    and 320x200 mode.
    [hires_pixel_sequencer.v, registers.v]
2022-06-28 Fix Final Cartridge III issues on Efinix
    Change address bus direction signal to follow actual write_ab signal
    which is based on aec and aec3 (delayed). This fixed a problem where
    the final cartridge was freezing on startup or when functions were
    invoked (probably due to bus contention)
    Move delayed aec signals into same process block
    Don't avoid address transition for column on refresh cycles even though it
    makes no diff, real chip probably doesn't do this
    Add WITH_BLITTER to config template
    Also deal with warning when we have ram but no hires modes
    [addressgen.v, registers.v, vicii.v]
2022-07-12 Allow configurable rgb without need rgb
    We should include the registers even though they don't change
    anything on boards that don't have rgb. This will make sure
    they make sense to anything that might be reading them (like
    my demo program).
    Also some comments updated here and there.
2022-07-12 Update 4E (mini) files to match hardware
    Previous was set to be compatible with prototype board
    which as T8 (only 4k ram) and was missing some signals
    that were later added on the final board. Prototype is
    dead from here on in.
    [top.v]
2022-07-13 Fix problem with golden images for efinix
    Page size has to be 4k because the efinix places the 2nd bitstream
    immediately after the first and it isn't divisible by 16k, so the
    last segment would always fail verification because it would bleed
    into the next (multiboot) image bytes.
    Also fixed an issue with hex to bit converter not handling lower
    case which was making golden bitstreams not load.
    [expert.c, multi_hex_to_bit.c]
2022-07-13 Remove defunct rev_4E
    This was the breadboard prototype for Efinix
2022-07-15 Fix variant identifiers and util disk build
    Only need 3T, 4LD, 4LH
    [init.c, kawari.h, util.c]
2022-07-16 Update flashtest for efinix boards
    Must use 4k pages.
2022-07-24 Turf the prototype mini, its dead
2022-08-01 Switch 4G to C3 timing model
2022-08-03 Get 4G board kind of working
    Stop using pins for mux hack, use syn_preserve instead
    Change optimization to CONGESTION_3
    Don't use async on serializer chain
    This works but GEN_RGB must be turned off. Can't seem
    to have both DVI and RGB at the same time like
    the Spartan. There is still a timing violation that
    needs to be fixed.
    [serializer.v, top.v]
2022-08-12 Make top.v files consistent
    Remove old mux hack from 4E and replace with new one from 4G
    (preserve)
    [top.v, vicii.v]
2022-08-21 Start keeping track of firmware history
2022-08-21 Add MK2 board timing option
    Need to re-test genuine C64 board performance.
    Need to verify MK2 board works.
2022-08-30 Get 4G working
    Clock domain crossing seems to have been the cause of
    DVI issue. Critical path of encoded tmds on 4x to
    serializer on 40x but I *think* this is expected.
    [serializer.v]
2022-09-01 Put back ado for real boards
    Only move ado set earlier for MK2. This ended up
    causing a glitch on real motherboards. Maybe
    need to ifdef out the else clause instead?
    [addressgen.v]
2022-09-01 Fix bad NTSC colors on LCD monitor via VGA
    Some monitors seem to be picky about horizontal timing.
    These settings fixed my Gateway monitor and brightened
    up my Acer. More testing in the field is necessary.
    [hires_vga_sync.v, registers.v]
2022-09-02 Fixes #6
    NTSC horizontal sync and back porch were confusing some LCD
    monitors resulting in dark picture.
    [menu.c]
2022-09-07 4G working with no timing problems
    Also changed some blocking assignments to non blocking
    in comp_sync
    [comp_sync.v, cycles.v, serializer.v]
2022-09-23 MK2_TIMING ado set time was (probably) wrong
    Make ado set at [2] which was the point of moving
    ado set immediatley after vic_addr in the same
    process block.
    [addressgen.v]
2022-09-26 POV BOM instructions
2022-10-29 Add newdev test
    Switch to pal or ntsc and run tests
2022-10-30 Switch to linux for efinix builds
2022-11-13 cpu_reset assignment was missing from 4G top
    [top.v]
2022-11-27 Have separate DVI and RGB firmware for Efinix LG
    The timing between DVI and RGB is different. The DVI
    timing doesn't look good on RGB and vice versa. So
    going to have separate firmware for each and the user
    will have to flash which one they want.
    [top.v]
2022-11-30 Fix build errors with simulator
    [registers.v]
2022-12-05 Only show functions relevant for board caps
    CONFIG should only show things you can change for the
    board/firmware that you have.
2022-12-23 Fix ntsc_50/pal_60 options showing up when they should not
    Also updated some docs
    [menu.c]
2023-01-17 Add even_odd fix and fix simulator build/runtime
    Added even_odd fix to deal with some monitors not liking odd width
    Added efinix flag to sim build
    Added cfg version set on board init
    Centered efinix pal dvi better
    Bump to 1.12
    [constants.h, hires_dvi_sync.v, hires_vga_sync.v, init.c, kawari.h, menu.c, registers.v]
2023-01-17 Remove even_odd flags for now
    Removing these until I get an idea of how common this
    problem is.
    [hires_dvi_sync.v, kawari.h, menu.c, registers.v, vicii.v]
2023-01-17 Fix mini ntsc_50/pal_60 using wrong color clock
    Oops
    [top.v]
2023-01-17 Fix composite timing
    Original composite timing was off for all chips. This brings them in line
    with the original chips.
    Thanks to MathOp37 for providing the correct timing values
    [comp_sync.v]
2023-01-18 Fix issues with vsync. Closes #15
    Color burst should not have been active on vblank start or
    anywhere within vblank.
    Visible end line should be a blank line
    Changed sim_main.cpp to match comp_sync.v behaviour so sync lines show
    what's happening.
    [comp_sync.v]
2023-01-22 Equivalent to previous address gen but cas/ras shift regisers corrected
    They were not starting aligned in the simulator which made picking
    cas/ras timing values difficult.
    [addressgen.v]
2023-01-27 fixed pal_50 -> pal_60
    [top.v]
2023-01-29 Oops - wrong MUX
    Mistakenly checked in experimental mux point that does not match
    CAS/RAS fall times.
    [addressgen.v]
2023-01-31 Extend color burst signal
    This fixed B/W image using PAL motherboard clock on a PVM
    (but not RetroTink).
    Video specs say you need 9 periods but the original
    chip does way more (like almost 20).
    [comp_sync.v]
2023-02-01 Fix analog RGB sync values
    Screen was shifted to the left 10 pixels
    Sync should have started at 0
    Added -a option to sim to show active region
    Removed 1x from dvi sync as it will never work
    [constants.h, hires_dvi_sync.v, hires_vga_sync.v, menu.c, registers.v]
2023-02-02 Bail if board type differs unless user says Y
2023-02-05 Sprite collision bug fix
    Logic was ignoring 2nd bit of multi color index when
    determining sprite collisions. Pitfall 2 baloon grab was
    impossible.
    [sprites.v]
2023-02-08 Make no-eeprom build come out of reset (almost) immediately
    Fix build issue with no luma
    [top.v]
2023-02-10 Change naming convention again
    Use <BRANCH><BOARD>[-SUBVARIANT]
    Branch = 4 chars
    Board = 2 chars
    Subvariant optional
2023-02-12 (Possibly) fix PAL_60 issue with R8
    R8 color burst start was wrong
    [comp_sync.v]
2023-02-14 Use continuous assignment for sinewave table
    This eliminates timing violation for sineROMAddr
    to SINEWAVE but not sure why it was a problem
    in the first place.
    [comp_sync.v]
2023-03-03 Make dvi_sync gen more like vga_sync gen
    Saw that for 6567 chips the blanking period was
    below the minimum 128 pixels required by the DVI
    spec. Could explain some sync issues with some
    monitors. Increased to 128. PAL chips were already
    past min.
    [constants.h, hires_dvi_sync.v, hires_vga_sync.v]
2023-03-05 Register the cas/ras signals
    Continuous assignment will allow transitions / glitches
    outside of the guarantees of registered outputs. This
    makes the cas/ras rise/fall valid on clock edges and
    consistent.
    [addressgen.v, top.v]
2023-03-07 Split addrgen into effinix & spartan versions
    Can't get spartan to work with col16x timing like
    on efinix. Splitting addressgen module into efinix
    and spartan versions. Consequence is spartan board
    will have compatibility issues with some sram.
    [addressgen_efinix.v, addressgen_spartan.v, hires_dvi_sync.v, serializer.v, top.v, vicii.v]
2023-03-08 Try to improve DVI sync
    Noticed DVI timings were out of spec. DVI spec says
    hsync must be at least 128 pixels wide. Our sync period
    was shy for all 3 models. Bringing sync period up to 128
    (64 for native res because is doubled in x dir). Also
    made sure that serializer was actually using the reset
    signal. So now the clock and control registers don't
    get activated until after the chip is selected.
    This seems to have improved NTSC syncing a lot on this
    particular monitor and a bit of improvement for PAL.
    PAL failure to sync on LG monitor still needs
    investigating but prior to this CL, the LG monitor
    was not syncing at all or had frequent black
    screen boots.
    [hires_dvi_sync.v, serializer.v, top.v]
2023-03-10 Undo dumb mistake with pal/ntsc sr shifting
    [addressgen_efinix.v]
2023-03-11 Make simulator more accurate wrt eeprom behavior
    When we include eeprom logic, set data as though we
    read it from the eeprom. We can then test not only
    the chip setting logic but also the display flags and
    other registers that should be restored from eeprom.
    This change also makes sure that the dvi serializer
    and other modules don't do anything until reset has
    been lifted and also makes sure no display related
    flags are changed after the reset lift point. Prior
    this this CL, display flags could have been changed
    after reset lift and that could have confused the
    dvi sync gen.
    [registers.v, top.v, vicii.v]
2023-03-12 Make vga/dvi sync generators more consistent with comp
    Register hsync/vsync/active signals
    Make hsync/vsync signals align better with comp sync
    Fix bad range addition logic in configurable timing block
    Hopefully will be better dvi sync behavior (need to test)
    [hires_dvi_sync.v, hires_vga_sync.v, vicii.v]
2023-03-12 Deal with some timing violations
    Add some synchronizer chains to transfer signals
    from dot4x to dvi clock.
2023-03-12 Fix sync / active signals now that vs_sta > 0
    Need extra logic to make sure every scan line is complete before
    triggering vertical sync.
    [hires_dvi_sync.v, hires_vga_sync.v]
2023-03-12 Fix build issue with 4G RB
    Forgot guards
    [top.v]
2023-03-23 Fix bad active logic for dvi/rgb sync modules
    This was causing bad sync on LG monitor. Simplifying
    logic to simple OR of hactive and vactive regions.
    [hires_dvi_sync.v, hires_vga_sync.v]
2023-03-24 Refuse to flash if board does not match
    Instead of prompting with a warning msg,
    user would have to manually edit info
    file if they want to override this. This
    is safer as 2 users have already said
    Y despite the warning.
2023-03-24 Update to raspberry pi flash utility
2023-04-04 Remove even/odd fix text
    Should have been removed
    [menu.c, util.h]
2023-04-11 Fix 4L build
    Need the flash_busy assignment or else ISE
    eliminates the entire flash IP!
    Also needed some updates to build and
    top.prj
    [registers.v]
2023-04-15 Get ntsc_50 working on spartan6 board
2023-04-16 Update FIMRWARE links for spartan boards
2023-04-18 Add a digital audio player
    Putting this somewhere so I don't lose it. A digital sample
    player with 4:1 compression ratio. See README.md for more
    details.
2023-06-01 Begin 1.16
    Blitter bug! Alignment calc was using wrong registers.
    [registers.v]
2023-06-03 Fix another blitter bug
    dest bits were not being shifted after all src pixels were
    written, leaving right edges of blits destroying existing
    pixels (happened on 640x200 mode)
    [registers.v]
2023-06-03 Fix missing begin end on last commit
    [registers.v]
2023-06-05 dma irq test
2023-06-06 Add DMA irq status and control bits
2023-06-06 Fix compilation issue with sim
    [registers.v]
2023-06-07 Add ability to DMA copy into overlay
    Does not work for fill or any other dma operation, only copy.
    [registers.v]
2023-06-07 Make LH output dotclock
    Cleanup all dotclock stuff
    Also Add test case for dma copy to overlay ram
2023-07-30 Fix dotc variant for 1.5 board
    [top.v]
2023-08-13 Correction to comments in hires_vga_sync
    [hires_vga_sync.v]
2023-08-14 Don't straddle 0 for PAL active region
    Don't cross 0 for active values.
    Also fix simulator problem whereby max width
    and other params weren't getting set when run
    for simulator builds.
    [hires_dvi_sync.v]
2023-08-20 Split builds into 27MHZ and 29HZ PAL resolutions
2023-08-20 Add legacy dvi timing file in case we need to build with it
    This matches the logic we released between 14 and 16 inclusive.
    But there were some issues with the way timing was handled.
2023-08-20 Add 32Mhz configs for sum
    Also eliminate one negation for pal vactive
    Can't actually build a 32mhz for ntsc/pal yet since we don't
    have an actual full resolution dvi clock available. But it
    can be done. However, it may exceed the capabilities of the
    board. Doing for simulation only.
2023-08-26 Adding interpolating scaler for 27mhz modes
    Optional. Better compatibility with some TVs.
    But scaling hires modes doesn't look good. Need
    to document the trade-off.
    [hires_dvi_sync_scaled.v, registers_scaled.v]
2023-09-04 Replace with latest sample thumbnailes for scaled/unscaled
2024-01-05 Fix lumacode init value
    Should default to 0
    Fixed duplicate line in _scaled.v version
    [registers.v, registers_scaled.v]
2024-02-01 Fix spartan builds (sort of)
    Design does not fit on spartan6 any more. But if
    64k is reduced to 32k it can fit. Perhaps some
    other optimizations can be found. The blitter is
    the last feature that pushed it over the edge.
    [top.v]
2024-02-25 Fix RGB large board build
    Was broken due to missing .sdc and peri.xml files. Config
    file also missing defines.
2024-02-25 Bump to 1.18 and add missing RGB build for large board
2024-02-25 Fix Saruman issue
    A batch of Saruman boards were made with a differnet SRAM chip
    The new SRAM chip is faster to disengage output lines after
    OE goes high. Kawari was reading invalid data because the
    address lines became invalid during the dot4x tick. SO this
    appears to always have been an issue just DRAM and other SRAM
    chips didn't have an issue because they are slower to disengage.
    [addressgen_efinix.v]
2024-03-11 Revert "Fix Saruman issue"
    This reverts commit 90decac8544983375c2e6b9bc2e4fcc13224b0f2.
    [addressgen_efinix.v]
2024-03-11 Move casras rise times again as last 'fix' caused a regression
    Last fix was reverted and caused a regression with super Zaxxon
    cartridge. This moves cas/ras fall times again which appears
    to work on all static ram as well as DRAM. Needs thorough
    testing.
    [addressgen_efinix.v]
2025-01-23 Remove aec delay
    Could be the cause of some glitching on some DRAM glitches.
    Testing required.
    [vicii.v]
2025-01-23 Fix DRAM refresh counter behavior
    Don't decrement on last line, hold at 0xff Caused some address sniffing
    devices to get confused. First refresh row address should be 0xff on
    line 0 for first refresh cycle.
    Bump version to 1.19
    [addressgen_efinix.v, addressgen_spartan.v, constants.h, vicii.v]
2025-01-23 Some more optimization with regs
    Eliminate stage0, stage1, hires_stage0, hires_stage1
    as they already have equivalent signals from dot_rising
    hires_stage0 = dot_rising[2] | dot_rising[0]
    hires_stage1 = dot_rising[3] | dot_rising[1]
    stage0 = dot_rising[2]
    stage1 = dot_rising[3]
2025-01-23 Fix to prev DRAM refresh pattern
    Last line should start with 0xff but was not due to
    not being reset during hold before it was used. Added
    a reset on the L_SP cycle type if refc_hold is set
    to make sure all refresh counters on the last line
    are 0xff.
    [addressgen_efinix.v, addressgen_spartan.v]
2025-01-23 Remove unused regs related to H/W halving
    No longer supported.
    [hires_dvi_sync.v, hires_dvi_sync_scaled.v, vicii.v]
2025-01-23 Add checksum to flash program
    Add checksum bytes to the end of every segment.
    Drive integrity check will try the first few
    segments and ensure the checksums match. If
    not, flash will be aborted before it is
    erased.
    Had to move scratch space from $5000 to $6000
    and the loader from $9000 to $a004. Spartan
    flash images unlikely to be supported but keeping
    the 16k space available just in case.
2025-01-23 Revert "Remove aec delay"
    This reverts commit 95a6b4fc60bb094d74e7ed6e47287b88436ded31.
    [vicii.v]
2025-01-23 Some changes to constraints files
    Some false paths were not correct. Adding false paths for clock domain crossings
    that are known to have synchronizer chains to deal with it.
2025-01-23 Remove unnecessary synchronizer chain for active buf
    Don't need this.
2025-04-19 Make TeensyROM version of flash for quick flashing option
2025-04-20 Remove Spartan6 builds
    Not supported as current image no longer
    fits on the Spartan6. No future builds
    possible.
    [menu.c]
2025-05-17 Document 250469 DMA xfer workaround
2025-09-17 Update REGISTERS.md
    LB/HB order fixed in example code
    VIDEO_MEM_A_* --> VIDEO_MEM_1_* consitently
    Added register addresses to tables to improve readability (similar to the Blitter section)
    corrected comment about size of DMA operations
