randyrossi/vicii-kawari/(notices)

Notices in the files:
hdl/xilinx_spartan6/dot4x_cc_clockgen.v:
This program is free software: you can redistribute it and/or modify
it under the terms of the GNU General Public License as published by
the Free Software Foundation, version 3.
